BYakov/Rx-Tx_module/PCB/таблица.docx

Название | значение | ссылка | Цена за шт | доставка
С1 | 0.56 пФ
С2 | 330 пФ | https://procontact74.ru/01-elektronnyie-komponentyi-/41-kondensatory/416-smd/330-pf-41628 | 0.90р (от 1 шт)
С3 | 330 пФ | https://procontact74.ru/01-elektronnyie-komponentyi-/41-kondensatory/416-smd/330-pf-41628 | 0.90р (от 1 шт)
С4 | 47 нФ | https://procontact74.ru/01-elektronnyie-komponentyi-/41-kondensatory/chip-1206/chip-1206-----47-nf-50v | 0.90р (от 1 шт)
С5 | 47 нФ | https://procontact74.ru/01-elektronnyie-komponentyi-/41-kondensatory/chip-1206/chip-1206-----47-nf-50v | 0.90р (от 1 шт)
С6 | 47 нФ | https://procontact74.ru/01-elektronnyie-komponentyi-/41-kondensatory/chip-1206/chip-1206-----47-nf-50v | 0.90р (от 1 шт)
С7 | 330 пФ | https://procontact74.ru/01-elektronnyie-komponentyi-/41-kondensatory/416-smd/330-pf-41628 | 0.90р (от 1 шт)
С8 | 4.7n | https://procontact74.ru/01-elektronnyie-komponentyi-/41-kondensatory/416-smd/47-nf-41637 | 0.90р (от 1 шт)
C9 | 57n
C10 | 1u | https://procontact74.ru/01-elektronnyie-komponentyi-/41-kondensatory/416-smd/1-uf-41649 | 2.55 (от 1шт)
C11 | 2.2u
C12 | 0.1u | https://procontact74.ru/01-elektronnyie-komponentyi-/41-kondensatory/chip-1206/100-nf-1206-41658 | 2.55 (от 1шт)
C13 | 0.1u | https://procontact74.ru/01-elektronnyie-komponentyi-/41-kondensatory/chip-1206/100-nf-1206-41658 | 2.55 (от 1шт)
C14 | 0.01u | https://procontact74.ru/01-elektronnyie-komponentyi-/41-kondensatory/chip-1206/10-nf-1206-41657 | 1.7р (от 1шт)
C15 | 0.01u | https://procontact74.ru/01-elektronnyie-komponentyi-/41-kondensatory/chip-1206/10-nf-1206-41657 | 1.7р (от 1шт)
C16 | 0.01u | https://procontact74.ru/01-elektronnyie-komponentyi-/41-kondensatory/chip-1206/10-nf-1206-41657 | 1.7р (от 1шт)
C17 | 0.01u | https://procontact74.ru/01-elektronnyie-komponentyi-/41-kondensatory/chip-1206/10-nf-1206-41657 | 1.7р (от 1шт)
C18 | 1u | https://procontact74.ru/01-elektronnyie-komponentyi-/41-kondensatory/416-smd/1-uf-41649 | 2.55 (от 1шт)
C19 | 1u | https://procontact74.ru/01-elektronnyie-komponentyi-/41-kondensatory/416-smd/1-uf-41649 | 2.55 (от 1шт)
C20 | 0.01u | https://procontact74.ru/01-elektronnyie-komponentyi-/41-kondensatory/chip-1206/10-nf-1206-41657 | 1.7р (от 1шт)
C21 | 100p | https://procontact74.ru/01-elektronnyie-komponentyi-/41-kondensatory/416-smd/100-pf-41622 | 1.7р (от 1шт)
C22 | 100p | https://procontact74.ru/01-elektronnyie-komponentyi-/41-kondensatory/416-smd/100-pf-41622 | 1.7р (от 1шт)
C23 | 100p | https://procontact74.ru/01-elektronnyie-komponentyi-/41-kondensatory/416-smd/100-pf-41622 | 1.7р (от 1шт)
C24 | 100p | https://procontact74.ru/01-elektronnyie-komponentyi-/41-kondensatory/416-smd/100-pf-41622 | 1.7р (от 1шт)
C25 | 0.1u | https://procontact74.ru/01-elektronnyie-komponentyi-/41-kondensatory/chip-1206/100-nf-1206-41658 | 2.55 (от 1шт)
C26 | 100p | https://procontact74.ru/01-elektronnyie-komponentyi-/41-kondensatory/416-smd/100-pf-41622 | 1.7р (от 1шт)
C27 | 0.1u | https://procontact74.ru/01-elektronnyie-komponentyi-/41-kondensatory/chip-1206/100-nf-1206-41658 | 2.55 (от 1шт)
C28 | 100p | https://procontact74.ru/01-elektronnyie-komponentyi-/41-kondensatory/416-smd/100-pf-41622 | 1.7р (от 1шт)
C29 | 100p | https://procontact74.ru/01-elektronnyie-komponentyi-/41-kondensatory/416-smd/100-pf-41622 | 1.7р (от 1шт)
R1 | 680 | https://procontact74.ru/01-elektronnyie-komponentyi-/40-rezistory/chip-0603/chip-0603-----680-om-0603-rezistor | 0.45p (от 1шт)
R2 | 4.7K | https://procontact74.ru/01-elektronnyie-komponentyi-/40-rezistory/407-chip-0805/47-kom-40746 | 0.85р (от 1шт)
R3 | 180 | https://procontact74.ru/01-elektronnyie-komponentyi-/40-rezistory/chip-0603/160-om-0603-rezistor | 0.45p (от 1шт)
R4 | 10 | https://procontact74.ru/01-elektronnyie-komponentyi-/40-rezistory/chip-0603/10-om-0603-rezistor | 0.45p (от 1шт)
R5 | 97.6
R6 | 15 | https://procontact74.ru/01-elektronnyie-komponentyi-/40-rezistory/chip-0603/chip-0603------15-om-0603-rezistor | 0.45p (от 1шт)
R7 | 51.1
R8 | 50
R9
