BYakov/Rx-Tx_module/Доки/Belkin.pdf

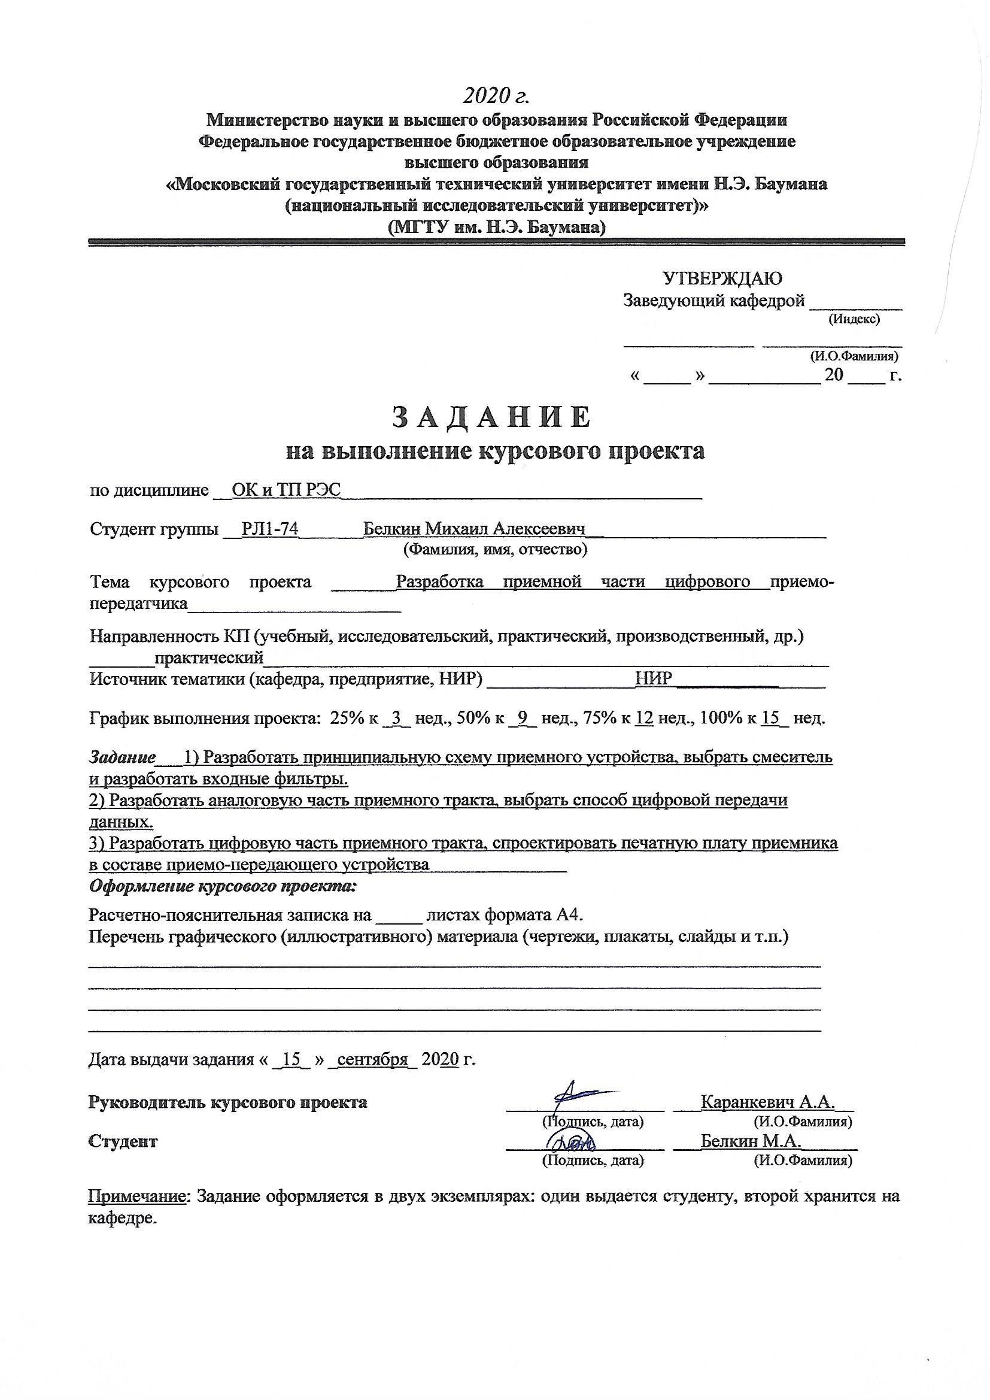
[picture p12: page 1]
