BYakov/Rx-Tx_module/Доки/Bonnet.pdf

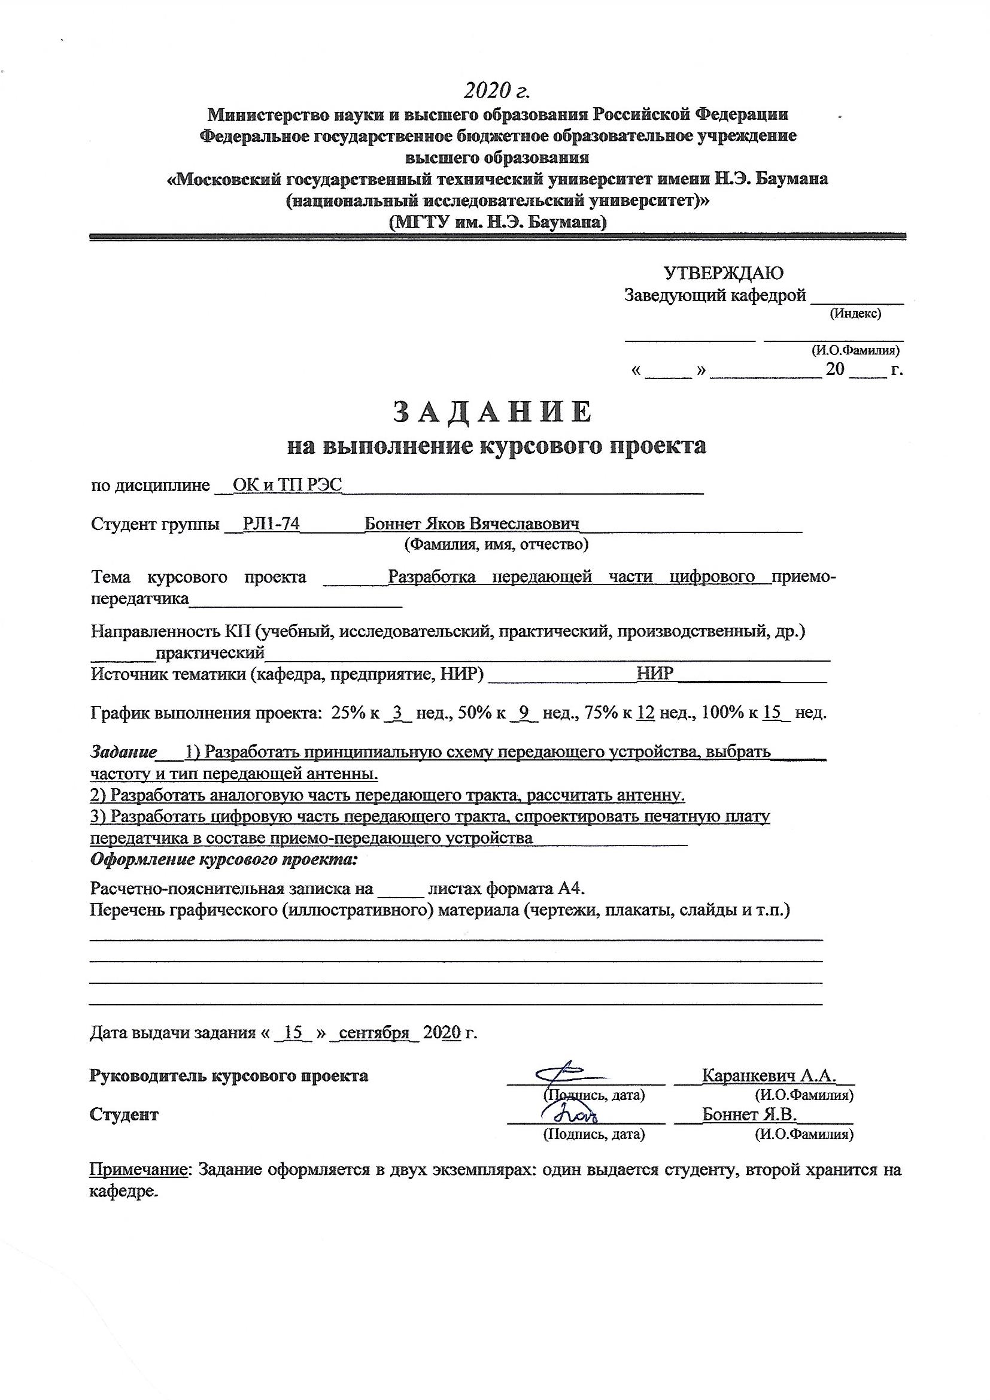
[picture p13: page 1]
