BYakov/Rx-Tx_module/PCB/BGU.bmp

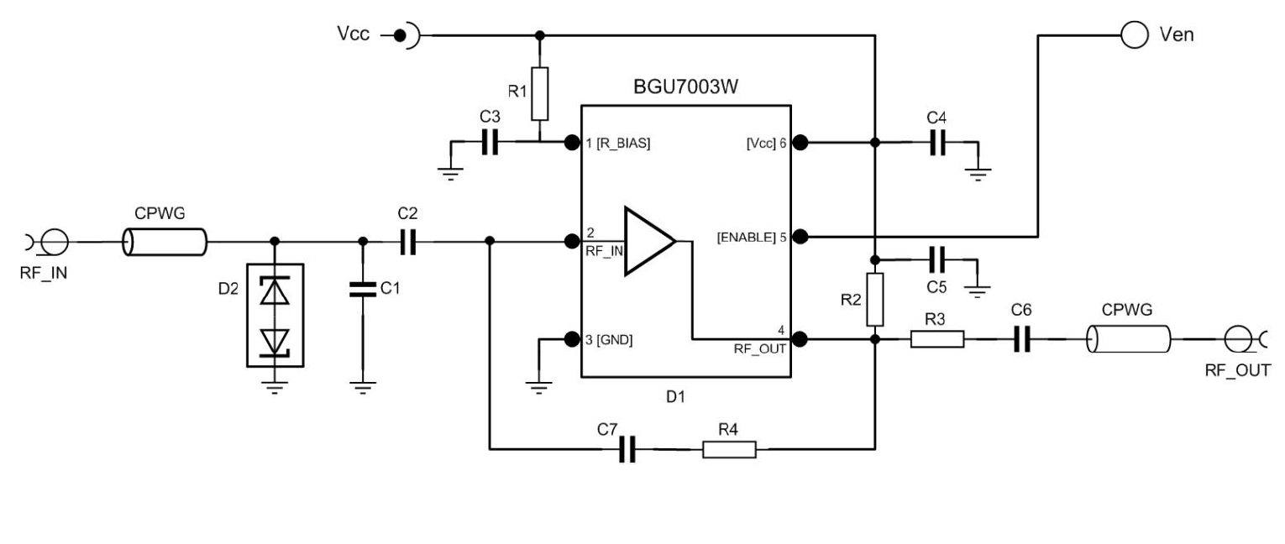
PCB/BGU.bmp
