BYakov/Rx-Tx_module/PCB/moustache-monocle-hairstyle.jpg

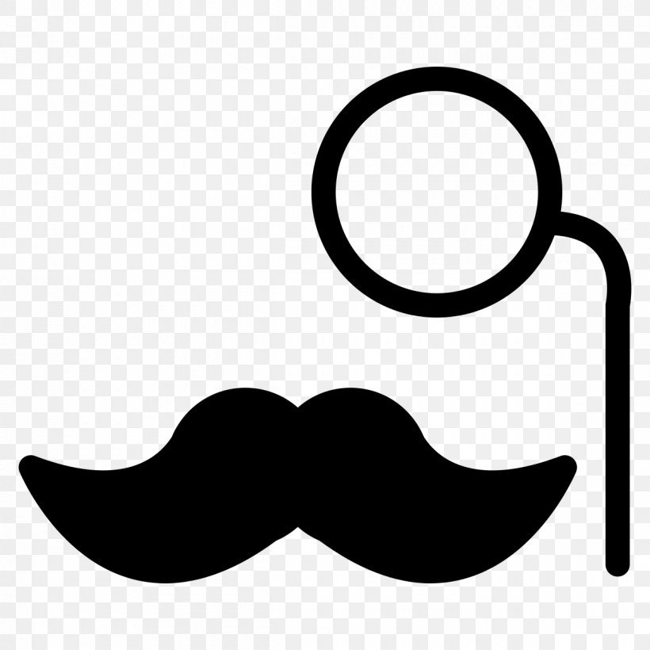
PCB/moustache-monocle-hairstyle.jpg
