BYakov/Rx-Tx_module/PCB/Screenshot_1.png

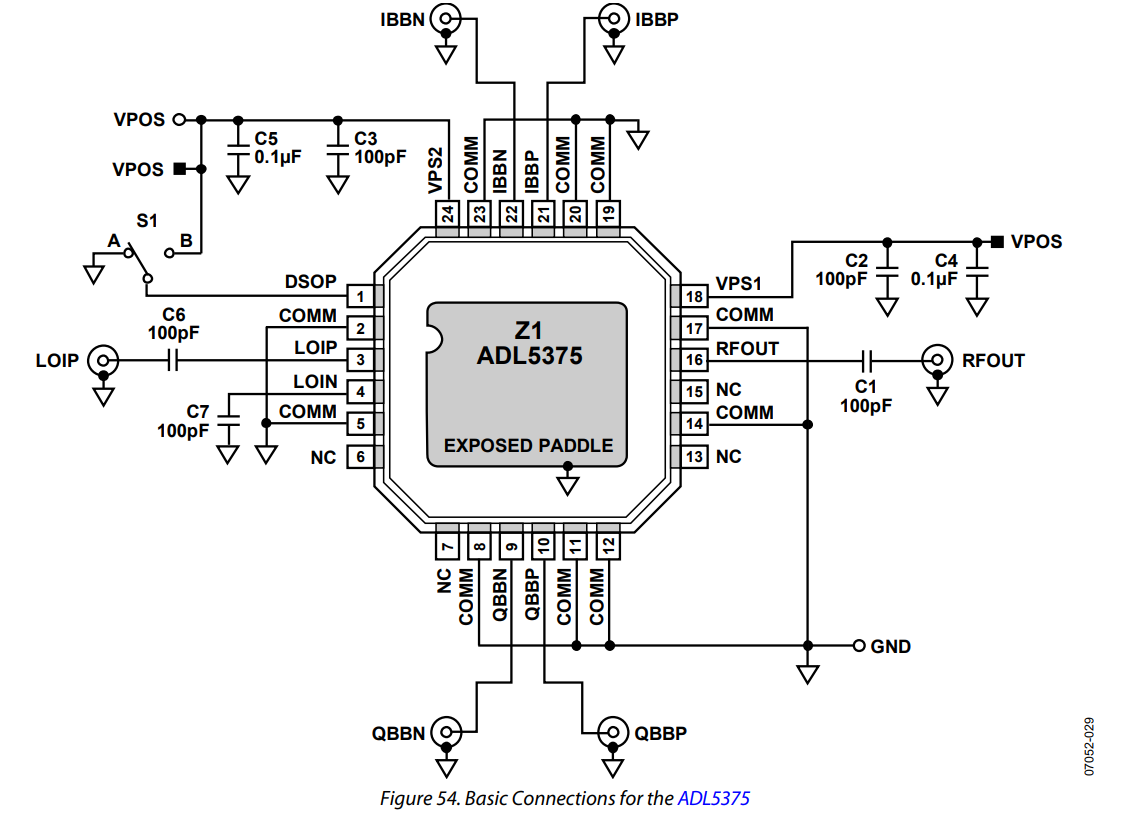
PCB/Screenshot_1.png
