BYakov/Rx-Tx_module/PCB/Screenshot_2.png

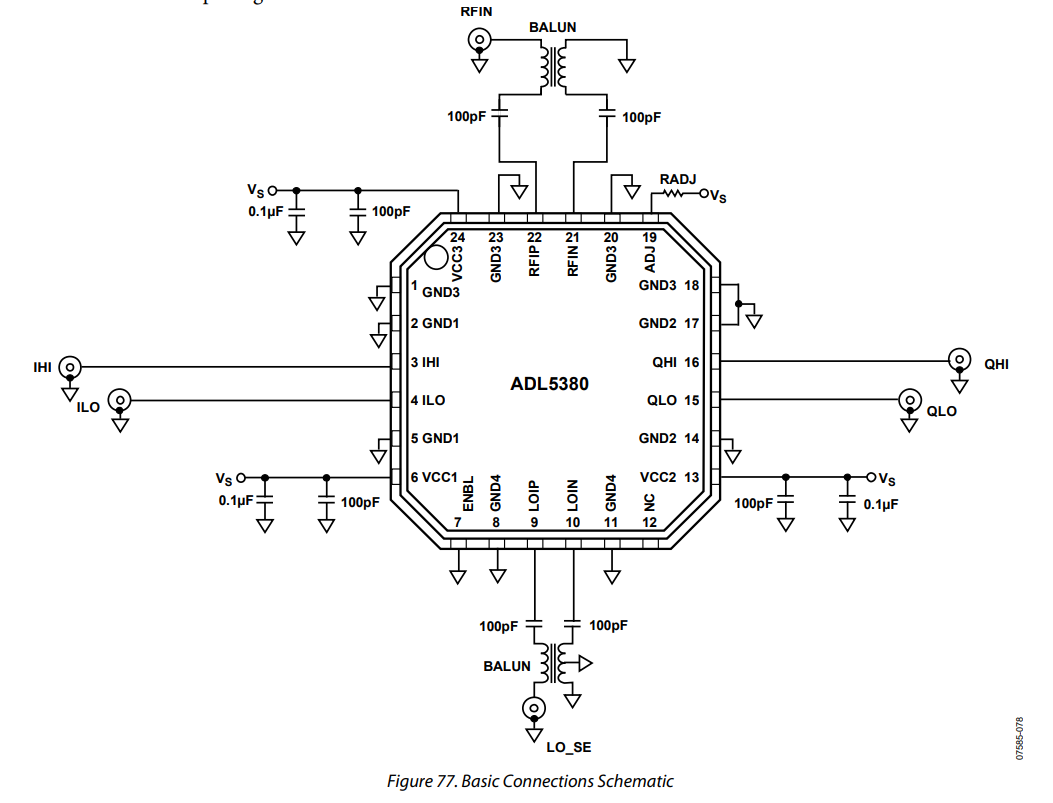
PCB/Screenshot_2.png
