BYakov/Rx-Tx_module/PCB/Screenshot_3.png

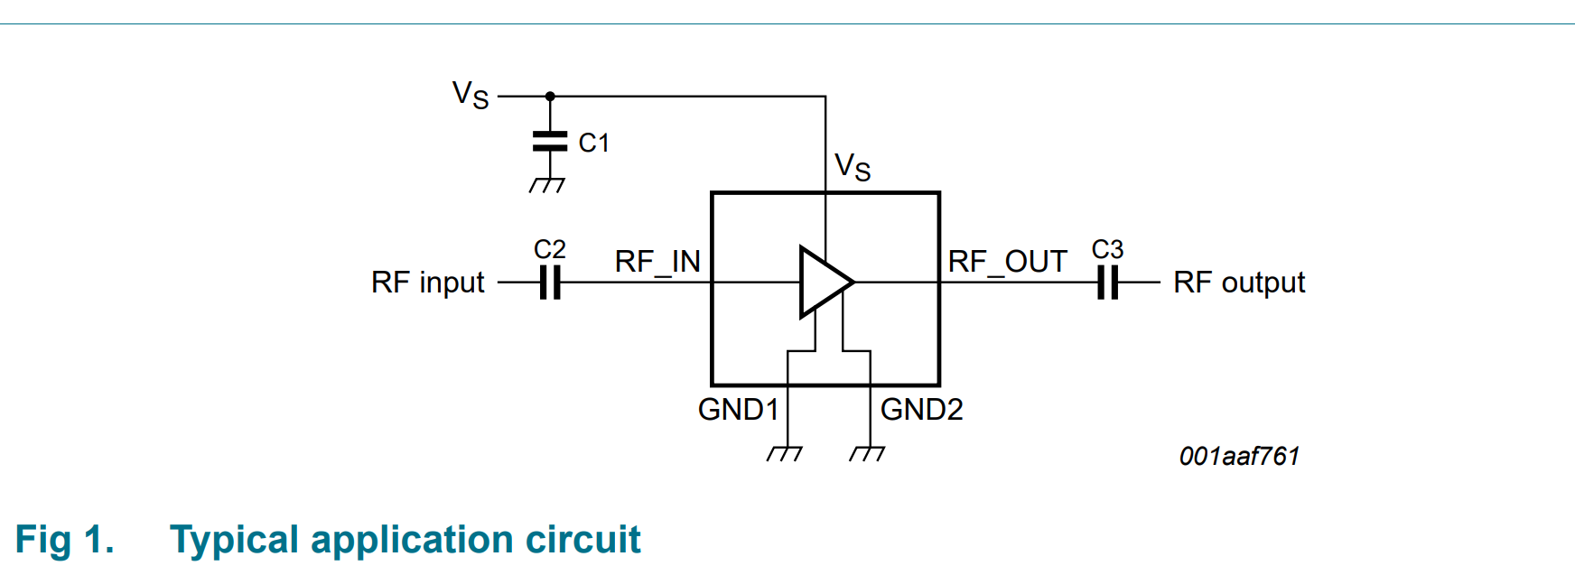
PCB/Screenshot_3.png
