BYakov/Rx-Tx_module/PCB/Screenshot_5.png

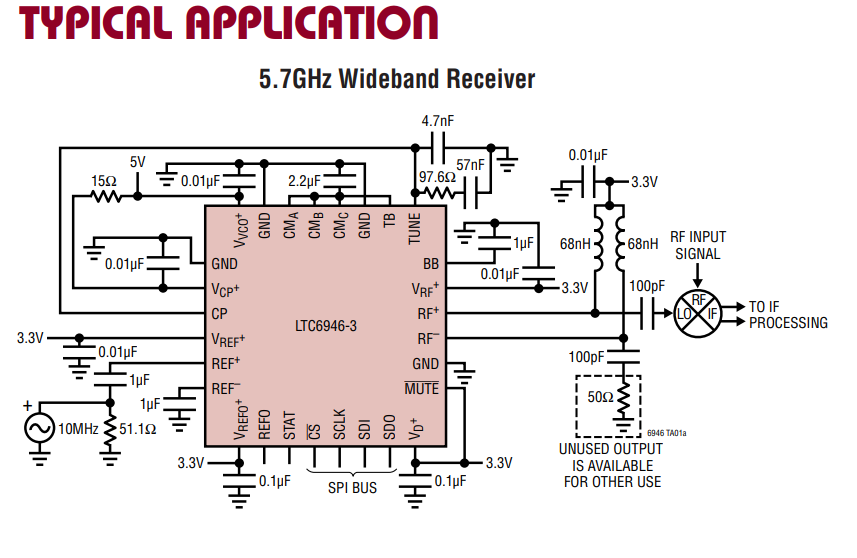
PCB/Screenshot_5.png
