BYakov/Rx-Tx_module/PCB/shark.png

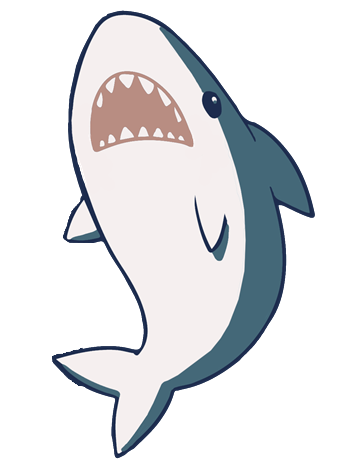
PCB/shark.png
