BYakov/Rx-Tx_module/PCB/номиналы для BGU.png

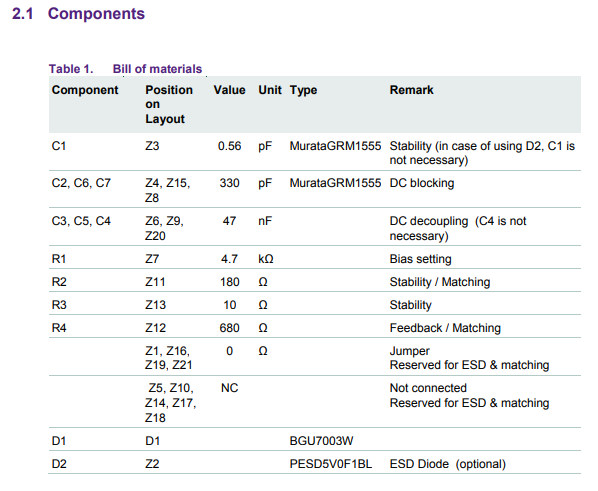
PCB/номиналы для BGU.png
