BYakov/Rx-Tx_module/Аналоговая часть/Разбор/20201021_194957.jpg

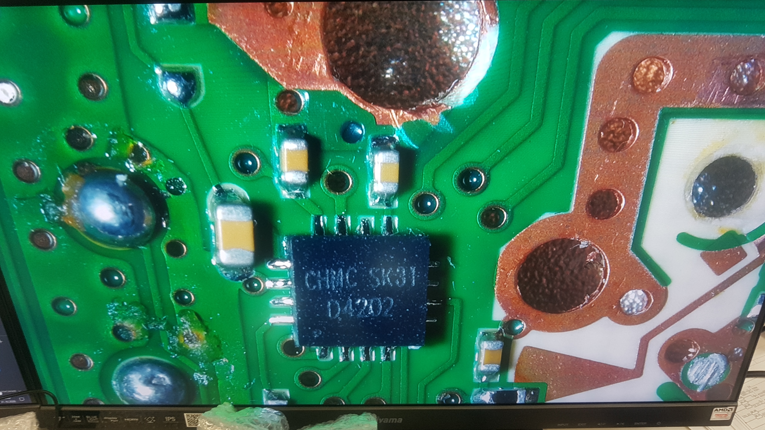
Аналоговая часть/Разбор/20201021_194957.jpg
