BYakov/Rx-Tx_module/Аналоговая часть/Разбор/20201021_195349.jpg

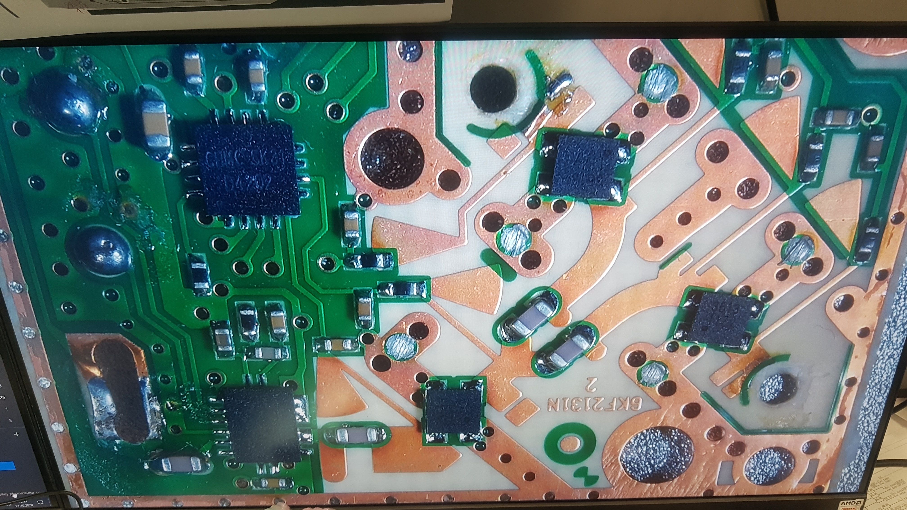
Аналоговая часть/Разбор/20201021_195349.jpg
