BYakov/Rx-Tx_module/Отчет Боннет/Групповая задержка.png

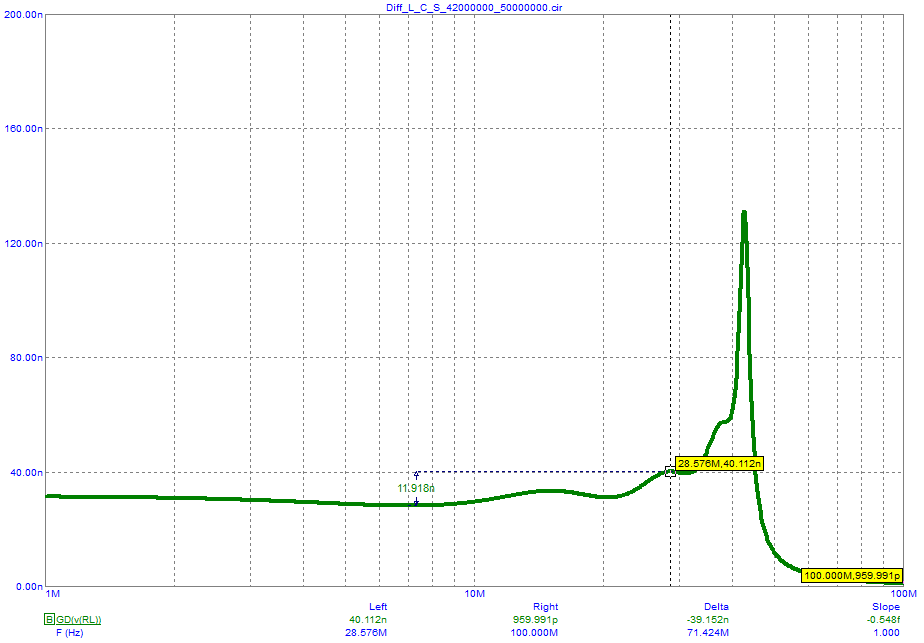
Отчет Боннет/Групповая задержка.png
