BYakov/Rx-Tx_module/Отчет Боннет/Зона найквиста.png

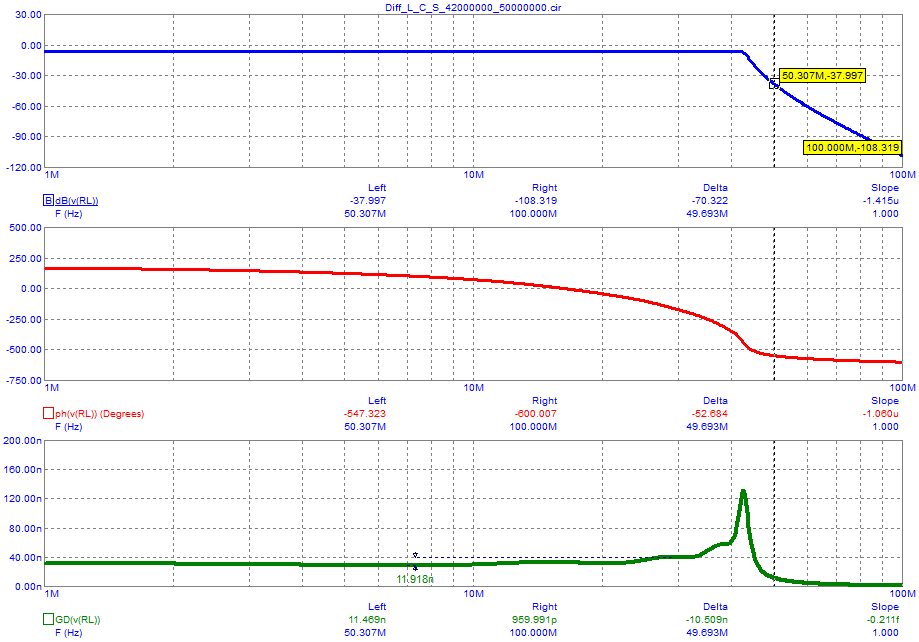
Отчет Боннет/Зона найквиста.png
