BYakov/Rx-Tx_module/Отчет Боннет/Класс печатных плат.png

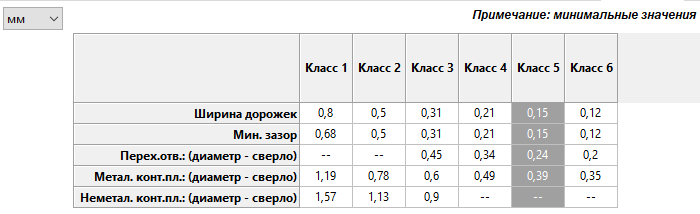
Отчет Боннет/Класс печатных плат.png
