BYakov/Rx-Tx_module/Отчет Боннет/Класс цепей.png

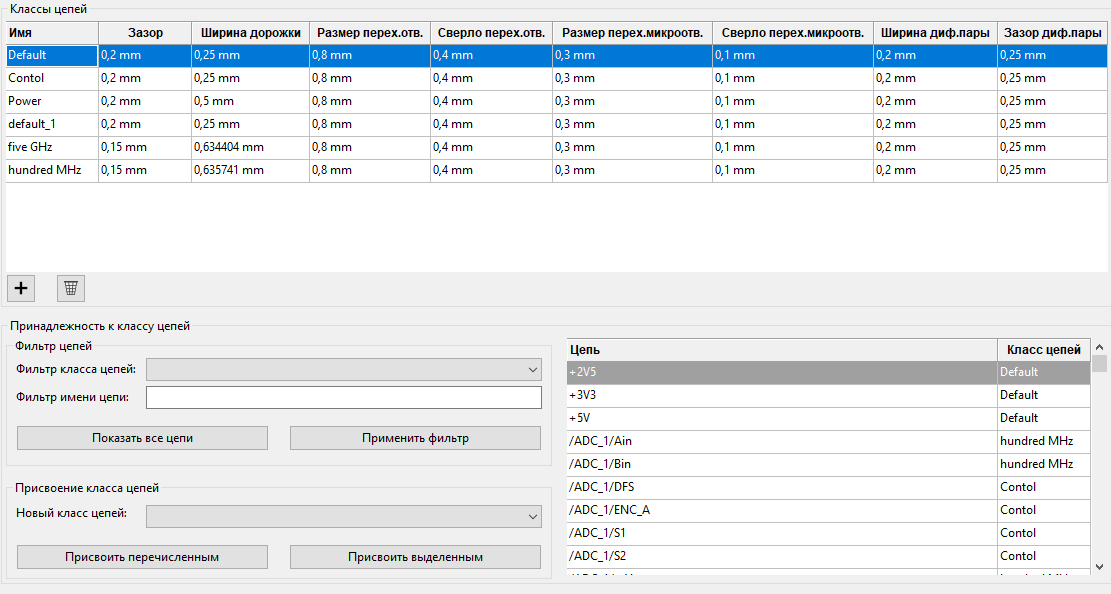
Отчет Боннет/Класс цепей.png
