BYakov/Rx-Tx_module/Отчет Боннет/МШУ усиление.PNG

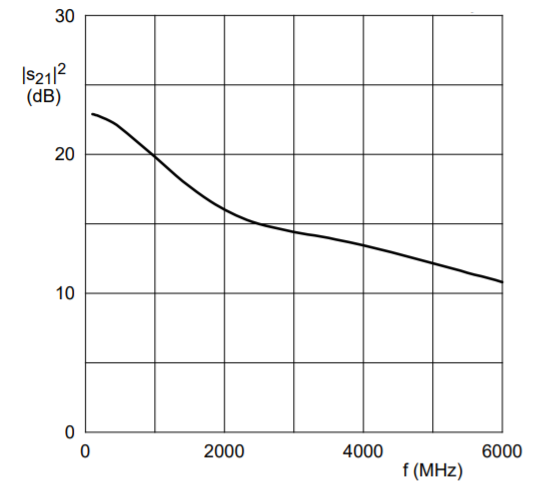
Отчет Боннет/МШУ усиление.PNG
