BYakov/Rx-Tx_module/Отчет Боннет/Не балансный.png

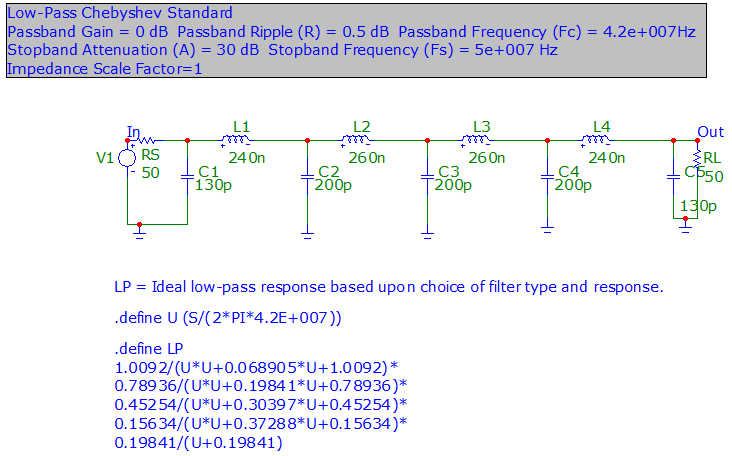
Отчет Боннет/Не балансный.png
