BYakov/Rx-Tx_module/Отчет Боннет/Обвязка АЦП.PNG

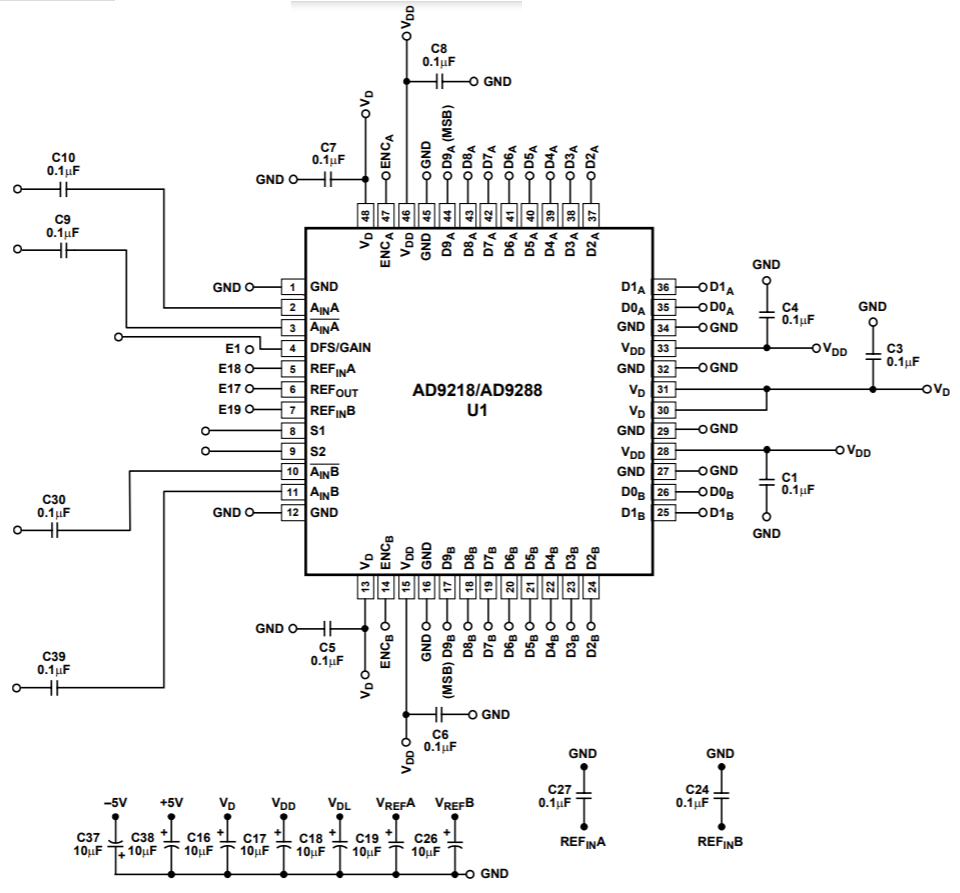
Отчет Боннет/Обвязка АЦП.PNG
