BYakov/Rx-Tx_module/Отчет Боннет/Обвязка генератора.PNG

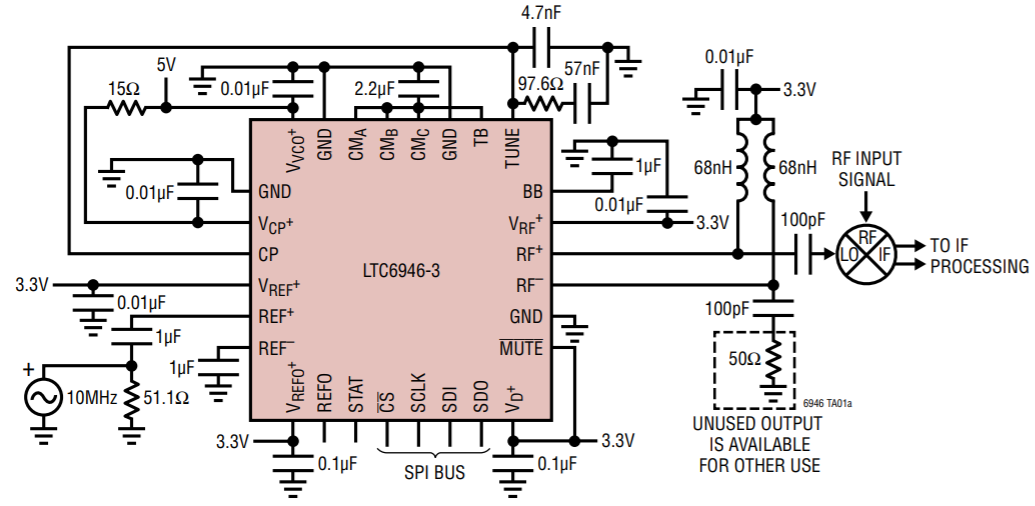
Отчет Боннет/Обвязка генератора.PNG
