BYakov/Rx-Tx_module/Отчет Боннет/Обвязка демодулятора.PNG

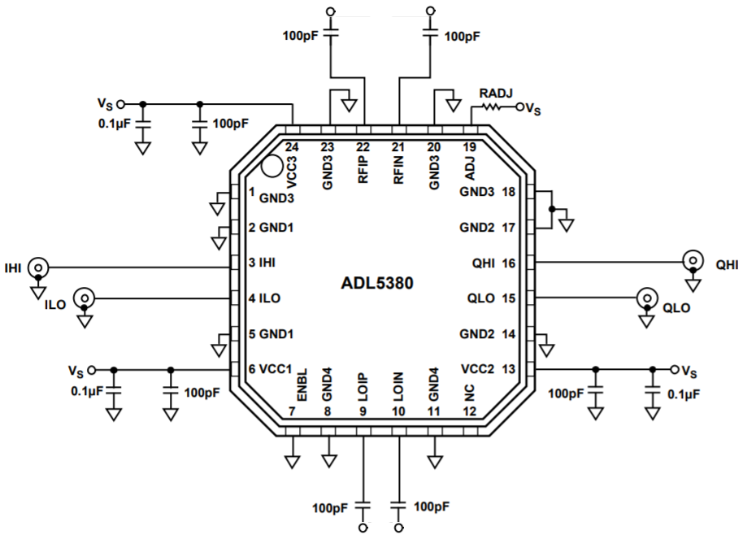
Отчет Боннет/Обвязка демодулятора.PNG
