BYakov/Rx-Tx_module/Отчет Боннет/Обвязка модулятора.PNG

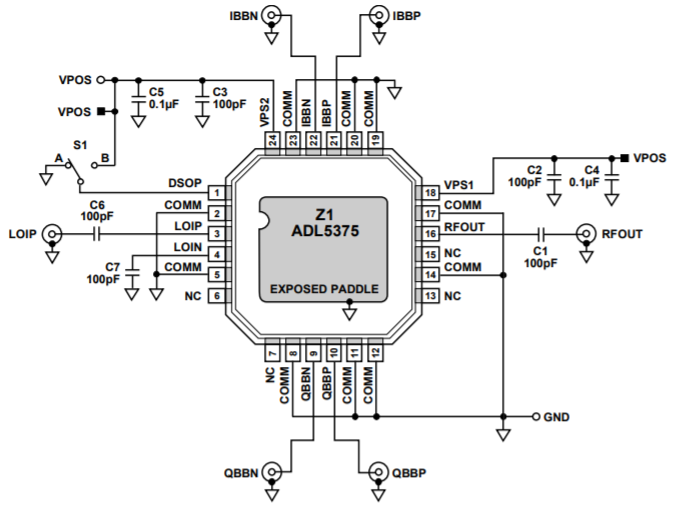
Отчет Боннет/Обвязка модулятора.PNG
