BYakov/Rx-Tx_module/Отчет Боннет/Обвязка МШУ.PNG

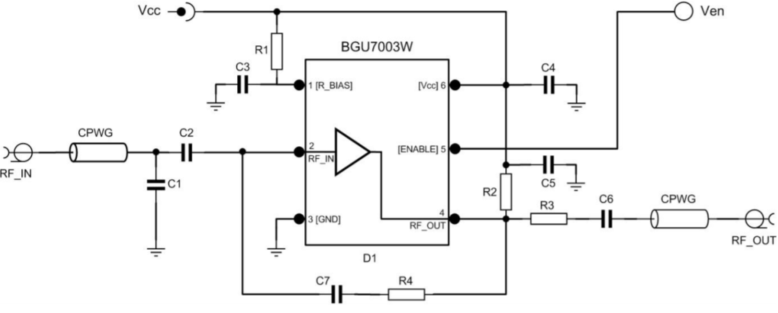
Отчет Боннет/Обвязка МШУ.PNG
