BYakov/Rx-Tx_module/Отчет Боннет/Обвязка оконечного усилителя.PNG

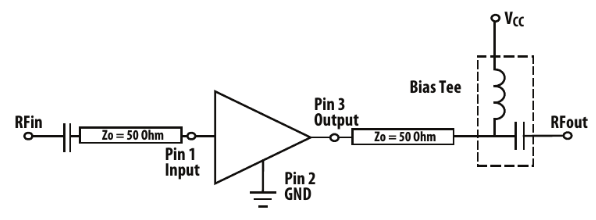
Отчет Боннет/Обвязка оконечного усилителя.PNG
