BYakov/Rx-Tx_module/Отчет Боннет/Обвязка стабилизатора.PNG

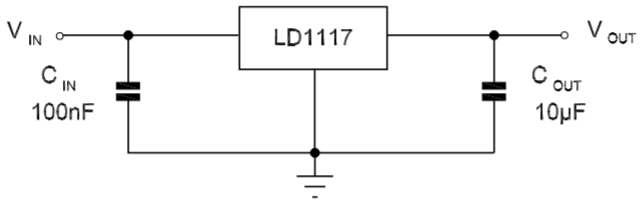
Отчет Боннет/Обвязка стабилизатора.PNG
