BYakov/Rx-Tx_module/Отчет Боннет/Обвязка УПЧ.PNG

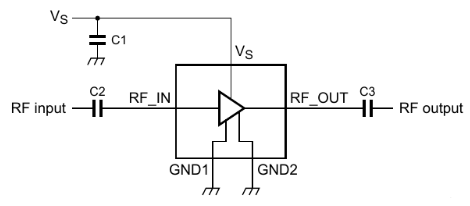
Отчет Боннет/Обвязка УПЧ.PNG
