BYakov/Rx-Tx_module/Отчет Боннет/Обвязка ЦАП.PNG

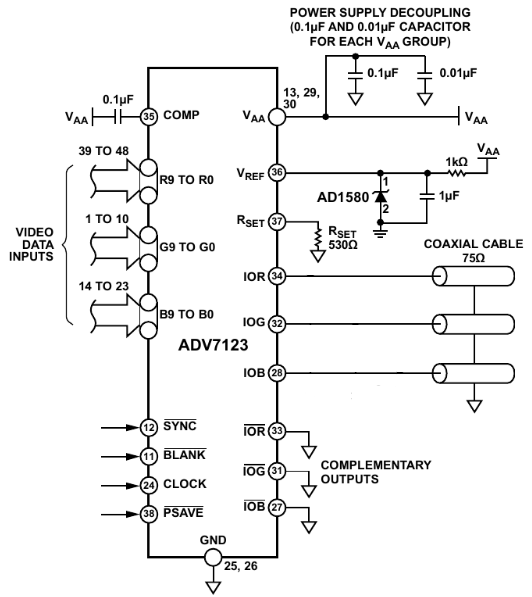
Отчет Боннет/Обвязка ЦАП.PNG
