BYakov/Rx-Tx_module/Отчет Боннет/План работ.png

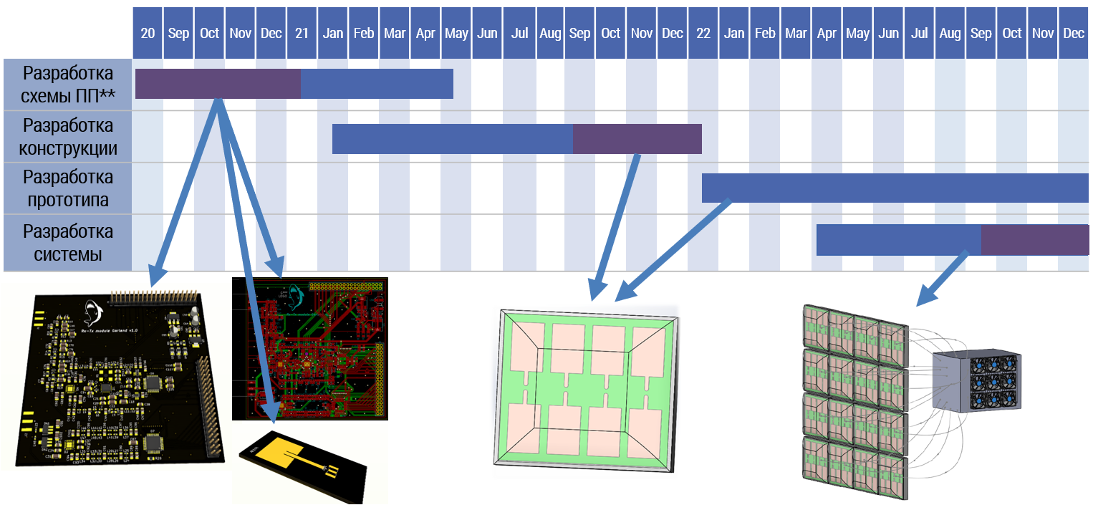
Отчет Боннет/План работ.png
