BYakov/Rx-Tx_module/Отчет Боннет/Расчет минимальной толщины дорожки.png

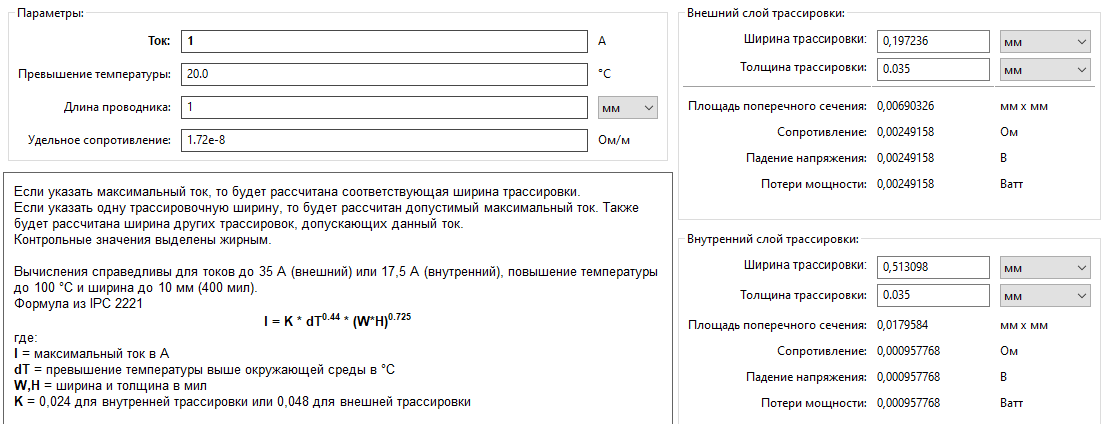
Отчет Боннет/Расчет минимальной толщины дорожки.png
