BYakov/Rx-Tx_module/Отчет Боннет/Система антеной решетки.png

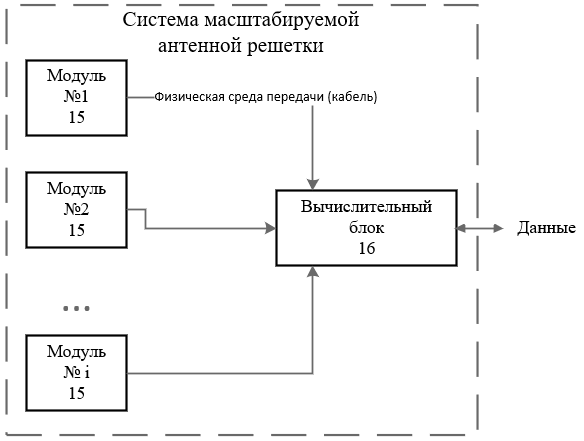
Отчет Боннет/Система антеной решетки.png
