BYakov/Rx-Tx_module/Отчет Боннет/Система питания.png

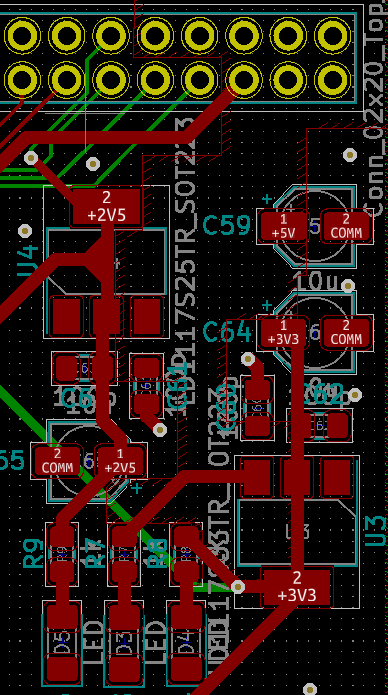
Отчет Боннет/Система питания.png
