BYakov/Rx-Tx_module/Отчет Боннет/Структурная схема.png

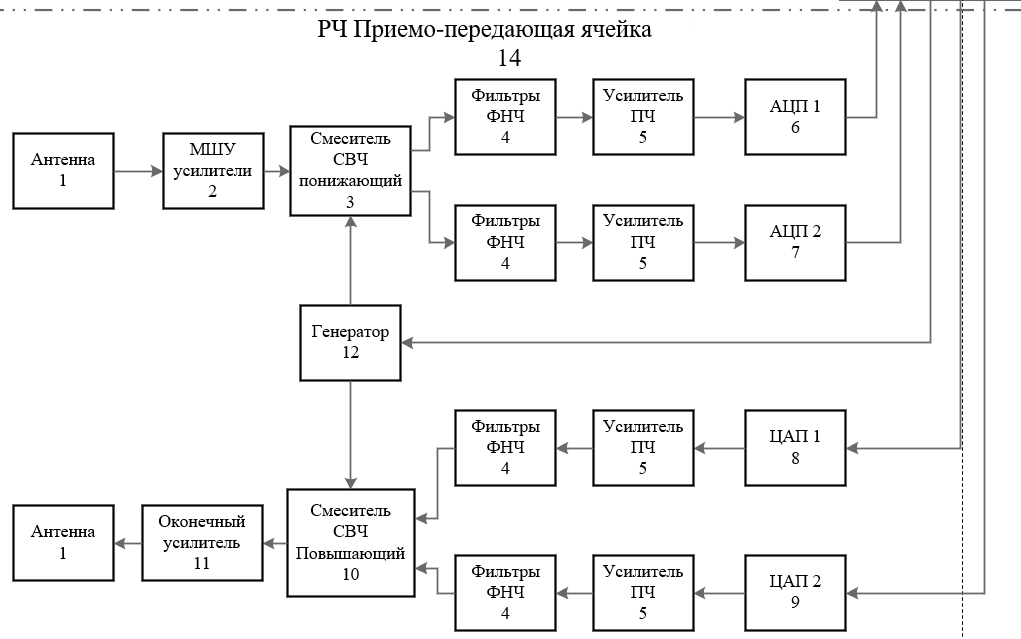
Отчет Боннет/Структурная схема.png
