BYakov/Rx-Tx_module/Отчет Боннет/Фильтр харки.png

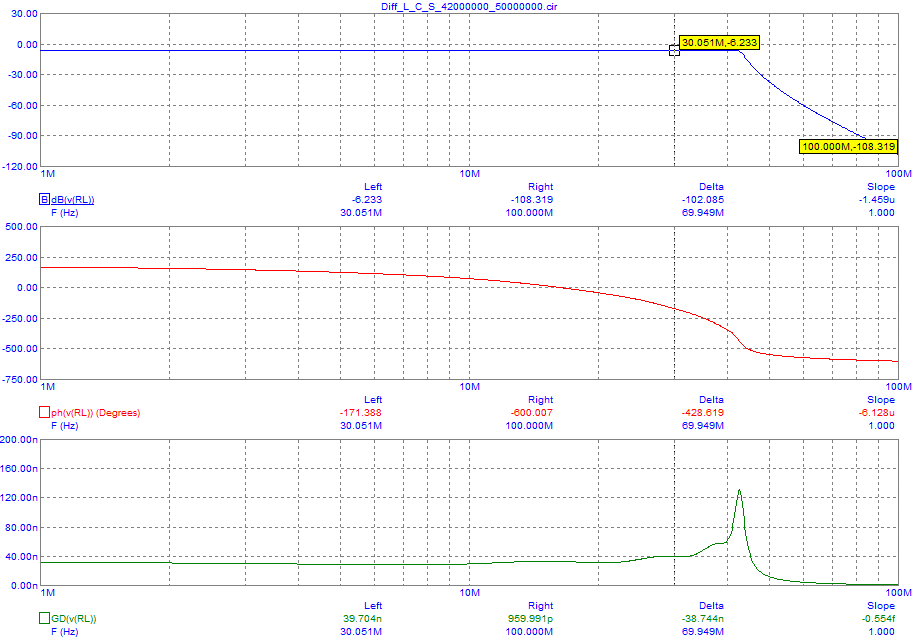
Отчет Боннет/Фильтр харки.png
