BYakov/Rx-Tx_module/Что берем 2 .xlsx

Название | Цена 1 шт. $ | шт | Итого $ | в рублях | Ссылка
Демодулятор | 6.2 | 5 | 31 |  | https://ru.mouser.com/ProductDetail/Analog-Devices/ADL5380ACPZ-R7?qs=BpaRKvA4VqHnymuMypz2jQ%3D%3D | али
малошумящий усилитель | 0.88 | 10 | 8.8 |  | https://ru.mouser.com/ProductDetail/NXP-Semiconductors/BGU7003W115 | маузер
усилитель ПЧ | 0.5 | 10 | 5 |  | https://ru.mouser.com/ProductDetail/NXP-Semiconductors/BGA2874115 | маузер
конечный усилитель |  |  | 0
Модулятор |  | 10 | 13.00 |  | https://ru.mouser.com/ProductDetail/Analog-Devices/ADL5375-05ACPZ-R7 | али
 |  |  |  |  | https://aliexpress.ru/item/32994098922.html | али
Ацп | 2.36 | 1 | 2.36 |  | https://ru.mouser.com/ProductDetail/Texas-Instruments/ADC08060CIMTX-NOPB?qs=7X5t%252BdzoRHD7S8IiCIl5tA%3D%3D | али | https://aliexpress.ru/item/4000733154847.html
Цап | 2.05 | 2 | 4.1 |  | https://ru.mouser.com/ProductDetail/Texas-Instruments/THS8136PHP?qs=h8kCHL4kpM6PGdv7%2FQwRxA%3D%3D | али | https://aliexpress.ru/item/32966115439.html
Гун с ФАПЧ | 11.58 | 1 | 11.58 |  | https://aliexpress.ru/item/4000384807655.html | али
Фильтры ПАВ
Рассыпуха (динамично)
Всего $ |  |  | 75.84
В рублях | 76.36 |  | 5791.1424
