BYakov/Rx-Tx_module/Модель/Sborka_Reshyotki/Сборка1.SLDASM

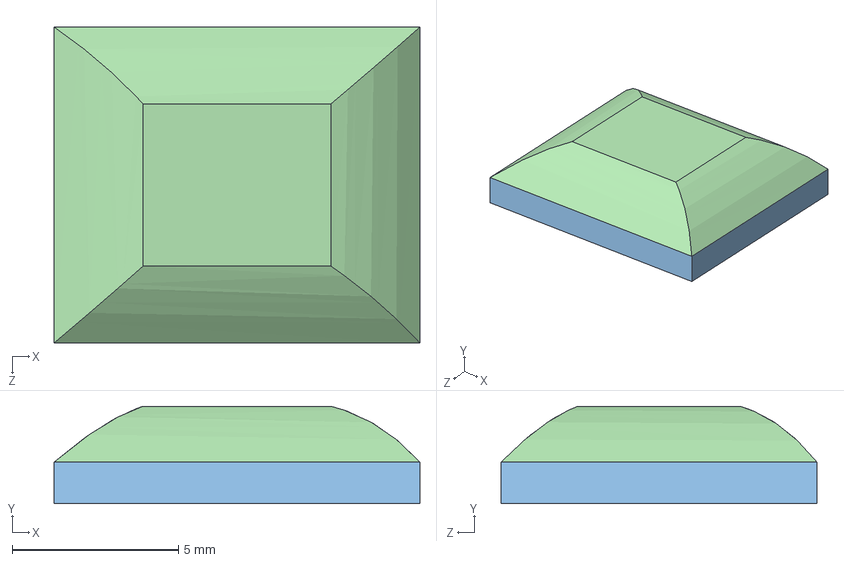
[picture p48: CAD file, 2020-12-24]
Модель/Sborka_Reshyotki/Сборка1.SLDASM
11.0 x 2.93 x 9.50 mm
Ntrcnjkbn
Антенна x 8
Корпус
Крышка
