BYakov/Rx-Tx_module/Модель/Sborka_Reshyotki/Сборка2.SLDASM

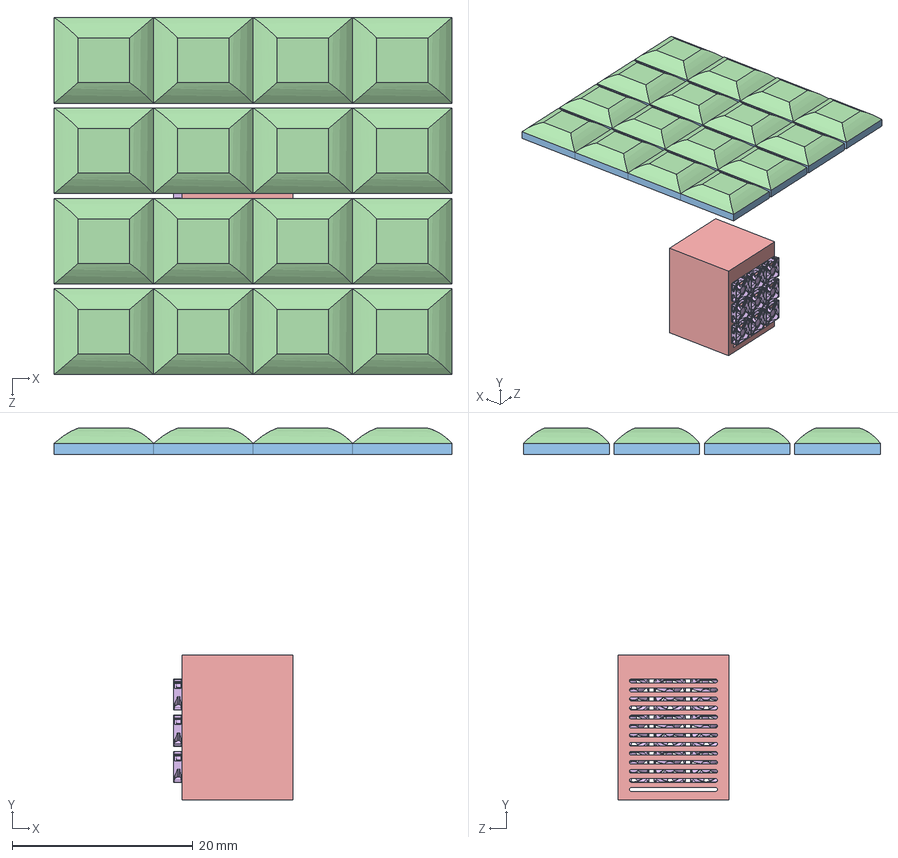
[picture p49: CAD file, 2020-12-24]
Модель/Sborka_Reshyotki/Сборка2.SLDASM
44.0 x 41.1 x 39.5 mm
Ntrcnjkbn x 16
Антенна x 128
Корпус x 16
Крышка x 16
Деталь1^Сборка2
User Library-ex-00000-002 x 9
