BYakov/Rx-Tx_module/Модель/Sborka_Reshyotki/User Library-computer g5 new.SLDPRT

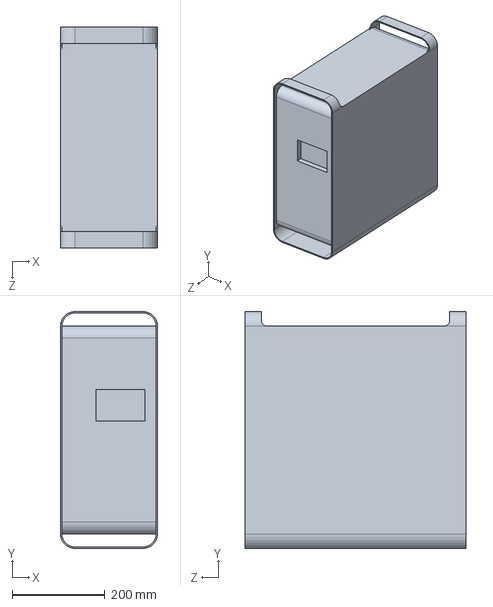
[picture p50: CAD file, 2020-12-24]
Модель/Sborka_Reshyotki/User Library-computer g5 new.SLDPRT
209.5 x 511.2 x 476.2 mm
