BYakov/Rx-Tx_module/Модель/User Library-CRM100/User Library-CRM100.sldprt

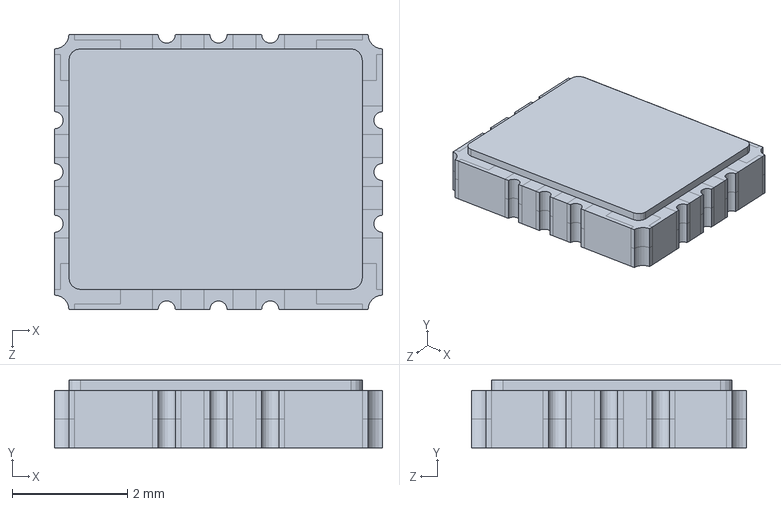
[picture p51: CAD file, 2020-12-24]
Модель/User Library-CRM100/User Library-CRM100.sldprt
5.70 x 1.18 x 4.78 mm
