BYakov/Rx-Tx_module/Модель/User Library-MCP3910 4x4 QNF/User Library-MCP3910 4x4 QNF.sldprt

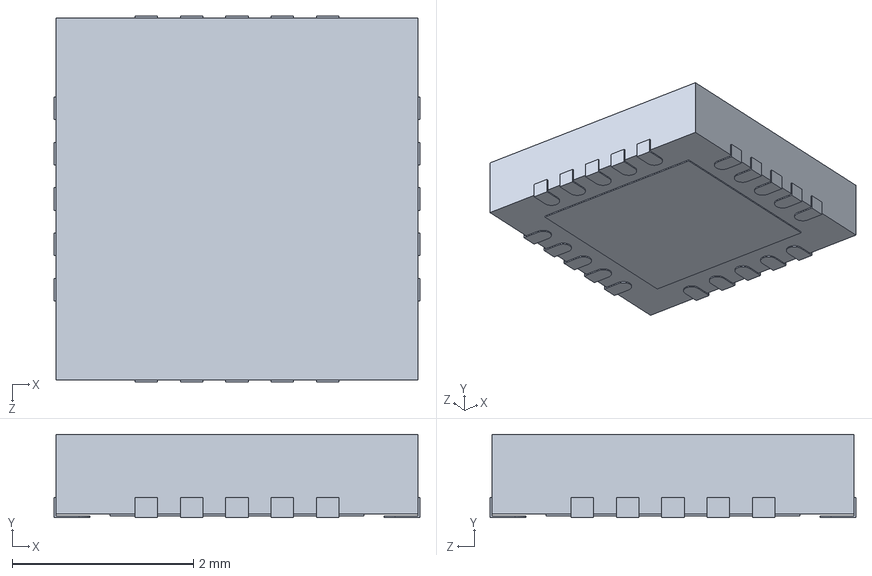
[picture p52: CAD file, 2020-12-24]
Модель/User Library-MCP3910 4x4 QNF/User Library-MCP3910 4x4 QNF.sldprt
4.04 x 0.92 x 4.04 mm
