BYakov/Rx-Tx_module/Модель/Sborka_Reshyotki/Ntrcnjkbn.SLDPRT

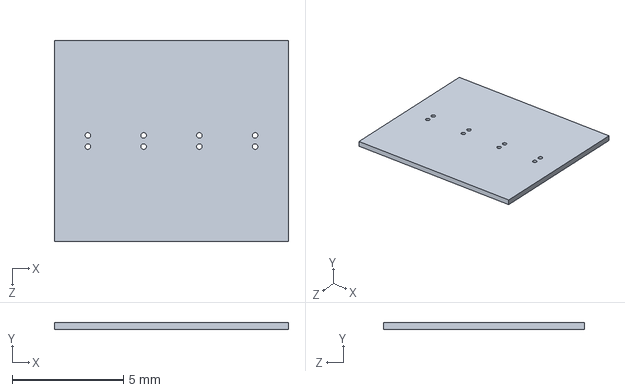
[picture p53: CAD file, 2020-12-24]
Модель/Sborka_Reshyotki/Ntrcnjkbn.SLDPRT
10.5 x 0.3 x 9.00 mm
