BYakov/Rx-Tx_module/Модель/Sborka_Reshyotki/Корпус.SLDPRT

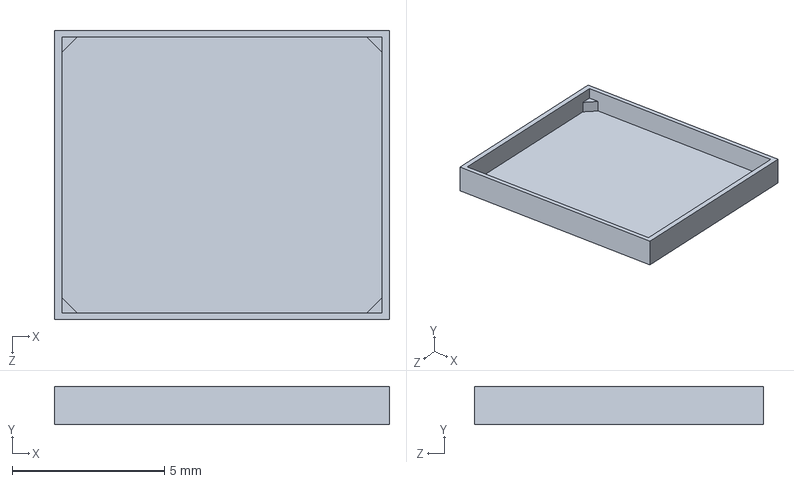
[picture p54: CAD file, 2020-12-24]
Модель/Sborka_Reshyotki/Корпус.SLDPRT
11.0 x 1.25 x 9.50 mm
