BYakov/Rx-Tx_module/Модель/Sborka_Reshyotki/Антенна.SLDPRT

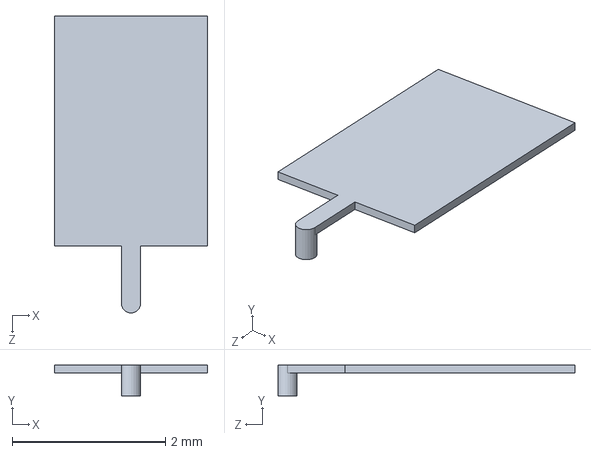
[picture p55: CAD file, 2020-12-24]
Модель/Sborka_Reshyotki/Антенна.SLDPRT
2.00 x 0.4 x 3.88 mm
