BYakov/Rx-Tx_module/Модель/Sborka_Reshyotki/User Library-ex-00000-002.sldprt

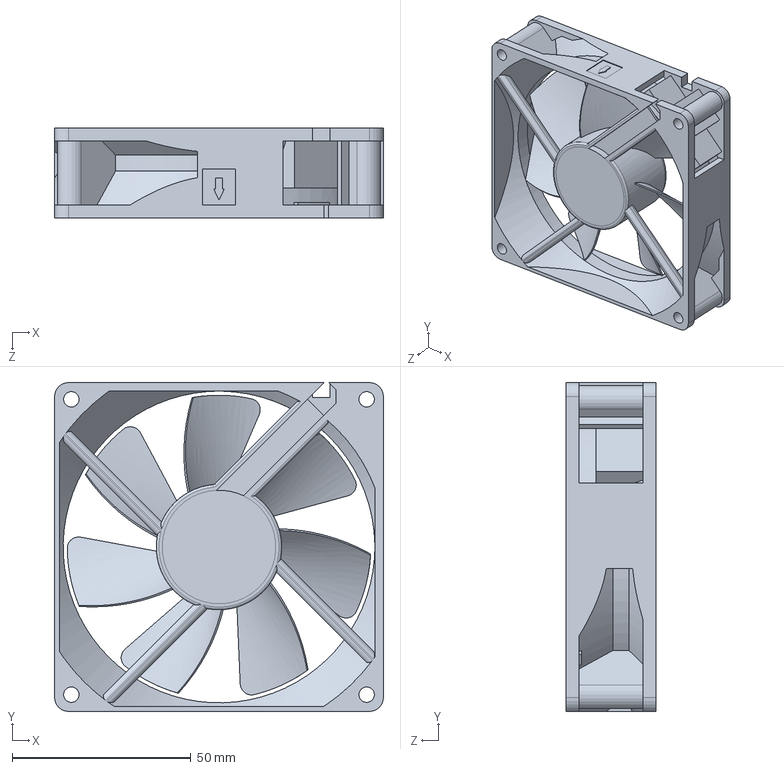
[picture p56: CAD file, 2020-12-24]
Модель/Sborka_Reshyotki/User Library-ex-00000-002.sldprt
91.9 x 91.9 x 25.1 mm
