BYakov/Rx-Tx_module/Модель/Sborka_Reshyotki/Крышка.SLDPRT

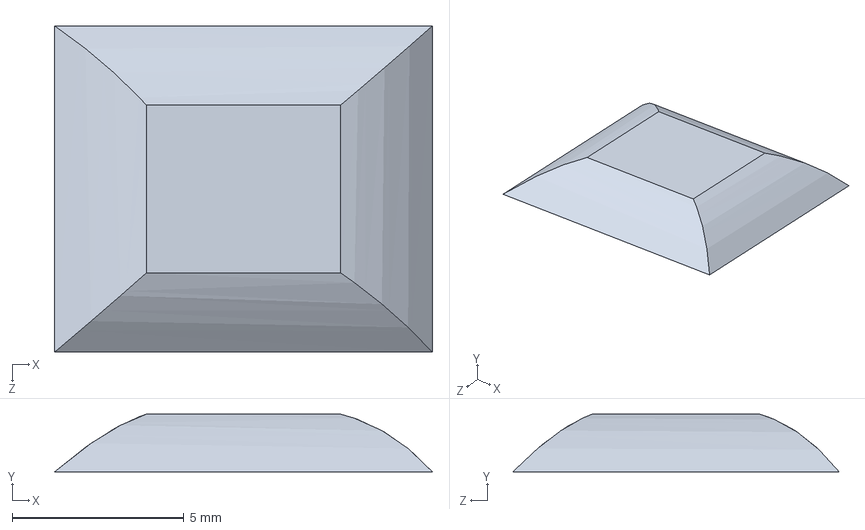
[picture p57: CAD file, 2020-12-24]
Модель/Sborka_Reshyotki/Крышка.SLDPRT
11.0 x 1.68 x 9.50 mm
