BYakov/Rx-Tx_module/PCB/SDR/Schematic_PDF/SDR-Sch_Belkin.pdf

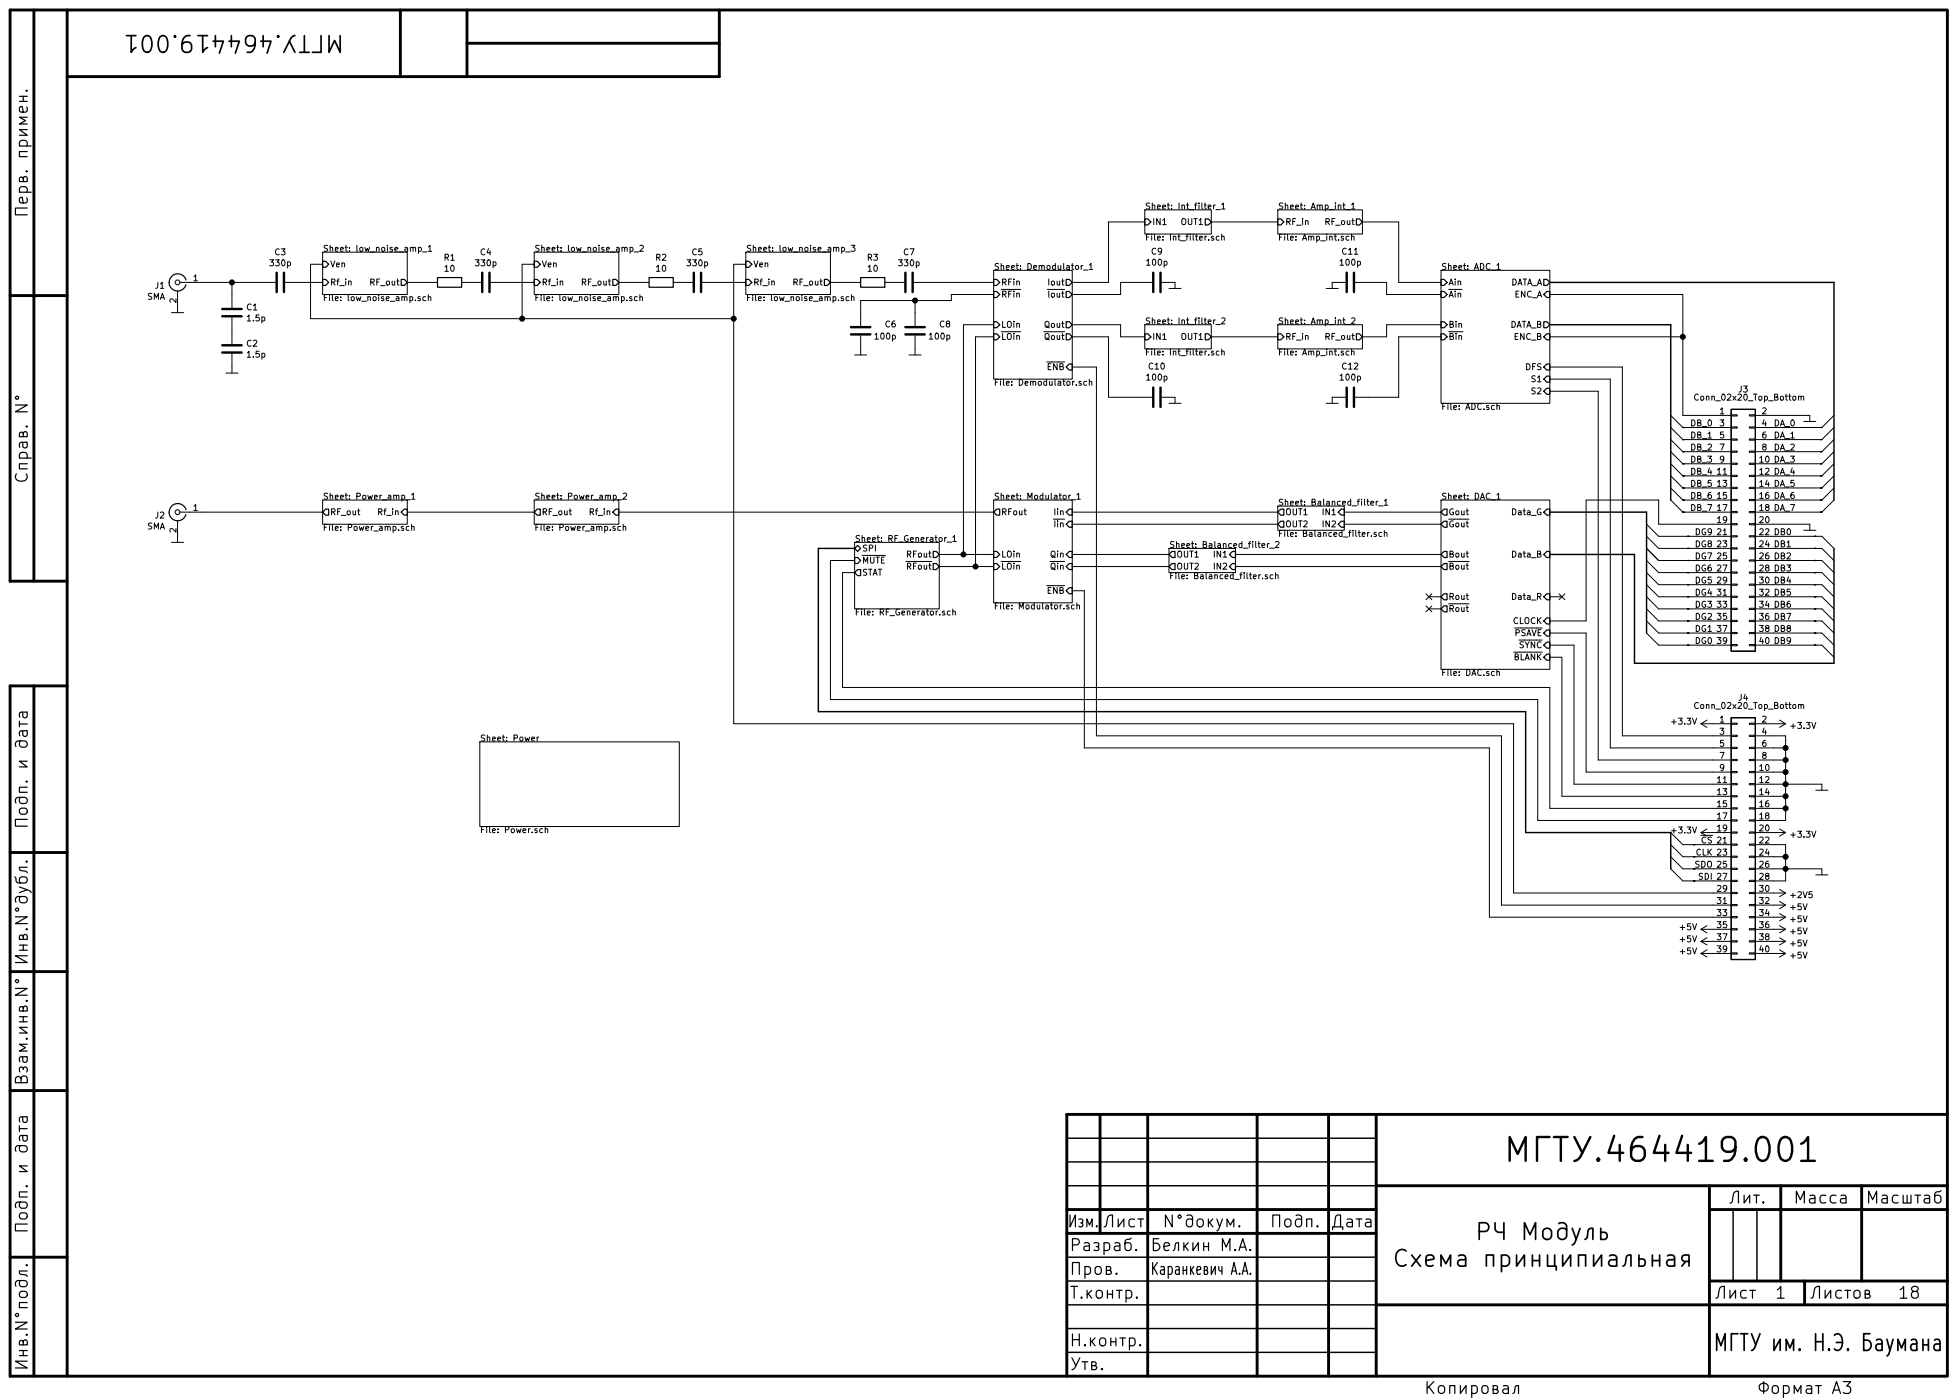
[picture p58: page 1]

S1S2 Ain Ain Bin Bin Sheet: low_noise_amp_3

BLANK Rout Gout Bout Sheet: Demodulator_1 File: Demodulator.sch
Iout Qout Qout RFin RFin

Sheet: Modulator_1 File: Modulator.sch

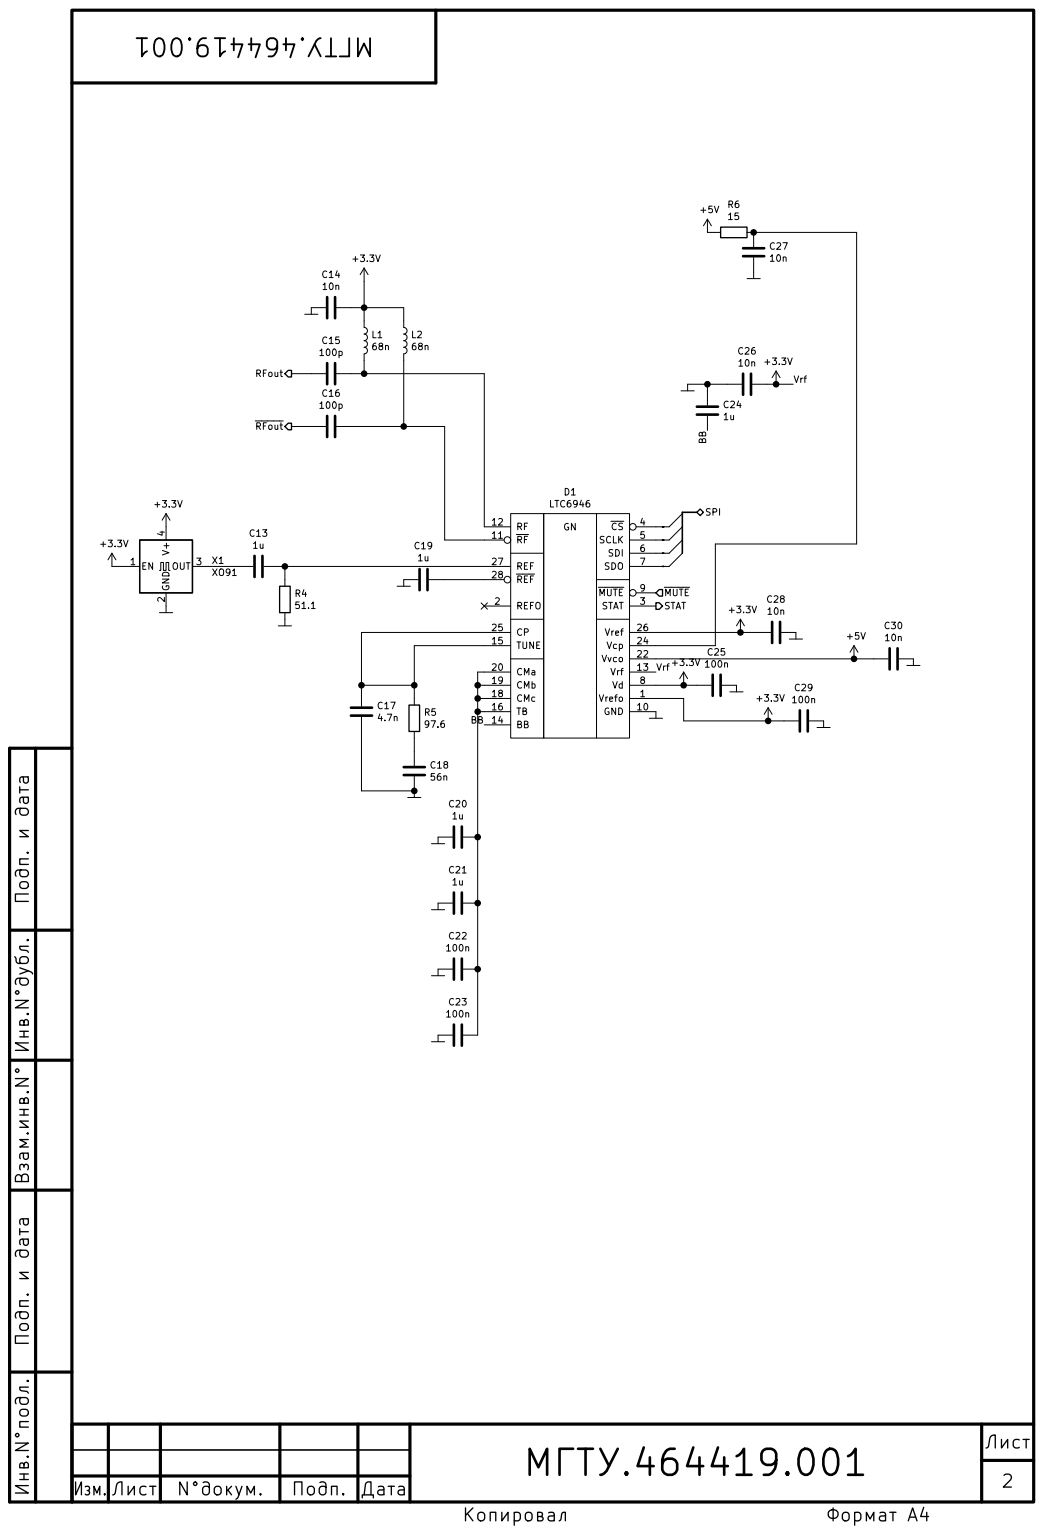
[picture p59: page 2]

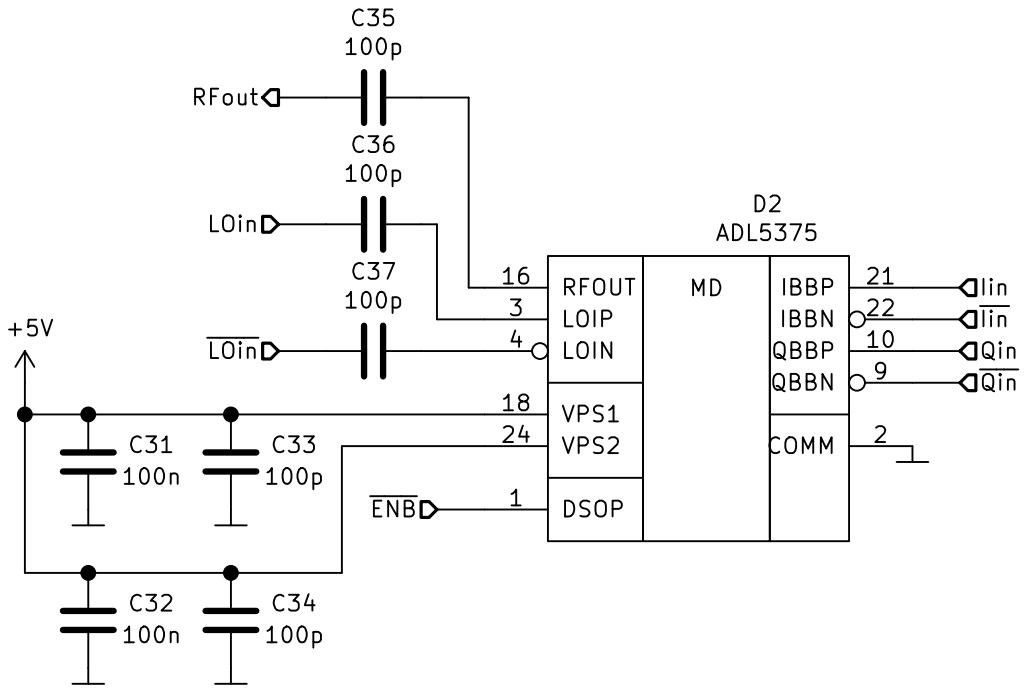
[picture p60: page 3]

IinQin Qin RFout LOin

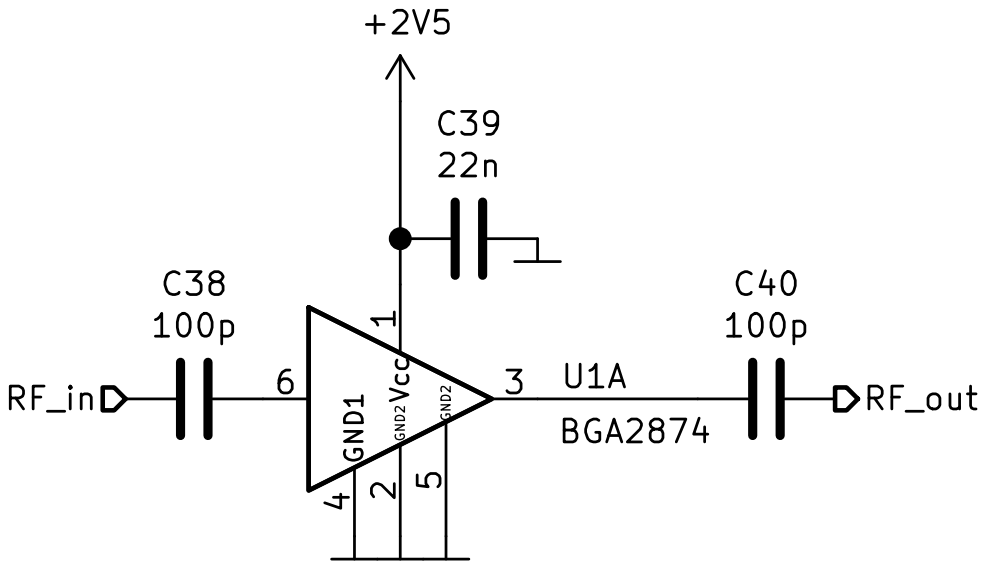
[picture p61: page 4]

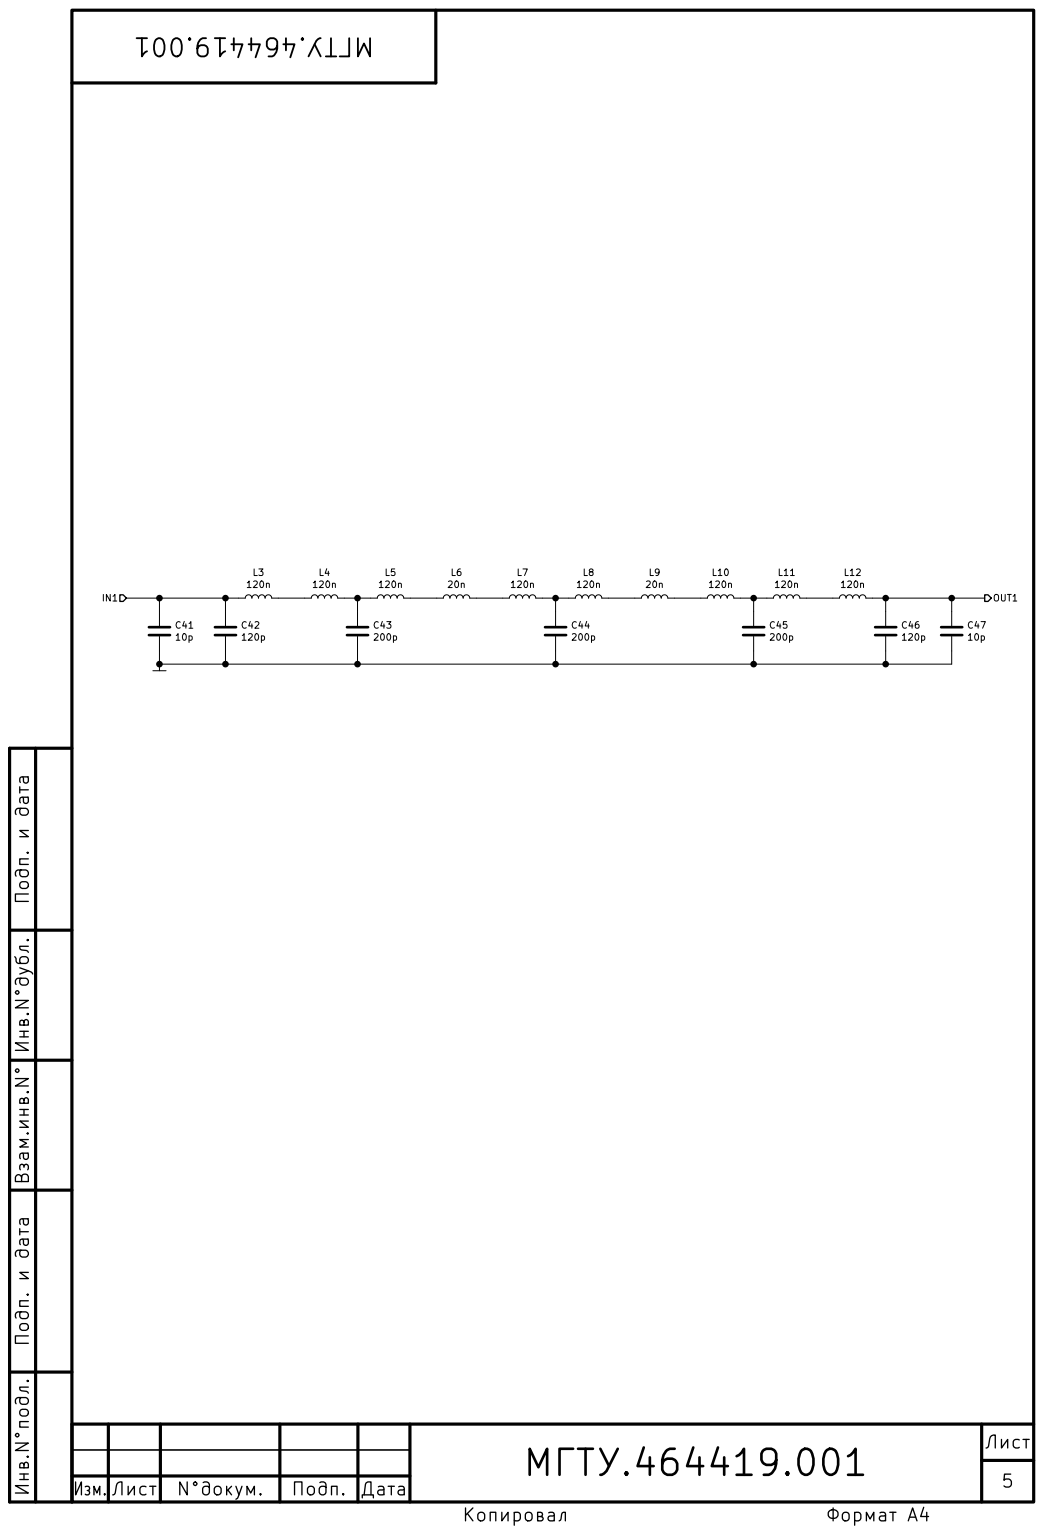
[picture p62: page 5]

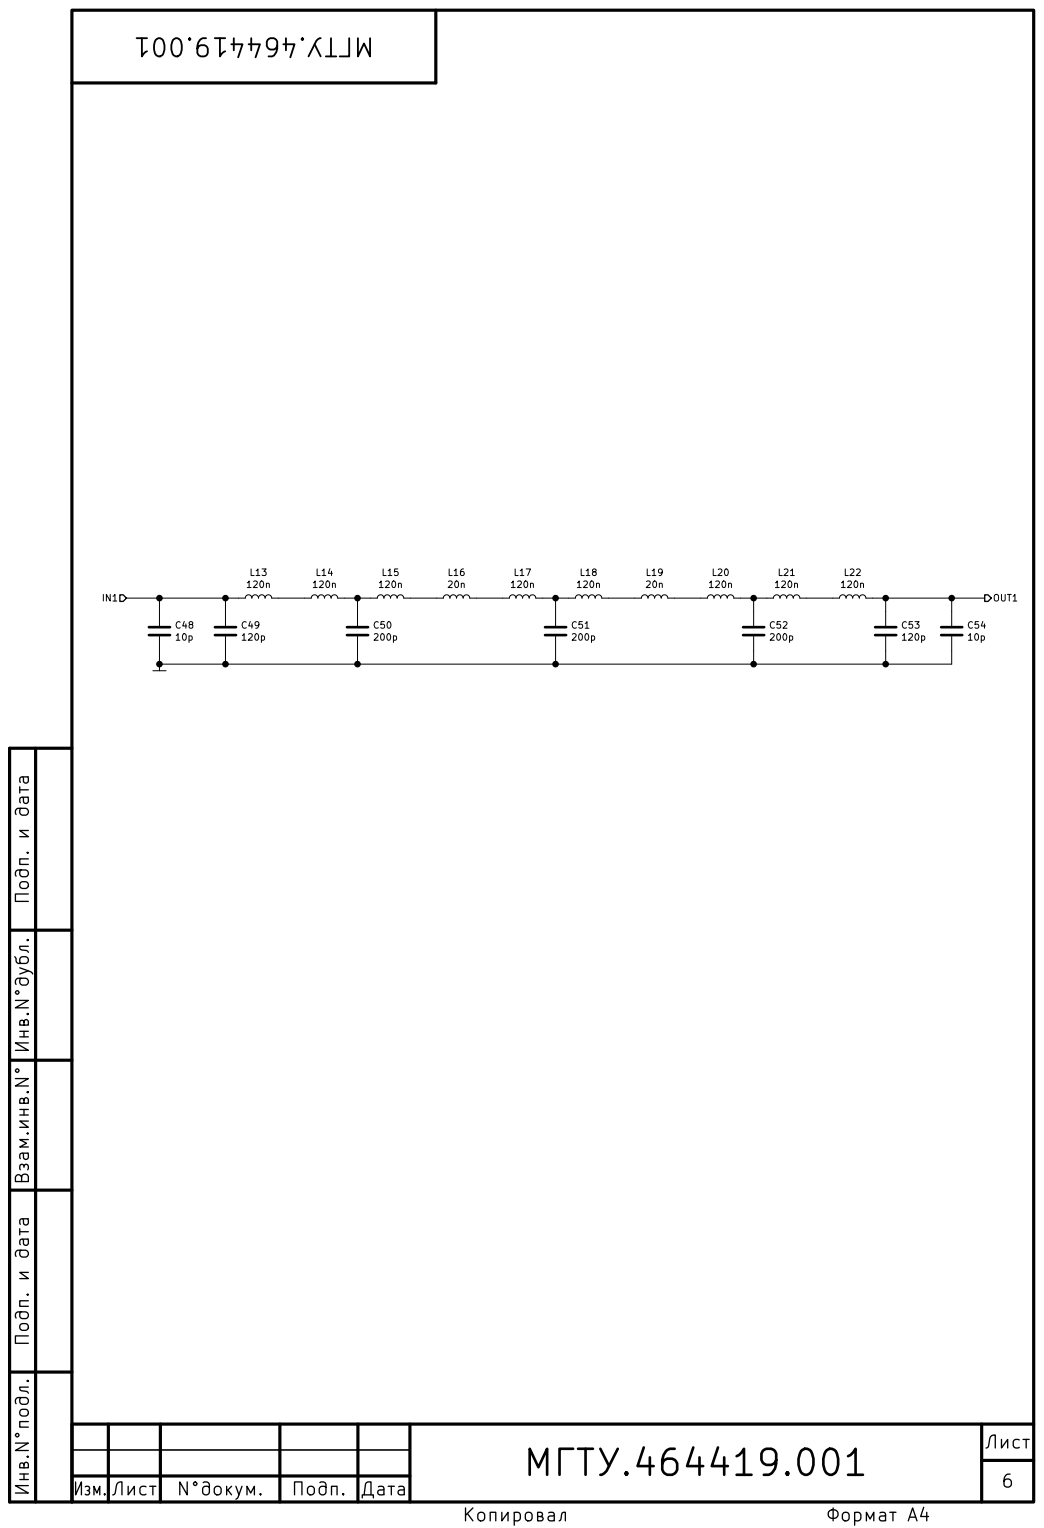
[picture p63: page 6]

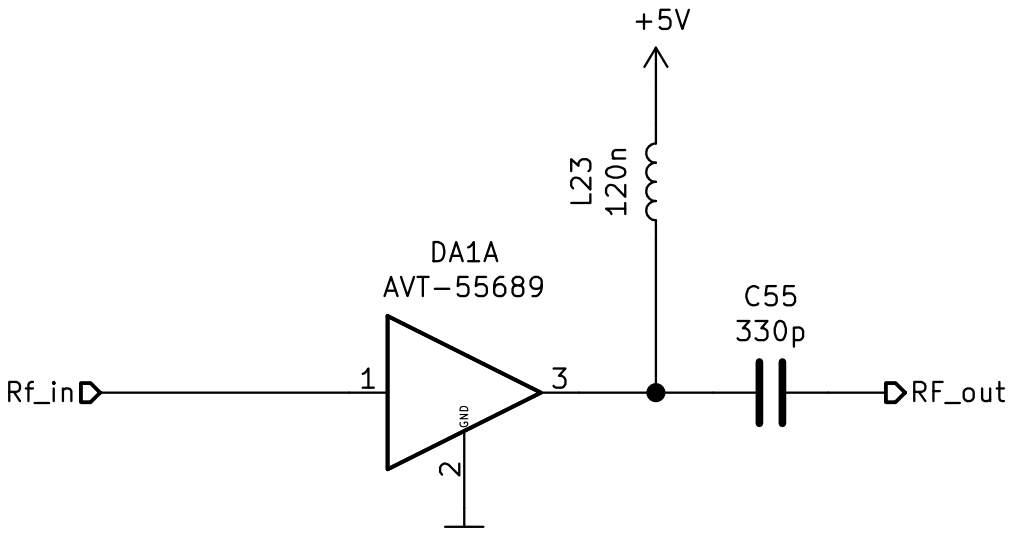
[picture p64: page 7]

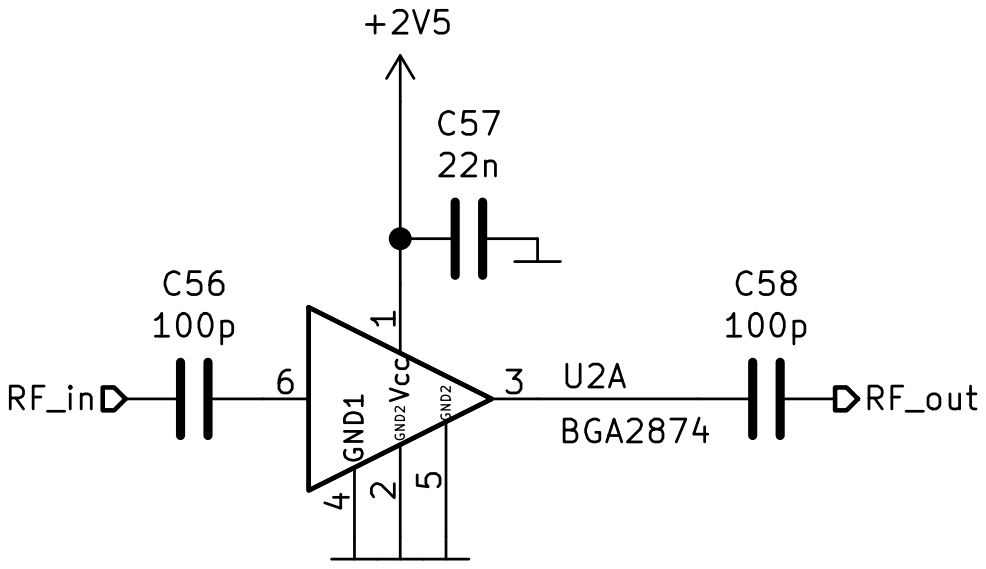
[picture p65: page 8]

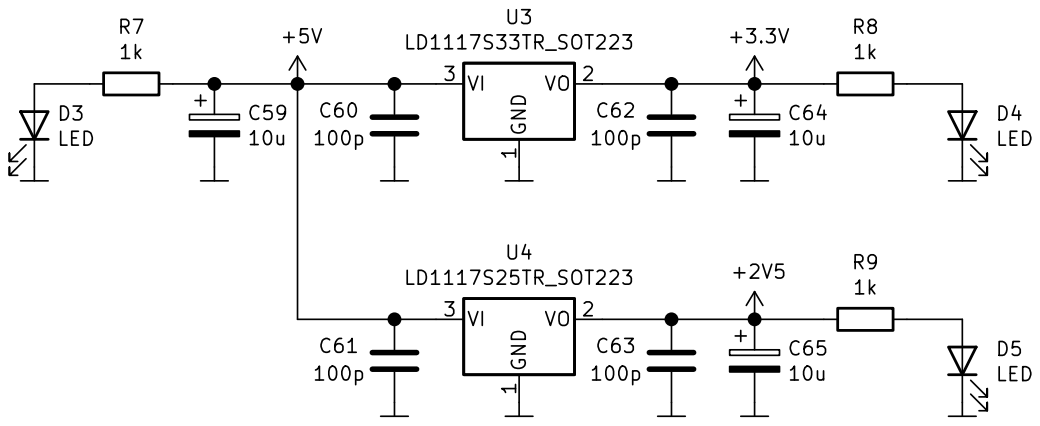
[picture p66: page 9]

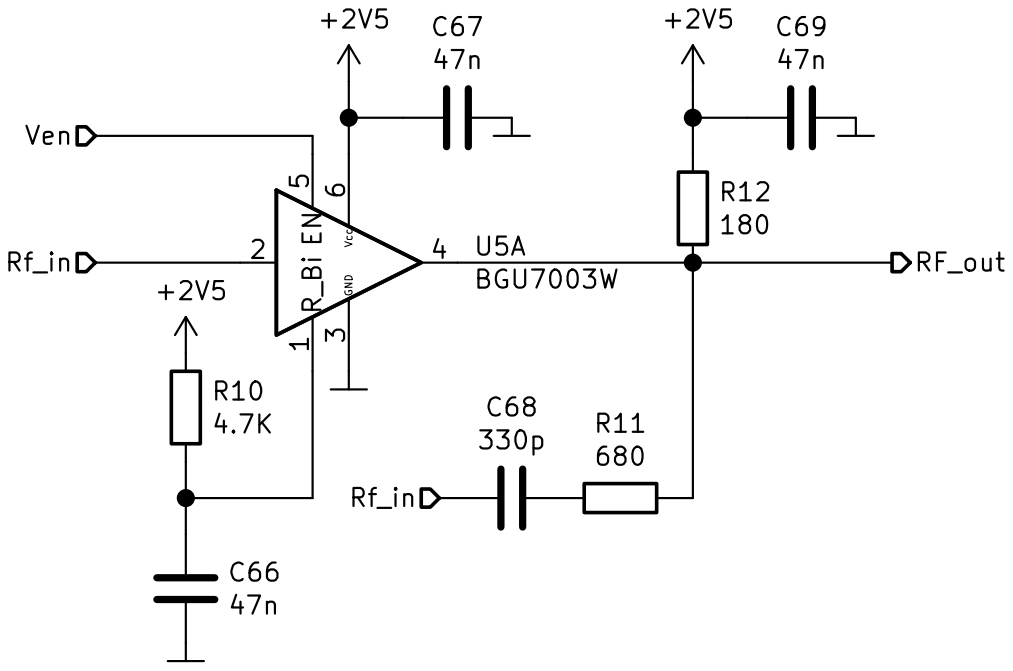
[picture p67: page 10]

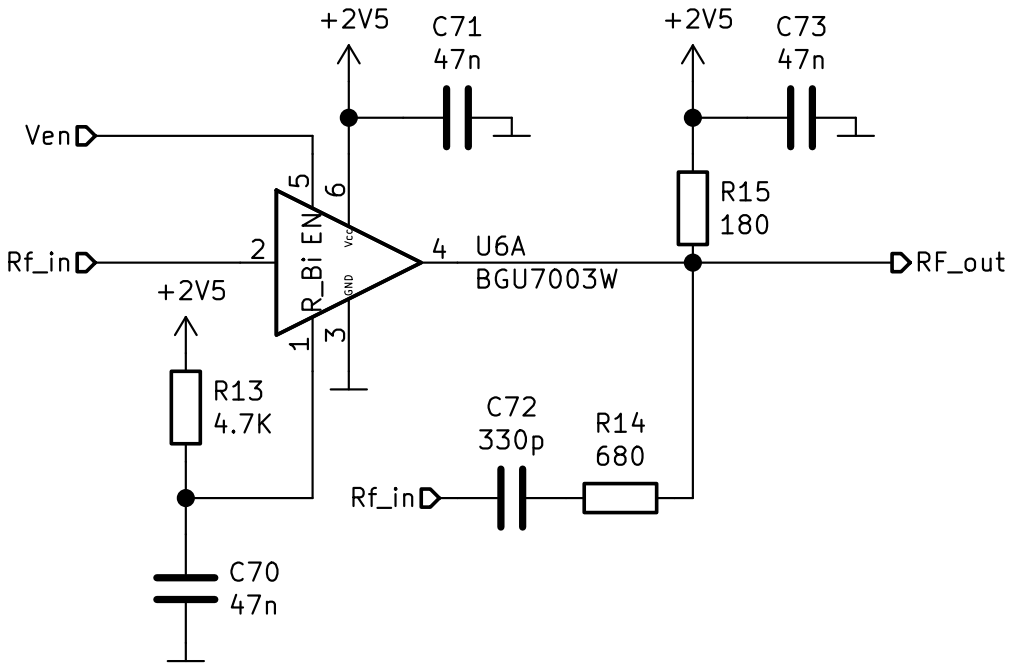
[picture p68: page 11]

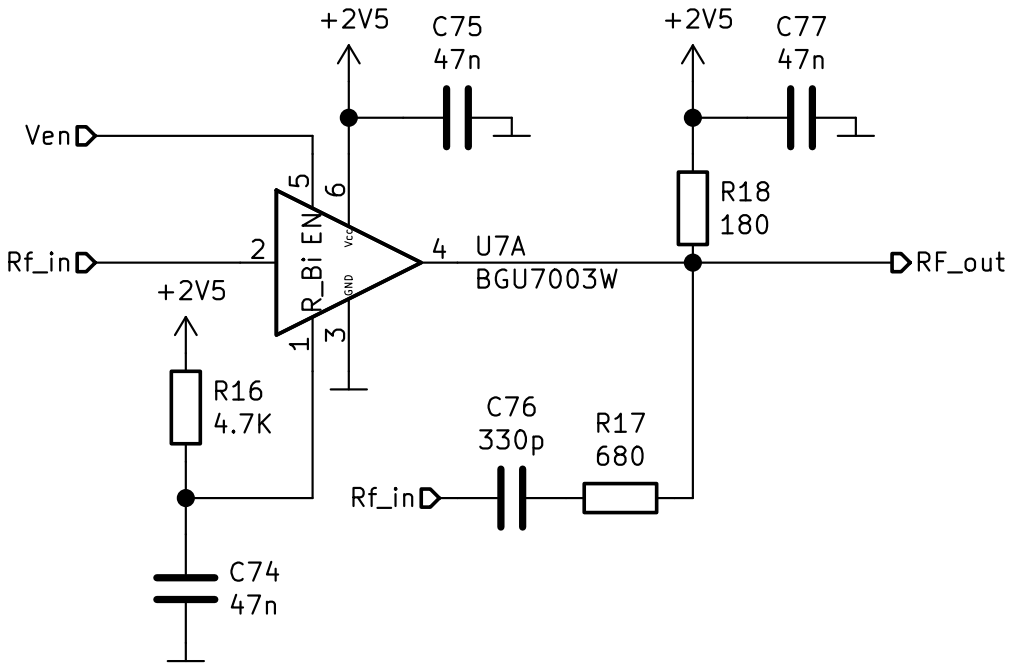
[picture p69: page 12]

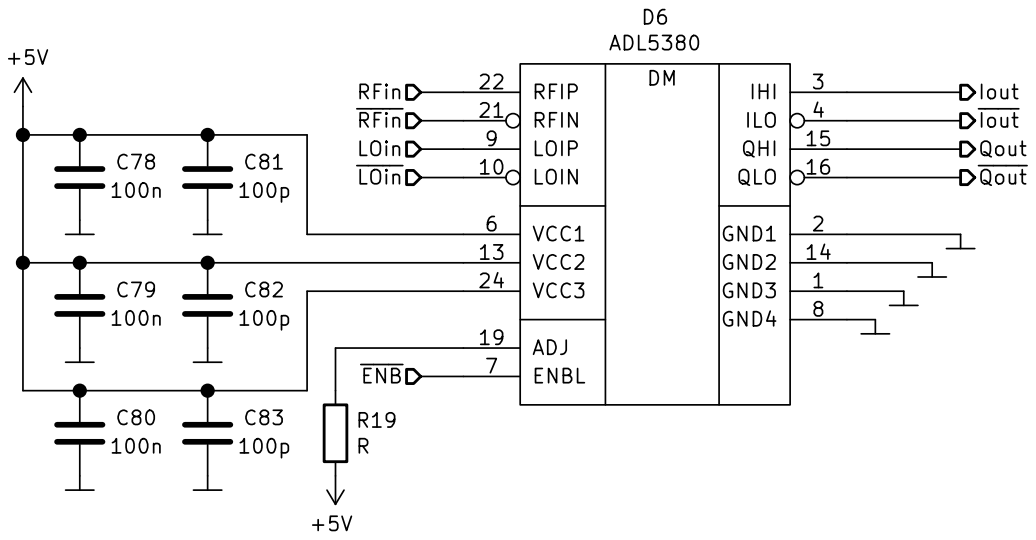
[picture p70: page 13]

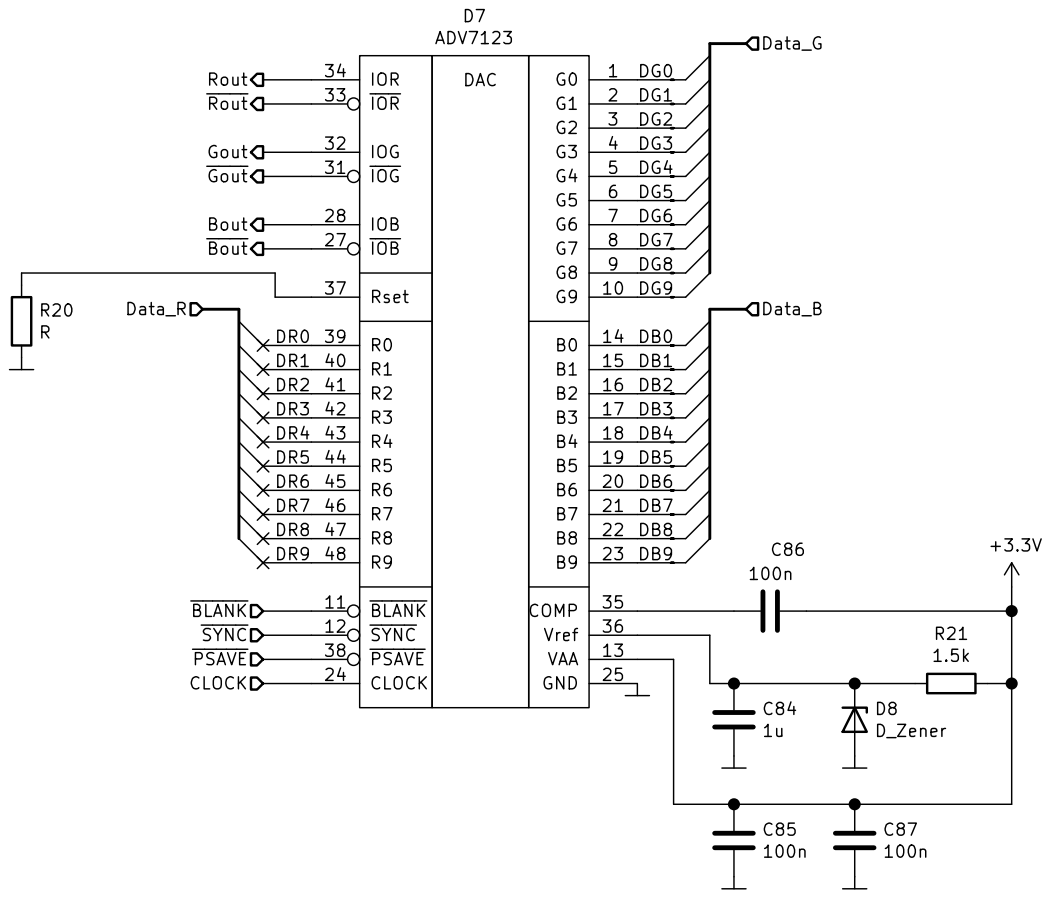
[picture p71: page 14]

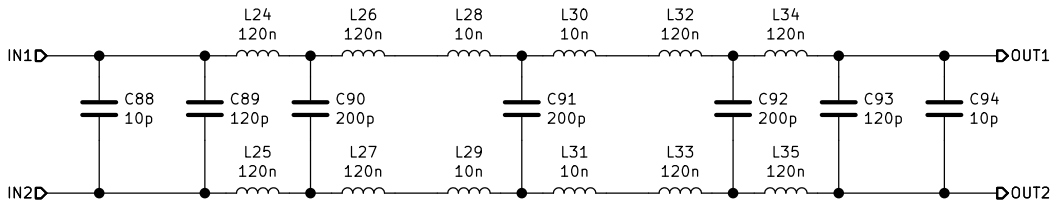
[picture p72: page 15]

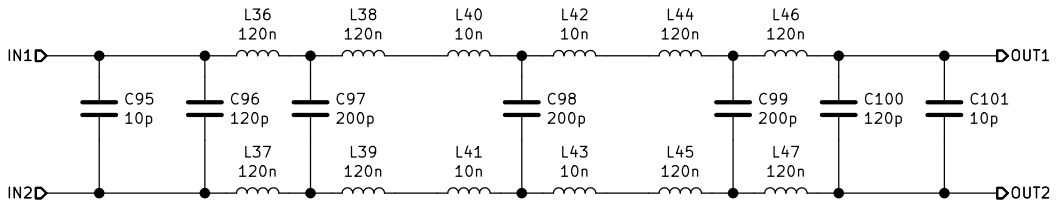
[picture p73: page 16]

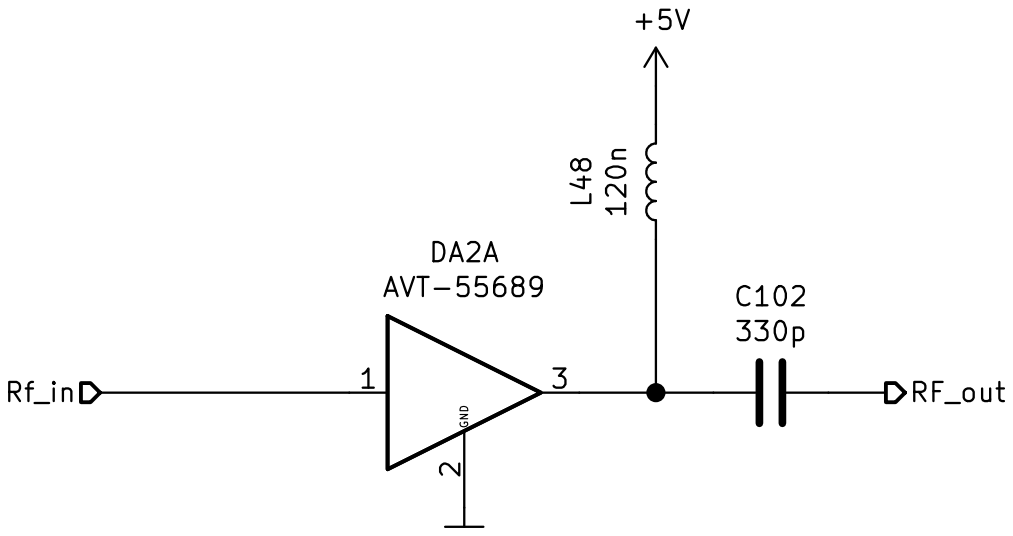
[picture p74: page 17]

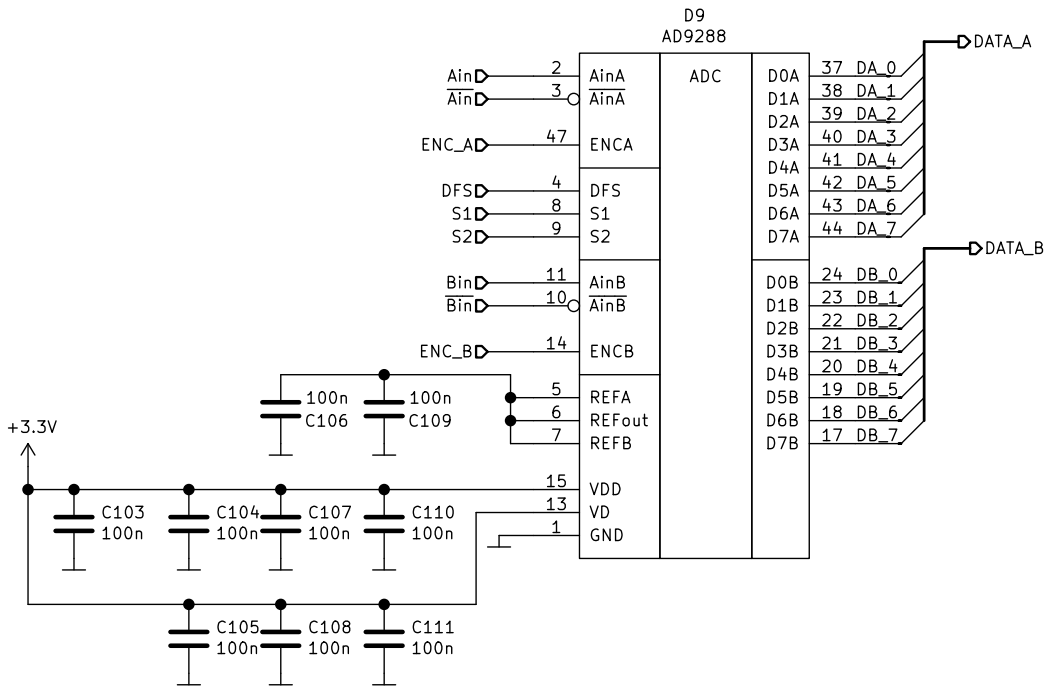
[picture p75: page 18]
