BYakov/Rx-Tx_module/Отчет Боннет/SDR-PCB.pdf

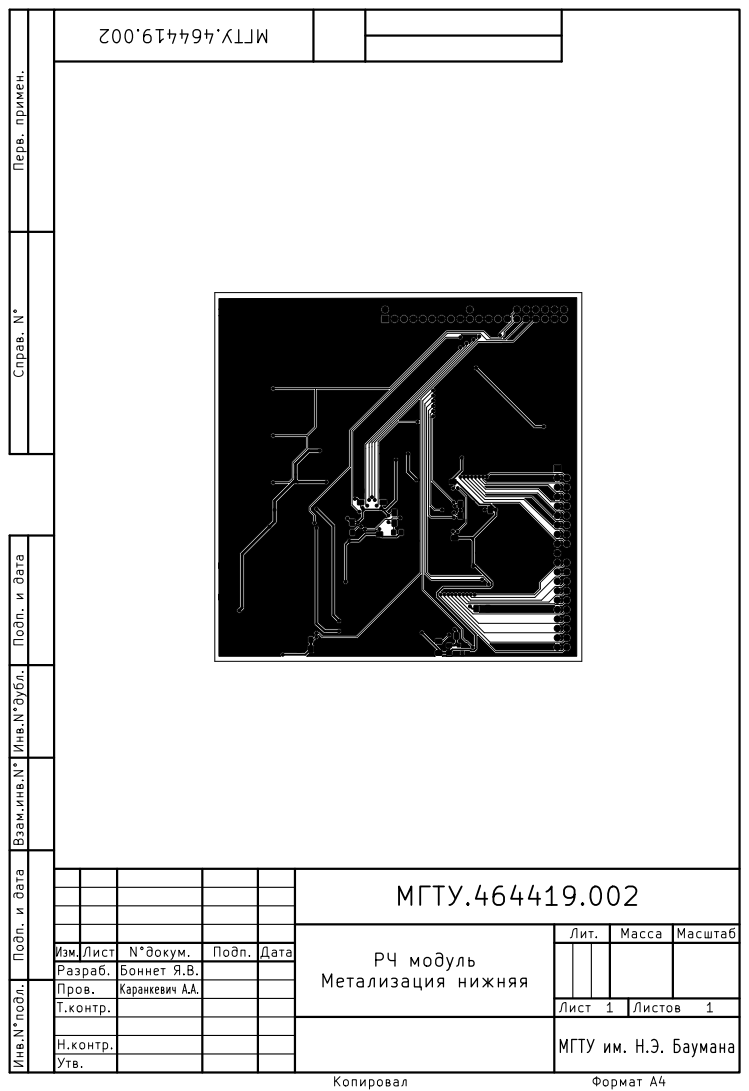
[picture p76: page 1]

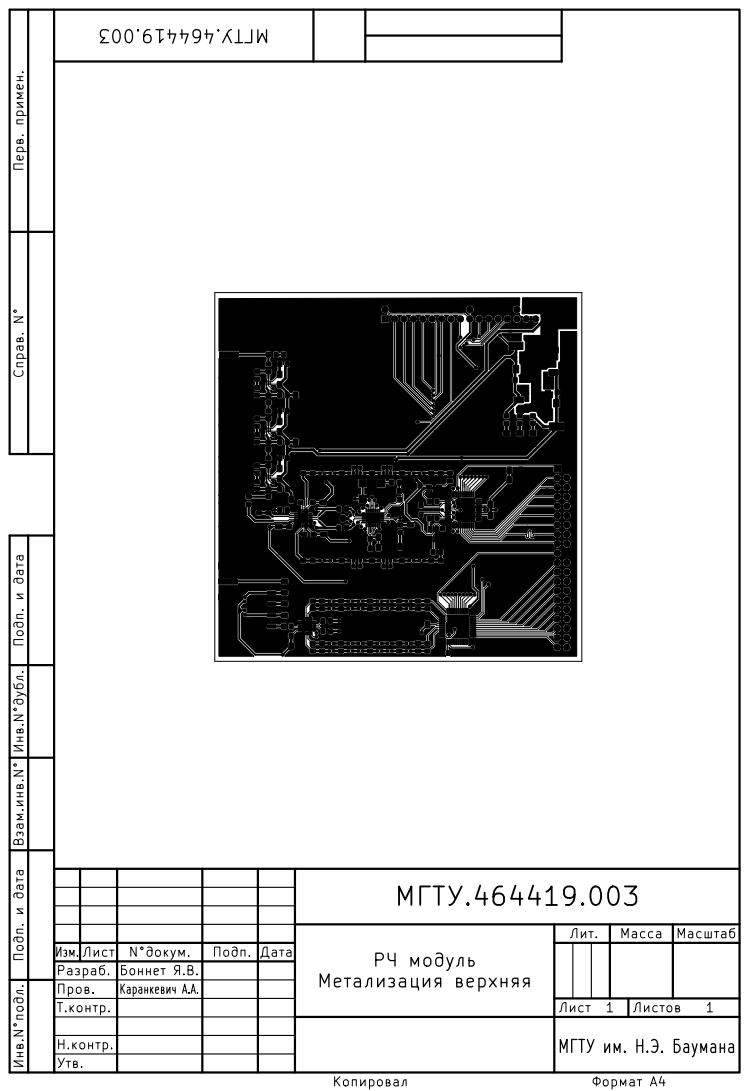
[picture p77: page 2]

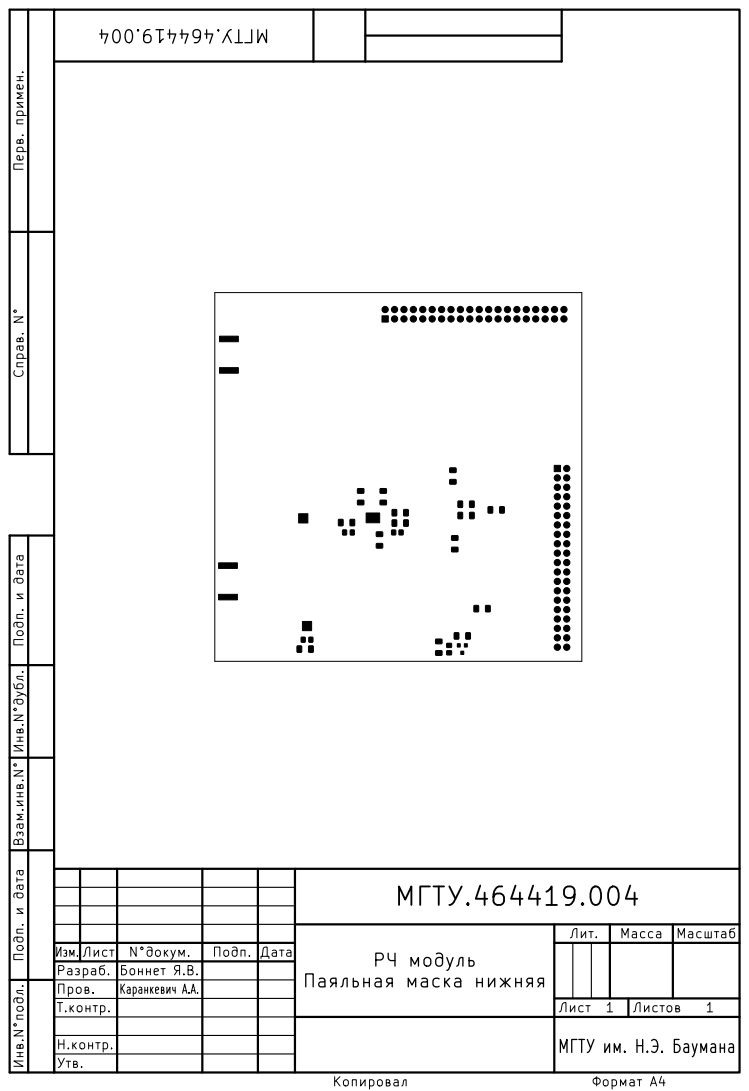
[picture p78: page 3]

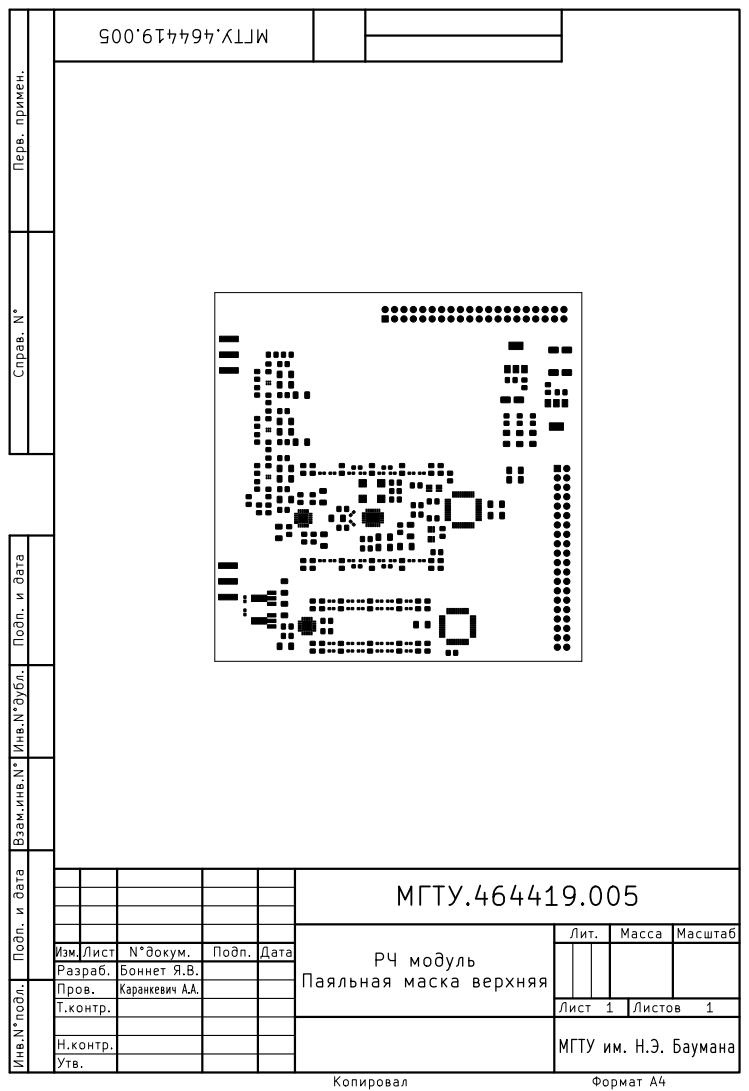
[picture p79: page 4]

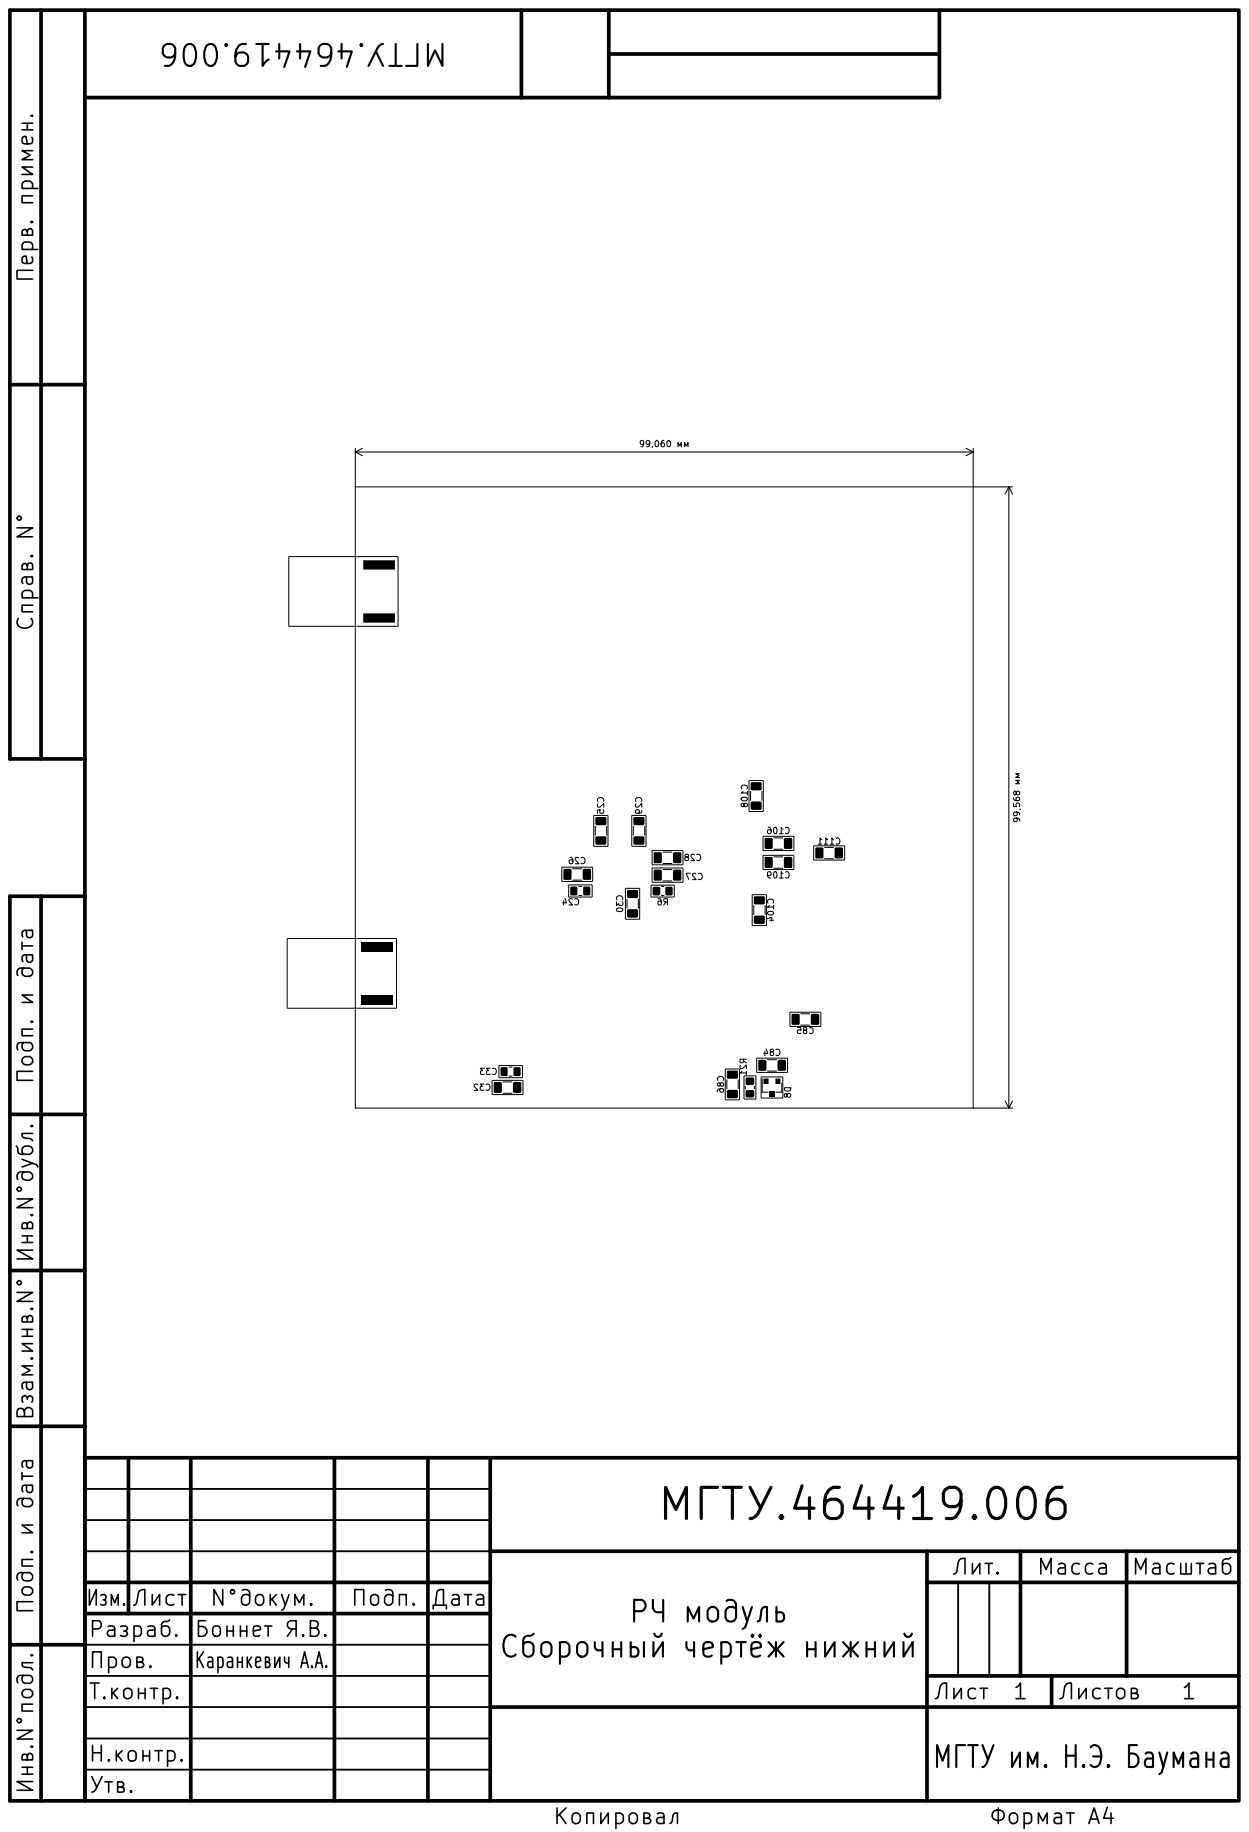
[picture p80: page 5]

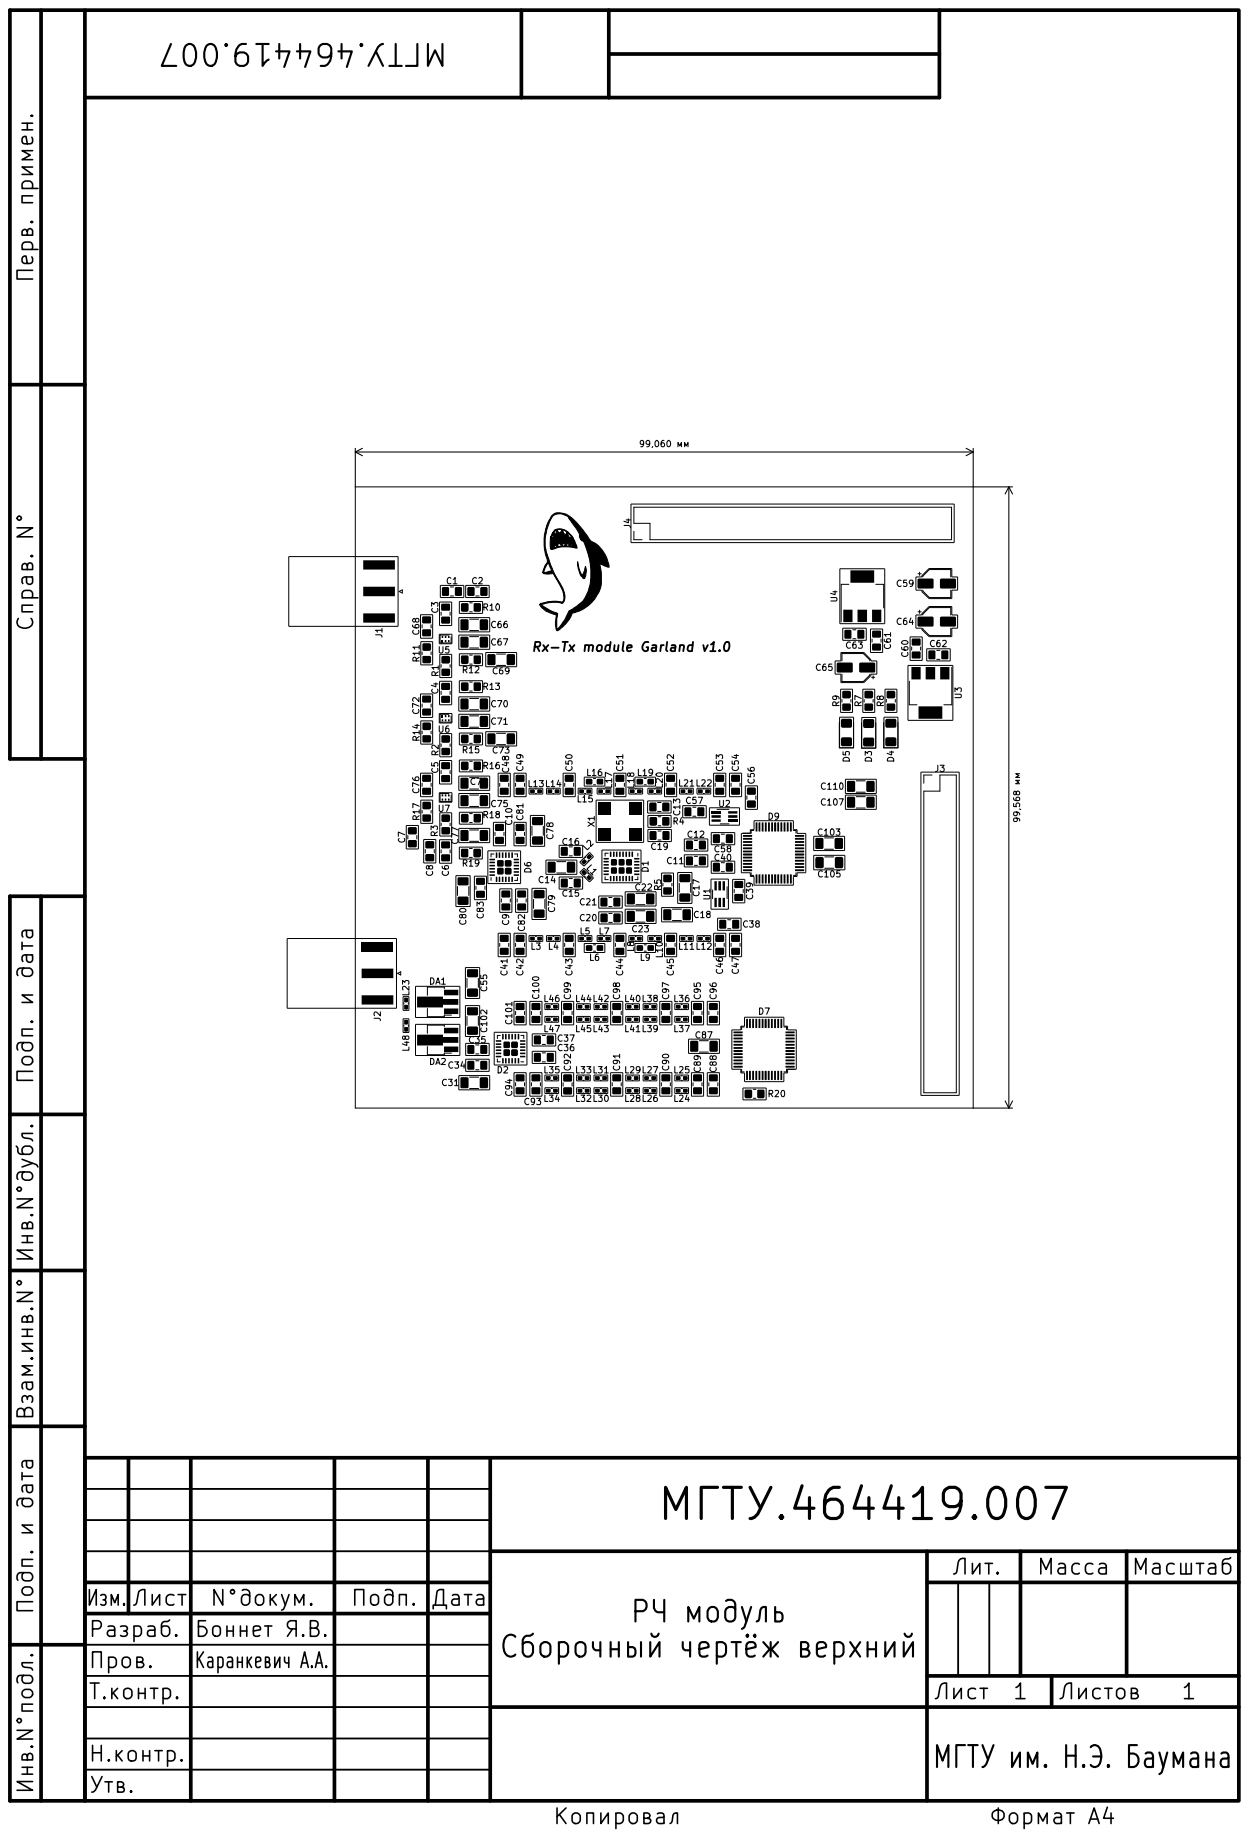
[picture p81: page 6]
