BYakov/Rx-Tx_module/Отчет Боннет/SDR-Sch-title.pdf

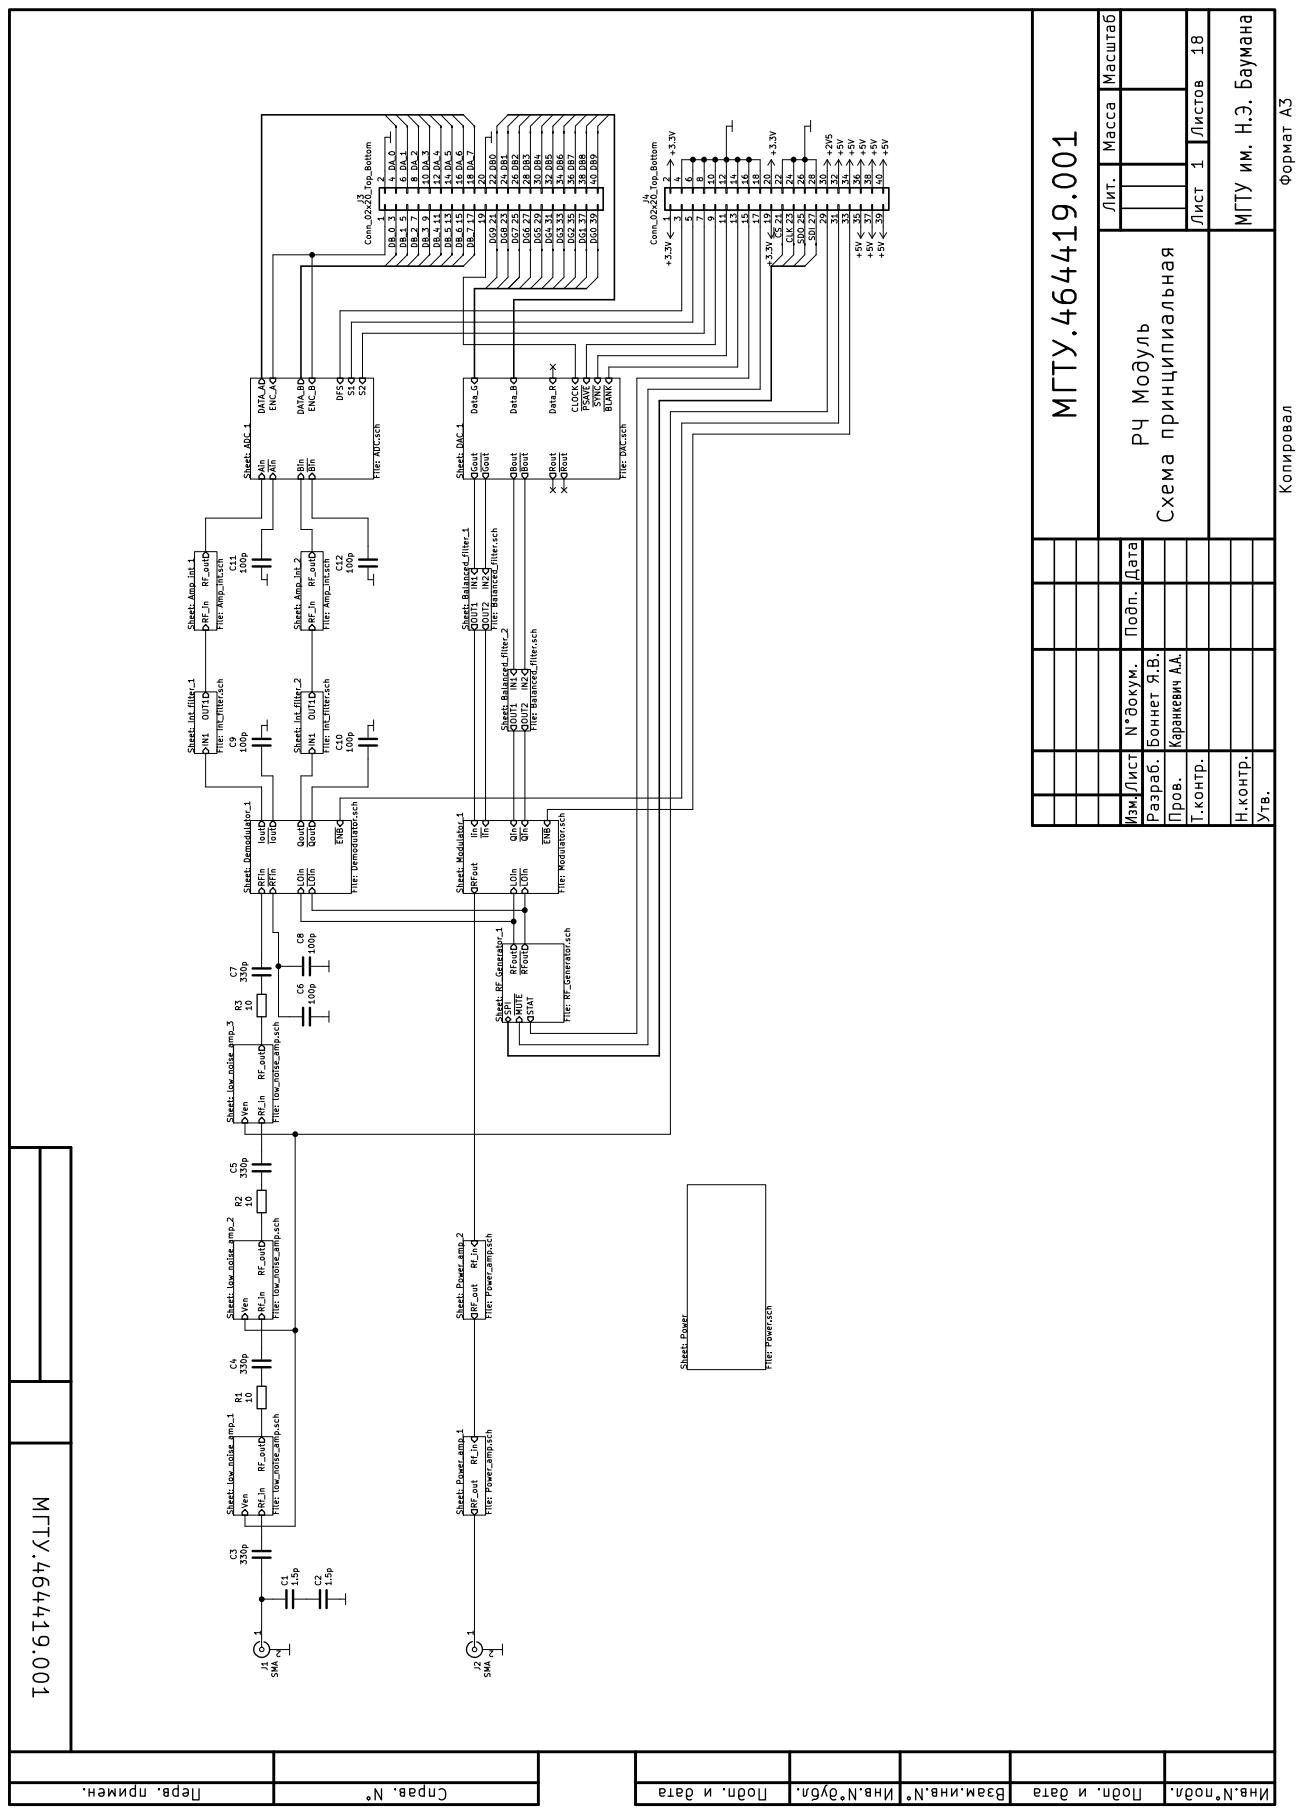
[picture p82: page 1]
