BYakov/Rx-Tx_module/Отчет Боннет/Структурная схема модуля.pdf

## РЧ Приемо-передающая ячейка № 1

14

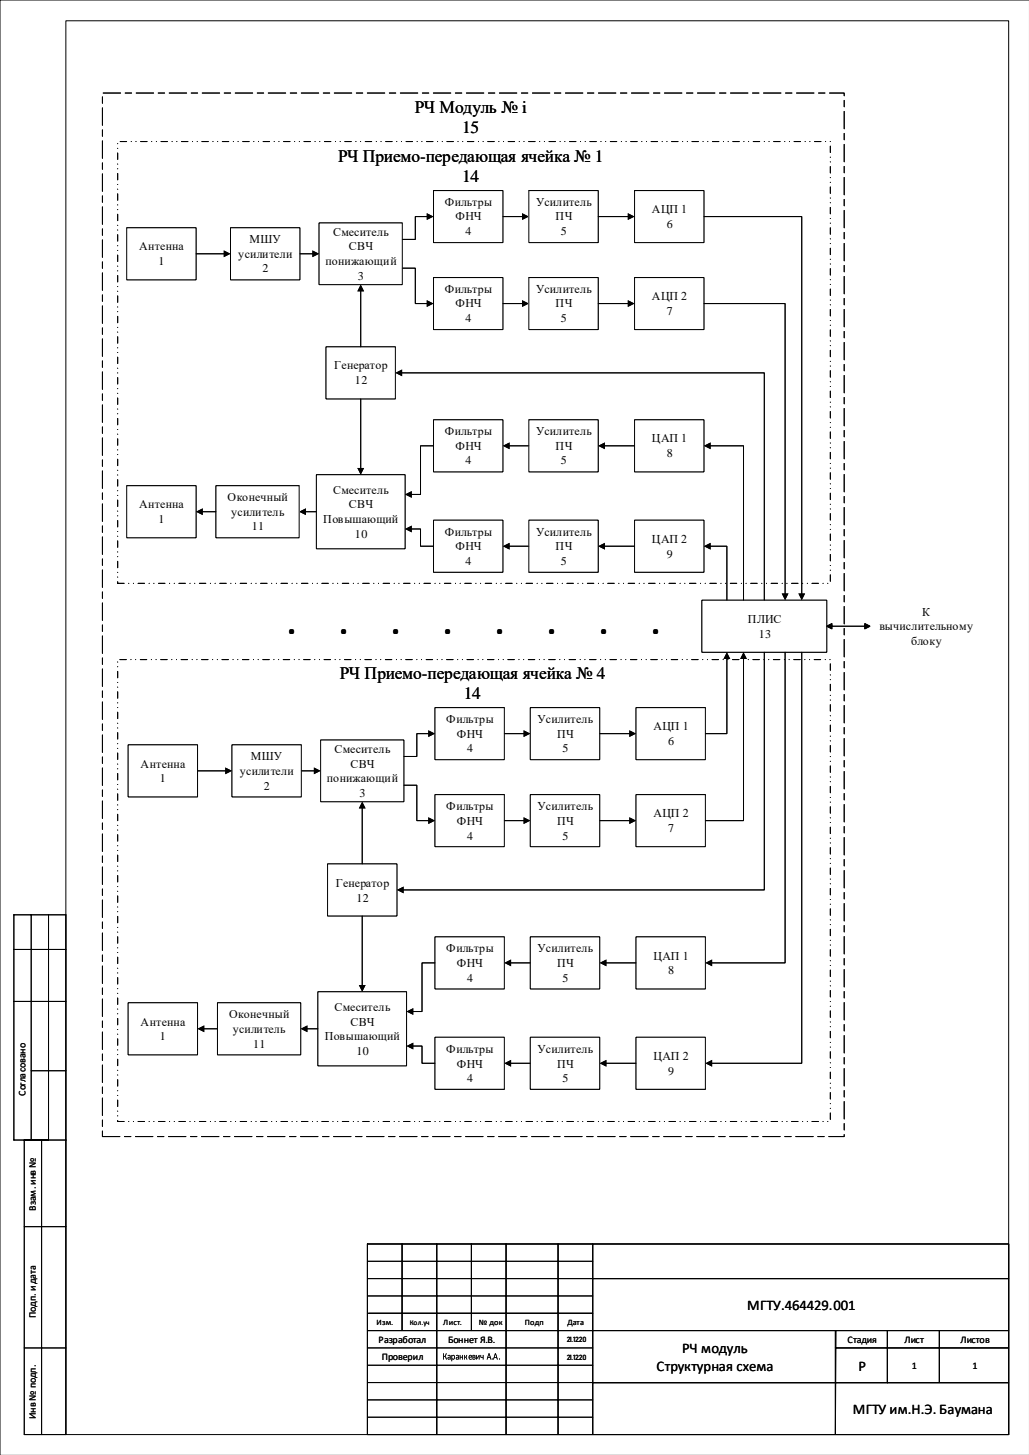
[picture p100: page 1]
Антенна 1; Смеситель СВЧ понижающий 3; Генератор 12; АЦП 1 6; АЦП 2 7; Смеситель СВЧ Повышающий 10; ЦАП 1 8; ЦАП 2 9; ПЛИС; МШУ усилители 2; Оконечный усилитель 11; Фильтры ФНЧ 4; Усилитель ПЧ 5; К вычислительному блоку; РЧ Модуль № i 15; Согласовано; Наименование листа

РЧ Приемо-передающая ячейка № 1

РЧ Приемо-передающая ячейка № 4

Инв № подп. Подп. и дата Взам. инв

Наименование документа

МГТУ.464429.001

Изм. | Кол.уч | Лист. | № док | Подп | Дата
Разработал | Боннет Я.В. | | 21.12.20 | РЧ модуль РЧ модуль Структурная схема Структурная схема | Стадия | Лист | Листов
Проверил | | | 21.12.20 | | Р Р | 1 1 | 1 1

МГТУ им.Н.Э. Баумана
