BYakov/Rx-Tx_module/Отчет Боннет/Структурная схема ПЛИС.pdf

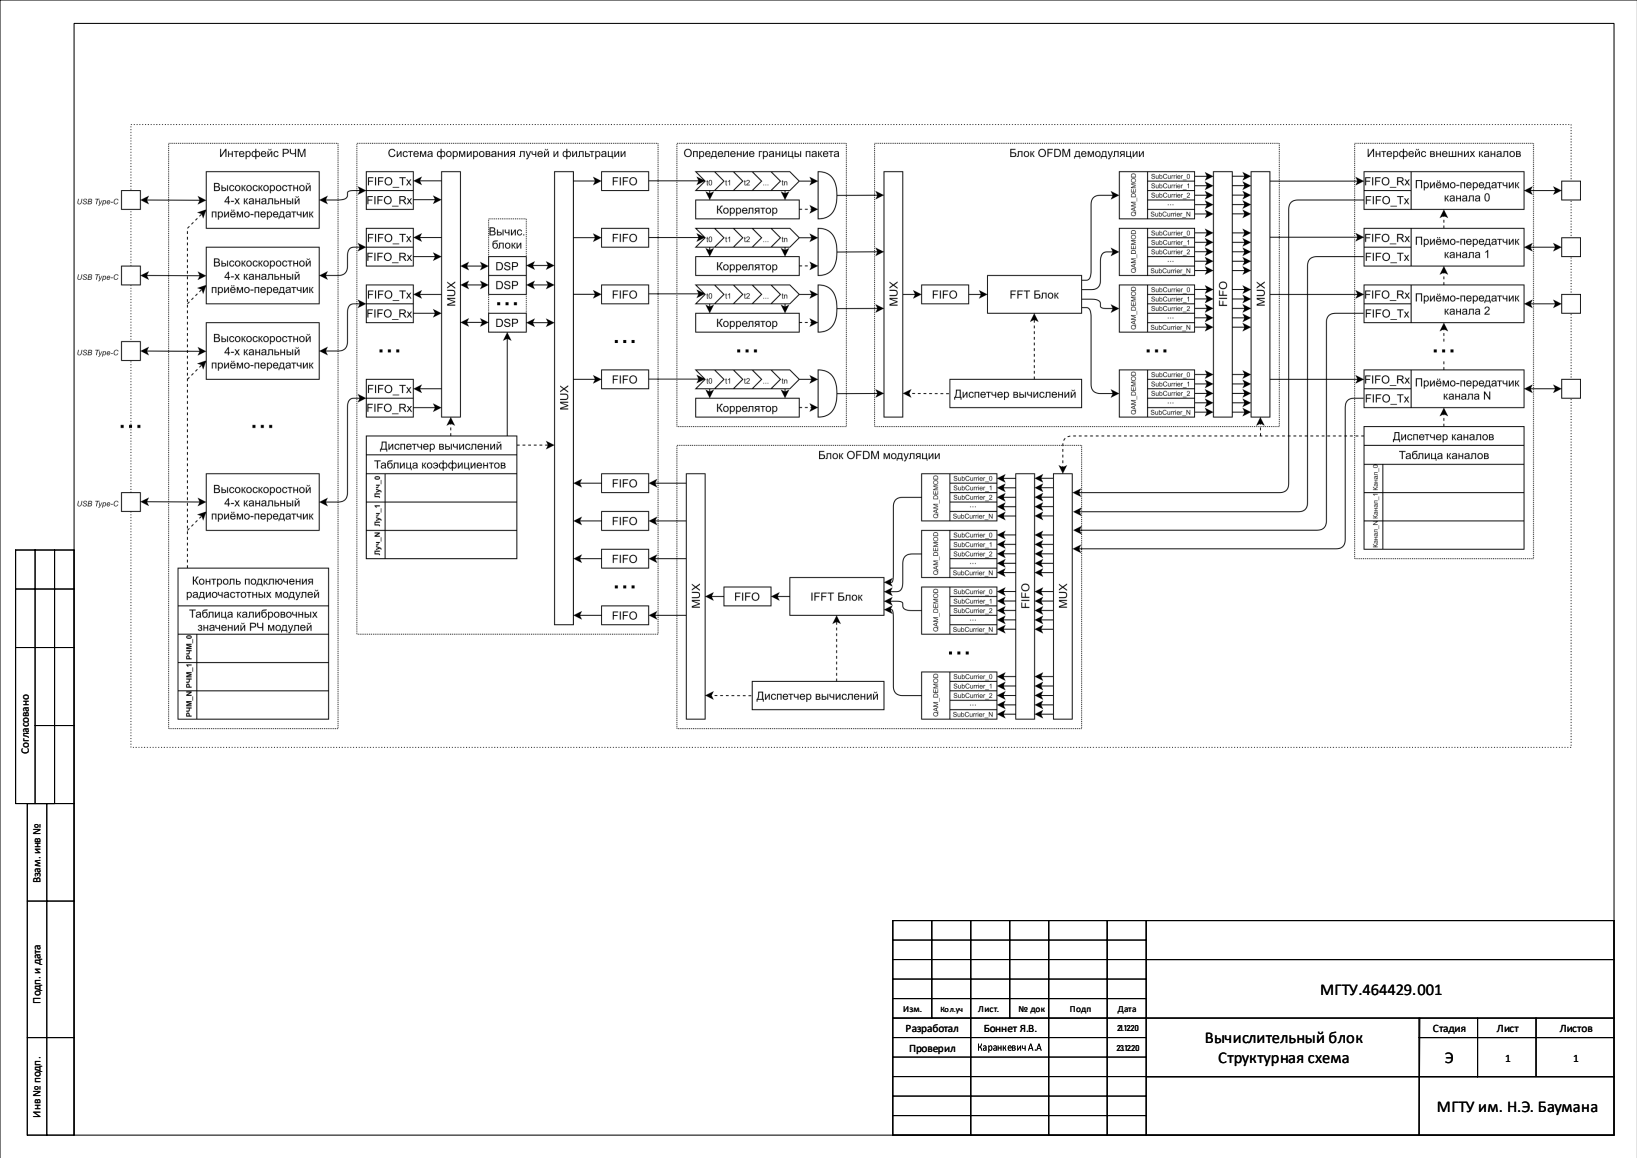
[picture p101: page 1]
Согласовано

Инв № подп. Подп. и дата Взам. инв №

МГТУ.464429.001

Изм. | Кол.уч | Лист. | № док | Подп | Дата
Разработал | Боннет Я.В. | | 21.12.20 | Вычислительный блок Вычислительный блок Структурная схема 0 Структурная схема 0 | Стадия | Лист | Листов
Проверил | | | 23.12.20 | | Э Э | 1 1 | 1 1

МГТУ им. Н.Э. Баумана
