BYakov/Rx-Tx_module/Отчет/SDR-Sch-title.pdf

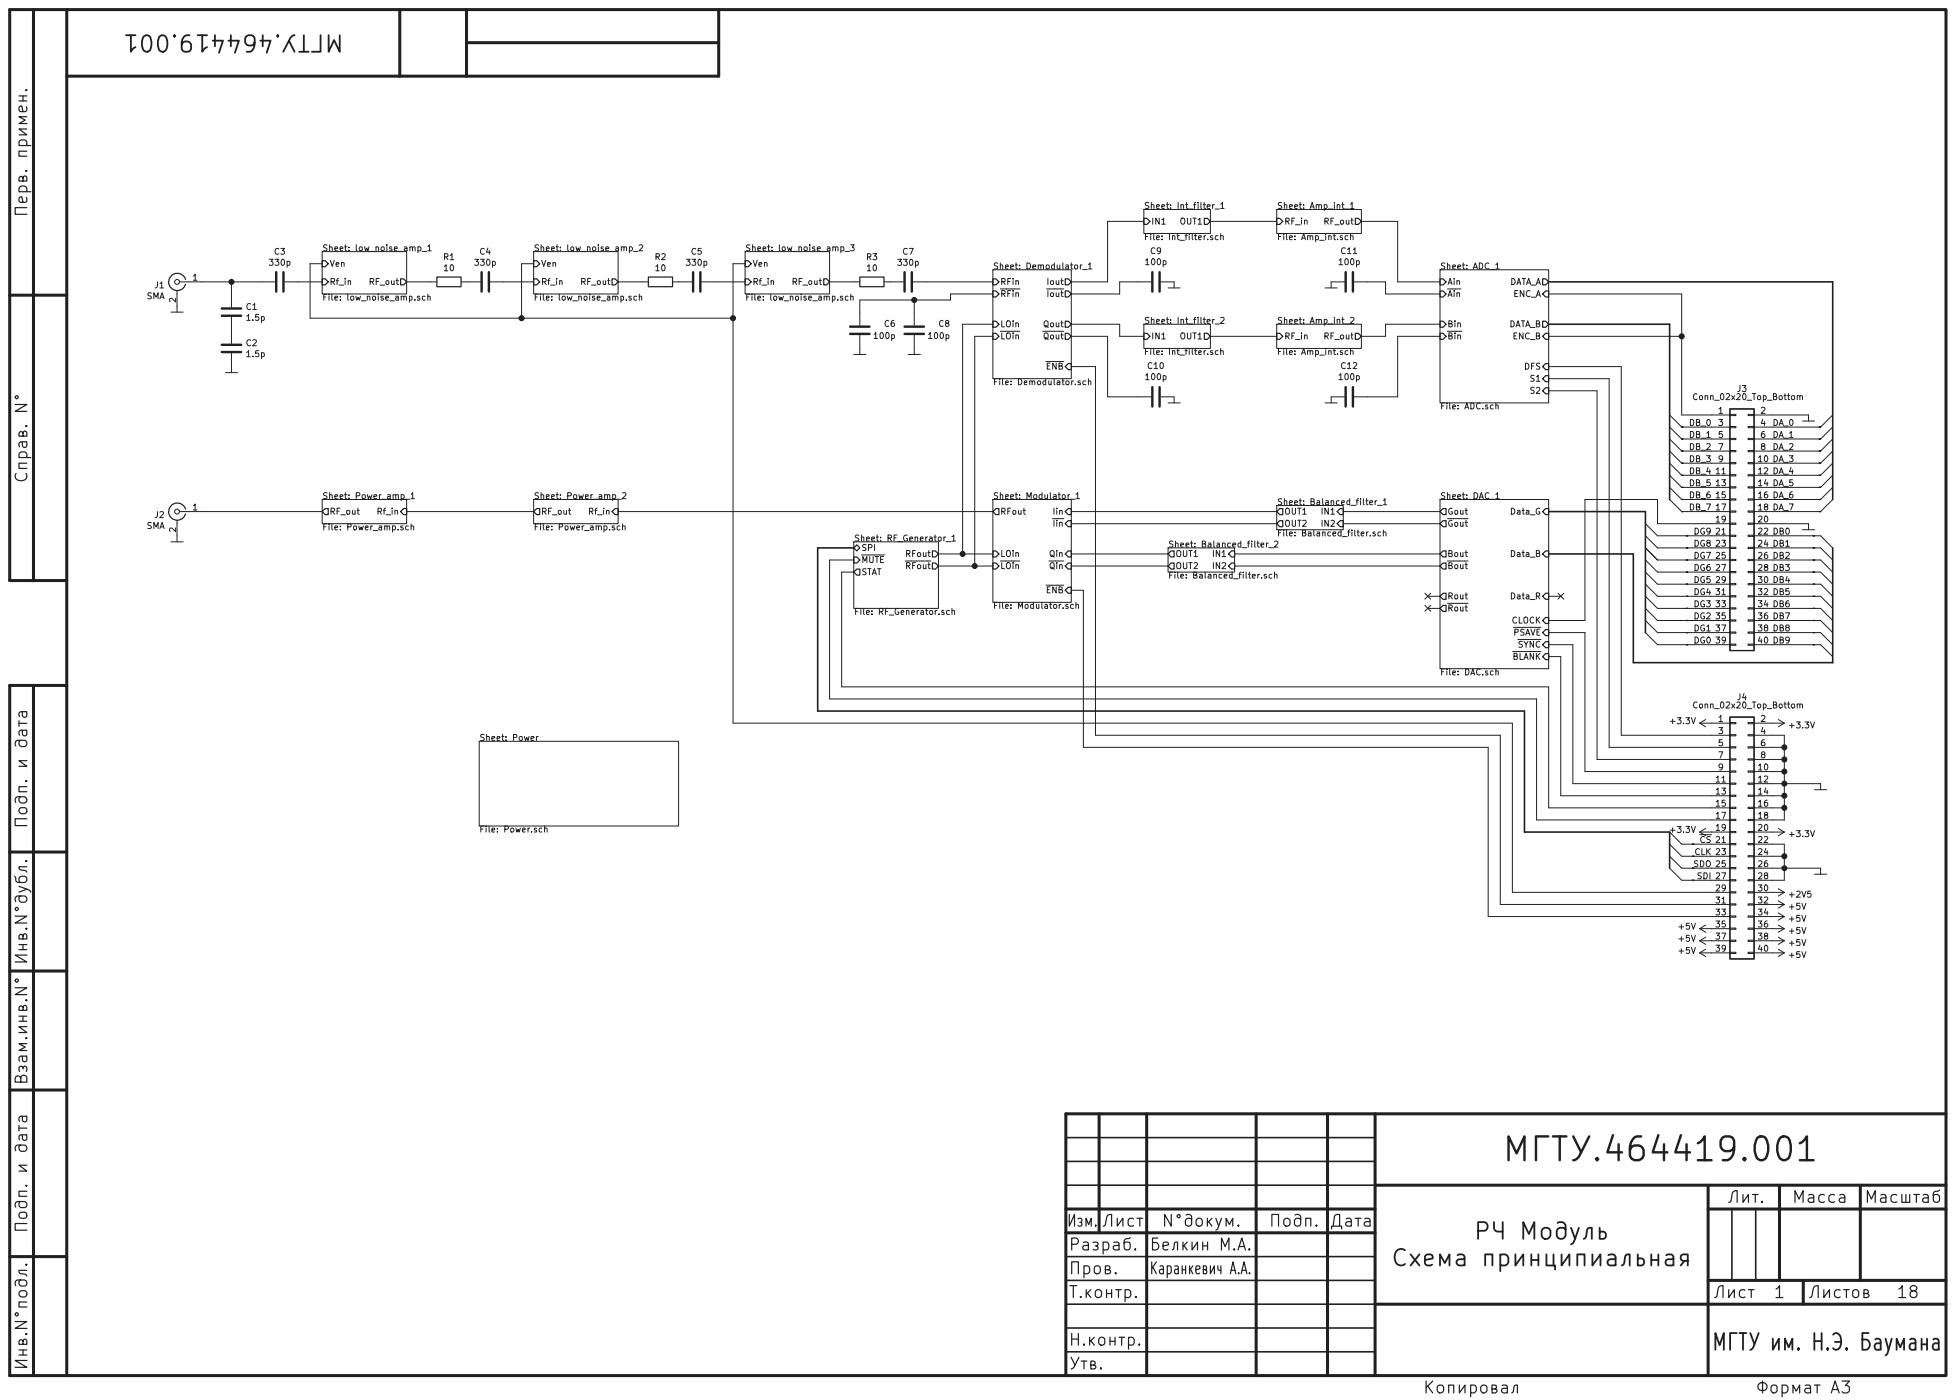
[picture p108: page 1]
