BYakov/Rx-Tx_module/Отчет/SDR-Sch.pdf

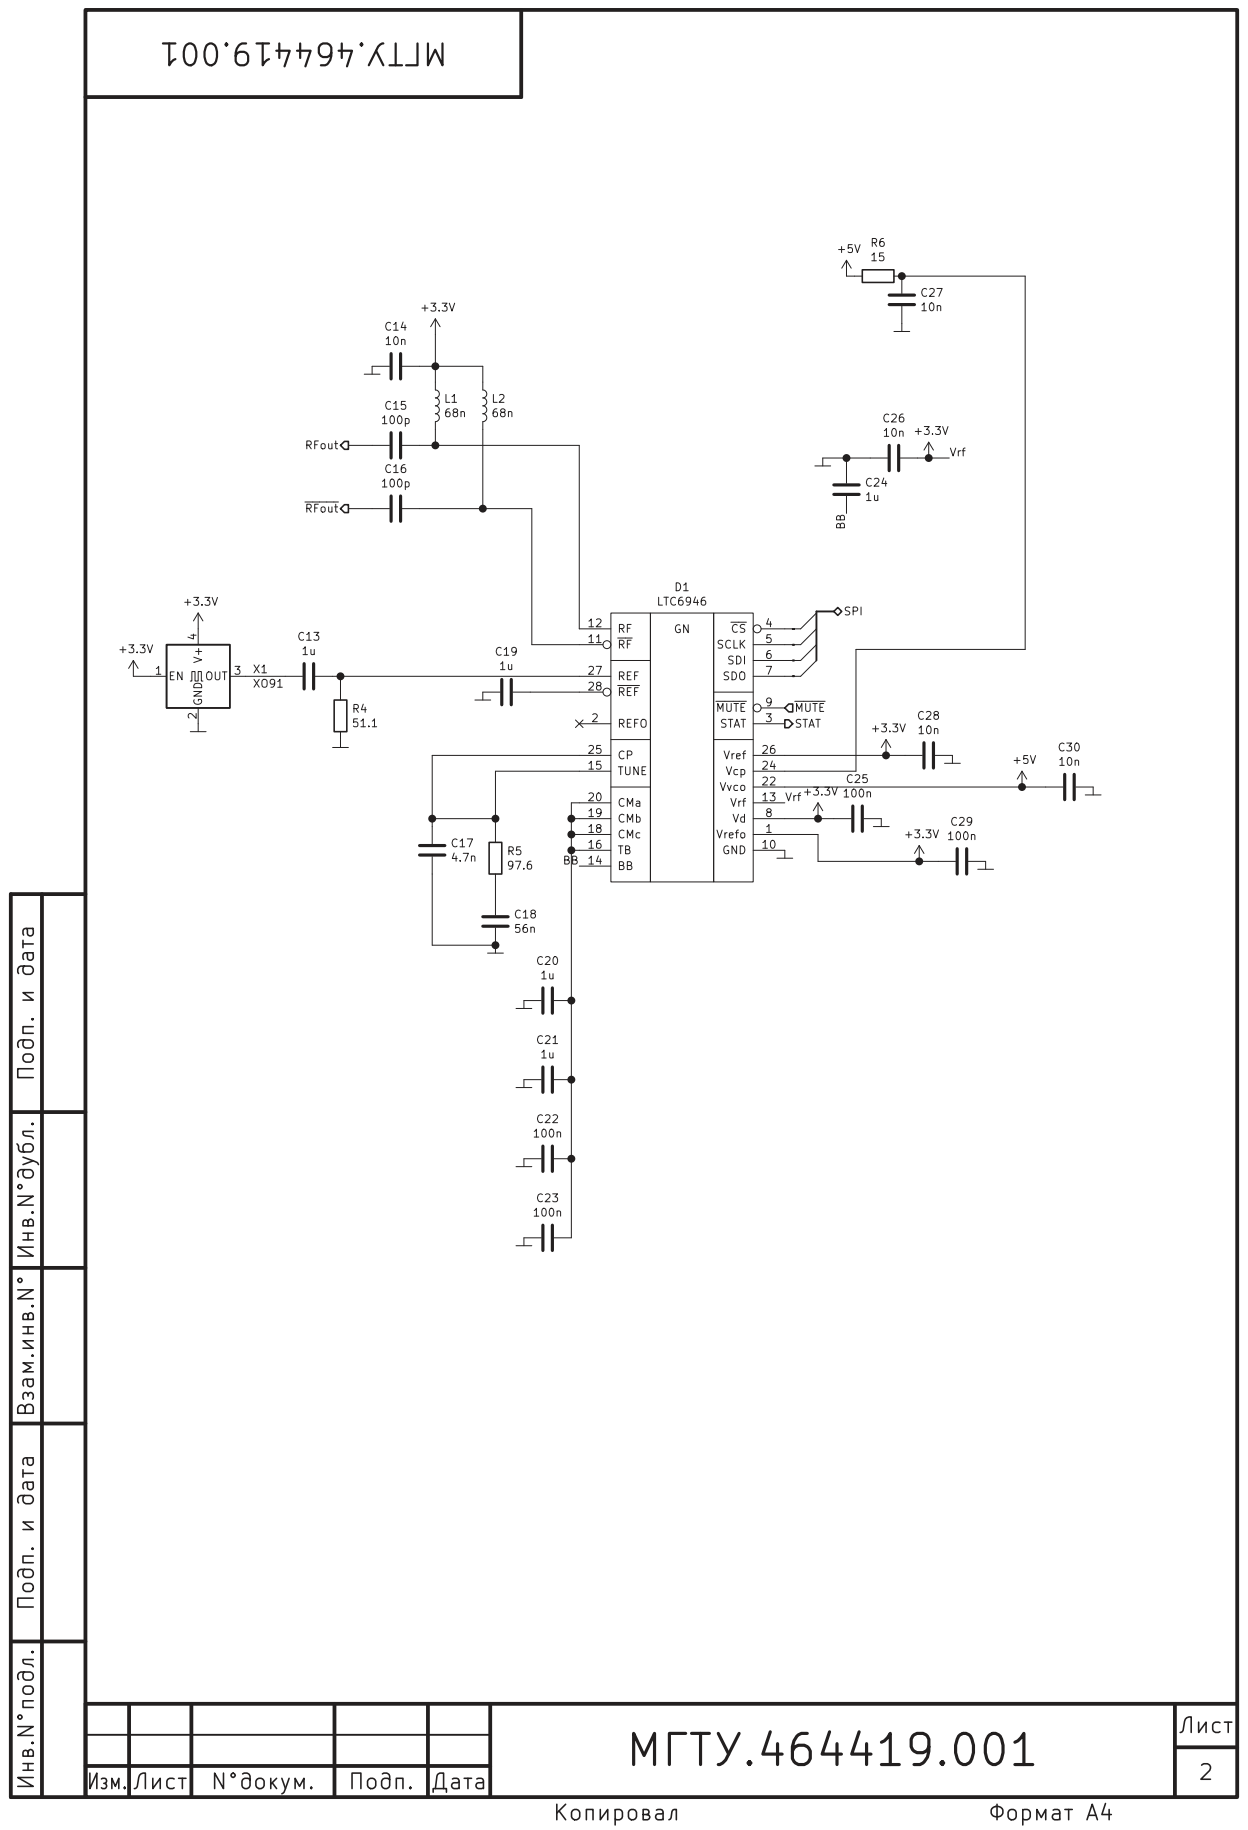
[picture p109: page 1]

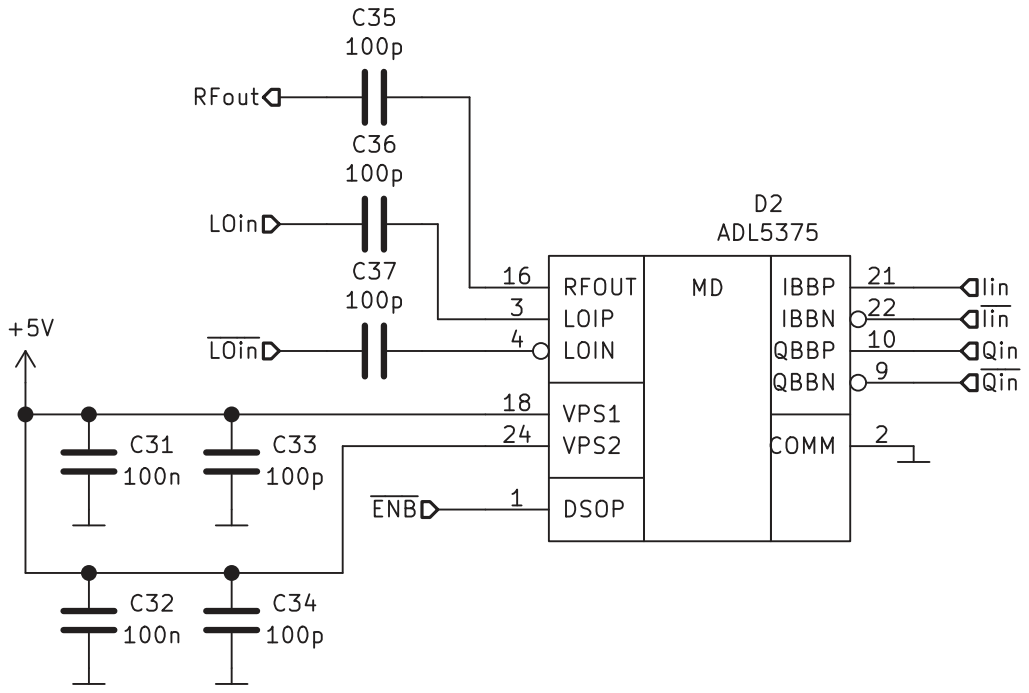
[picture p110: page 2]

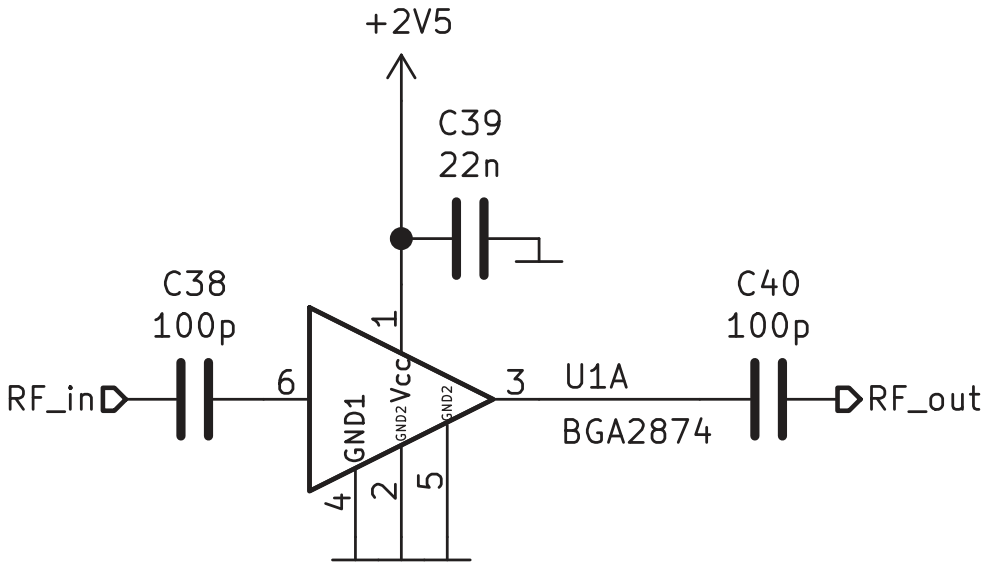
[picture p111: page 3]

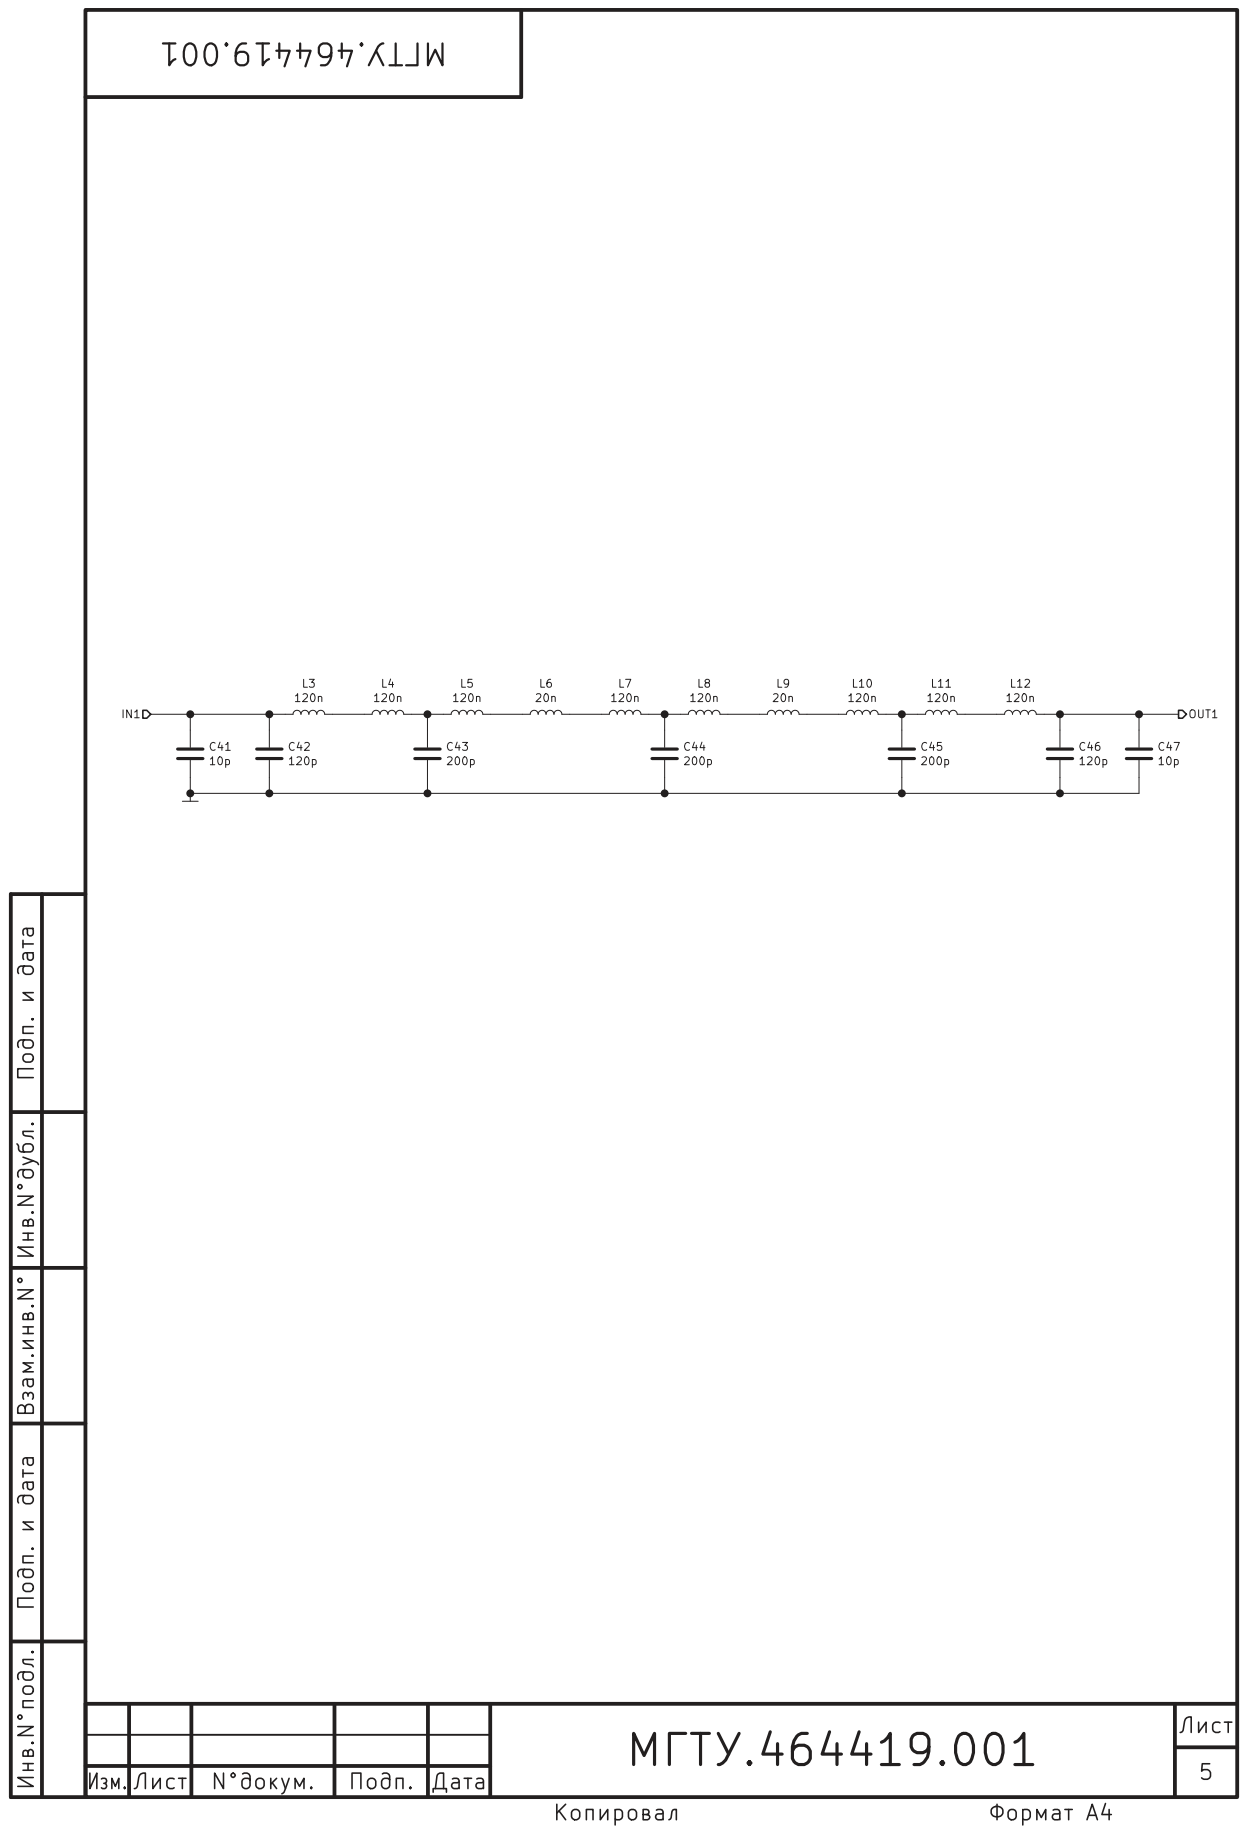
[picture p112: page 4]

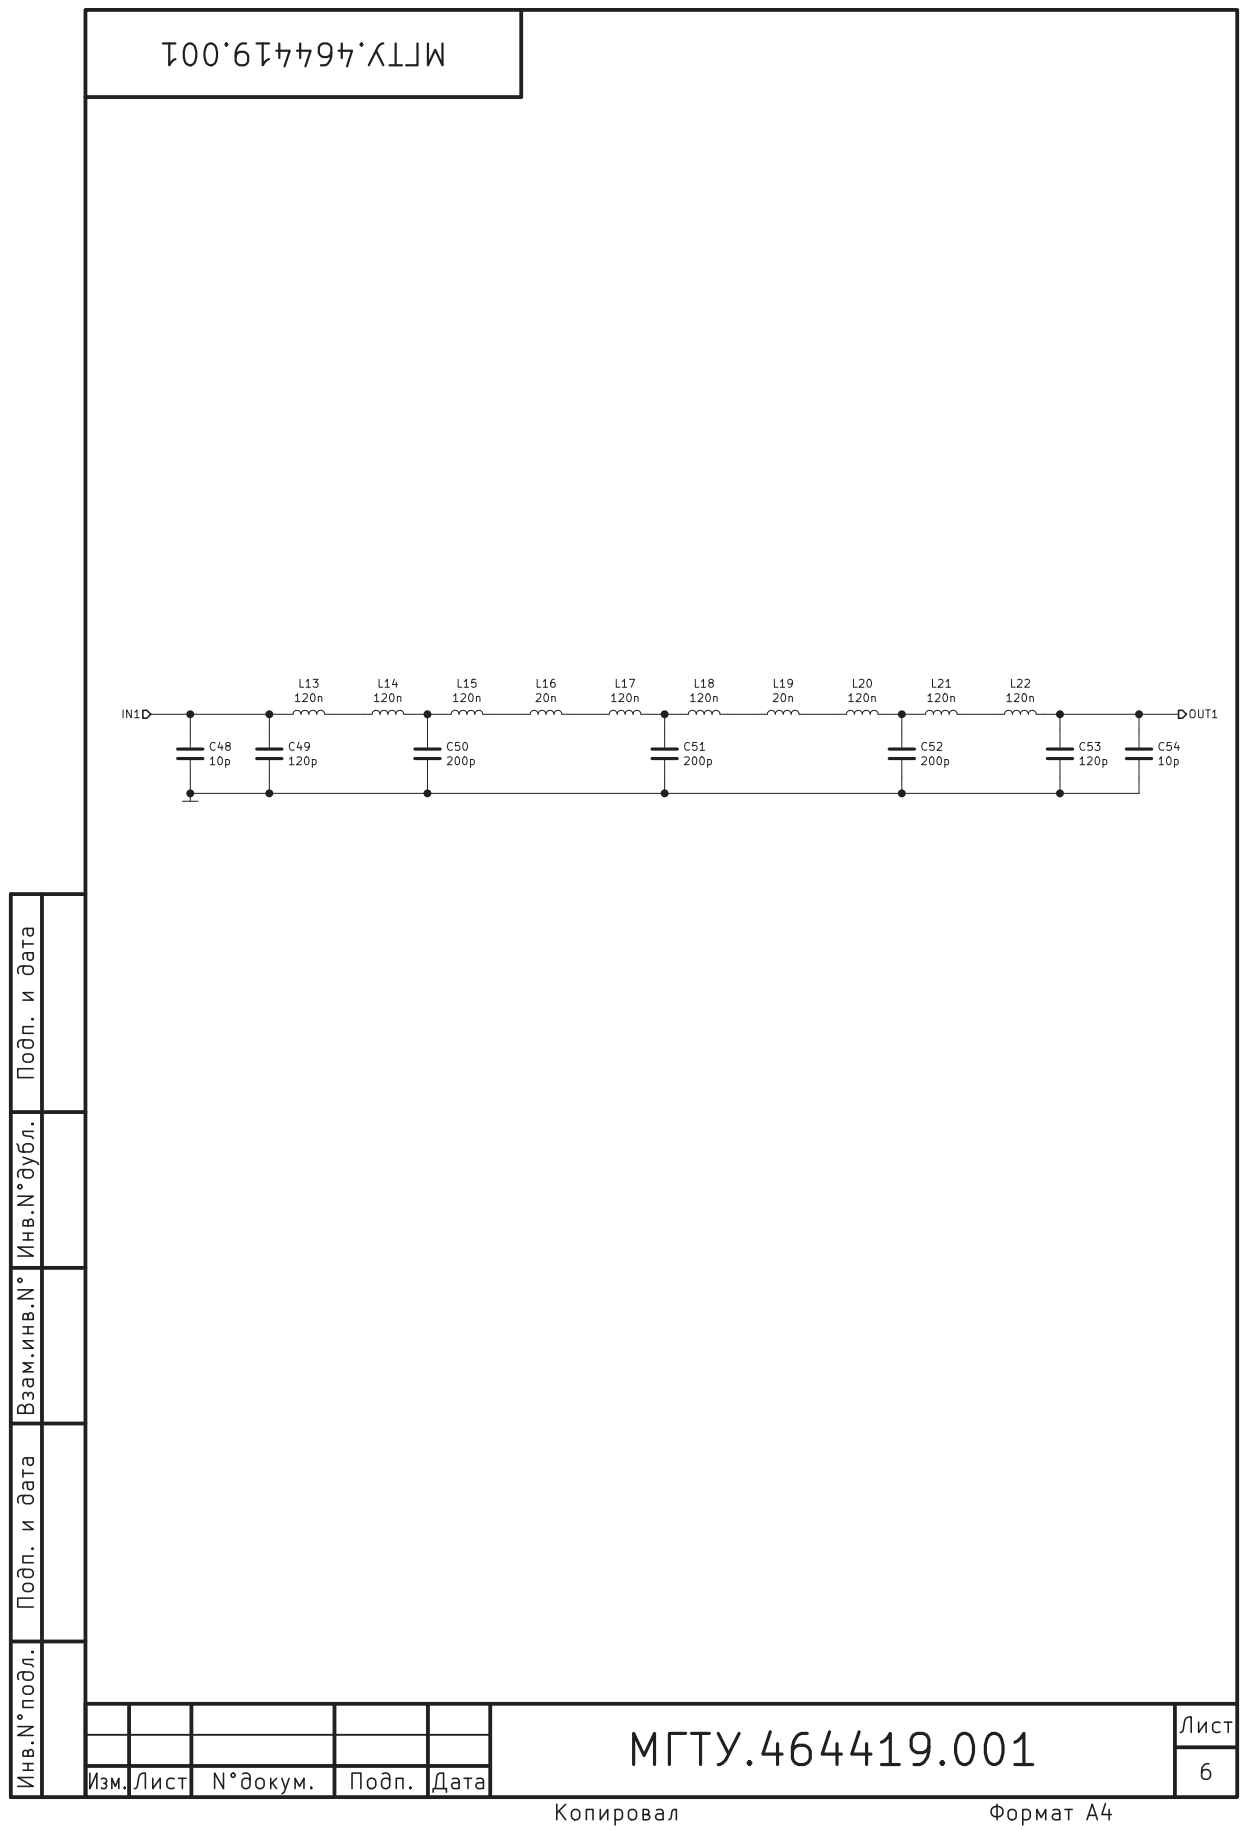
[picture p113: page 5]

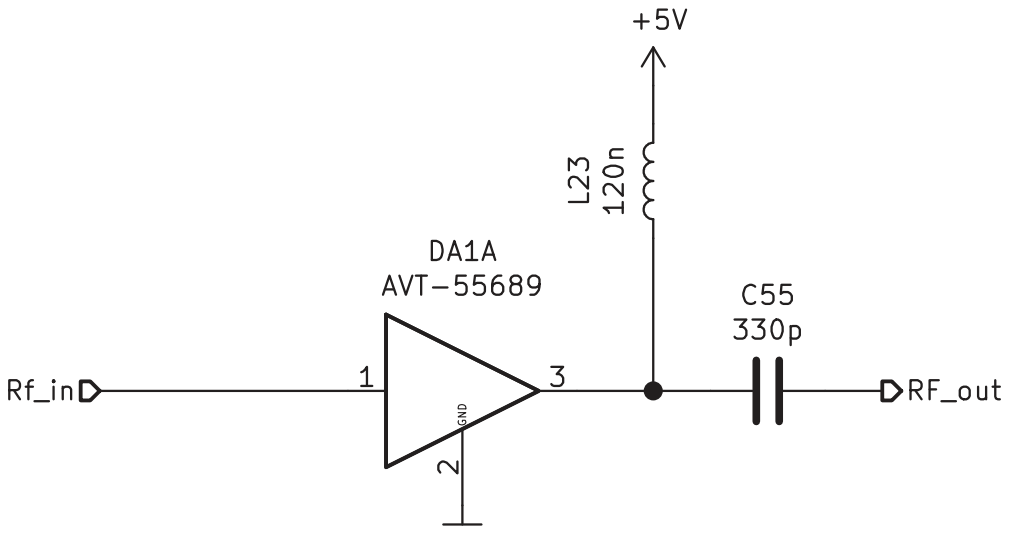
[picture p114: page 6]

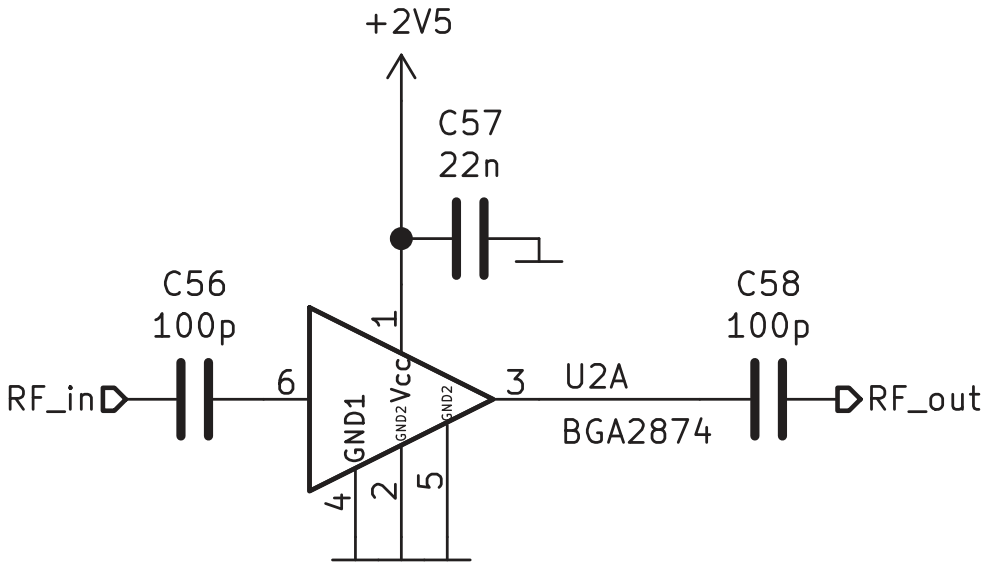
[picture p115: page 7]

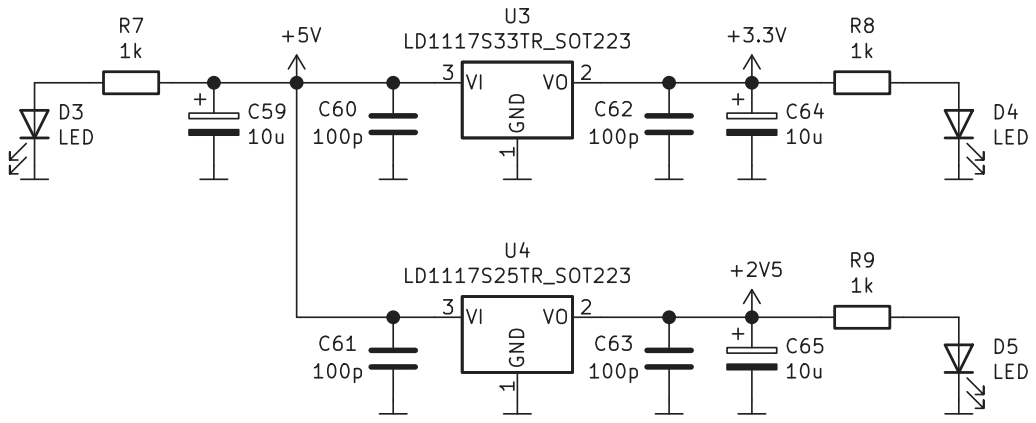
[picture p116: page 8]

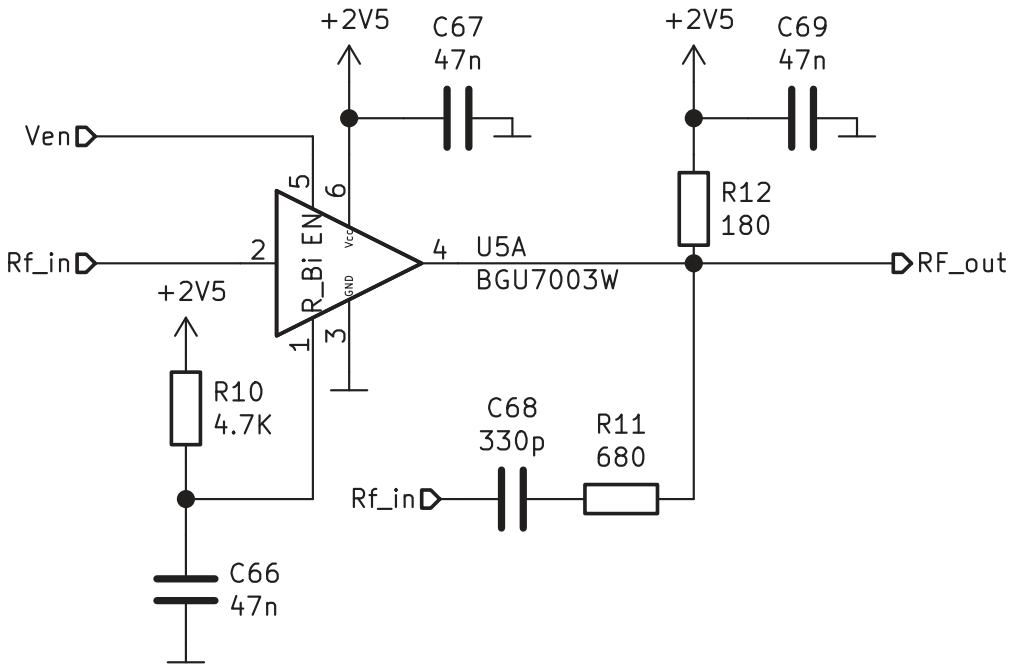
[picture p117: page 9]

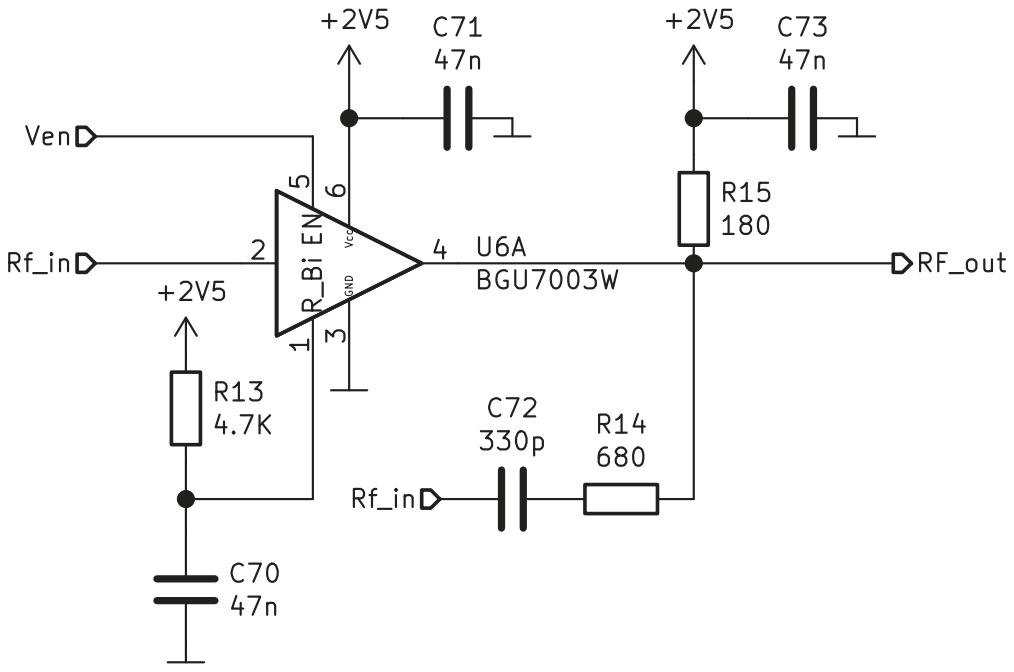
[picture p118: page 10]

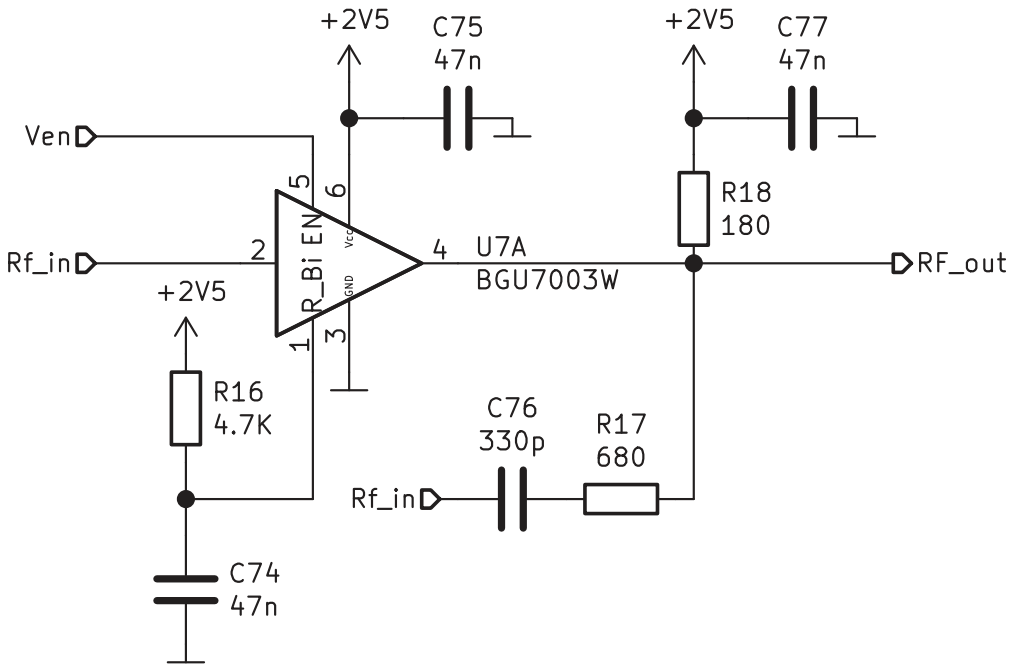
[picture p119: page 11]

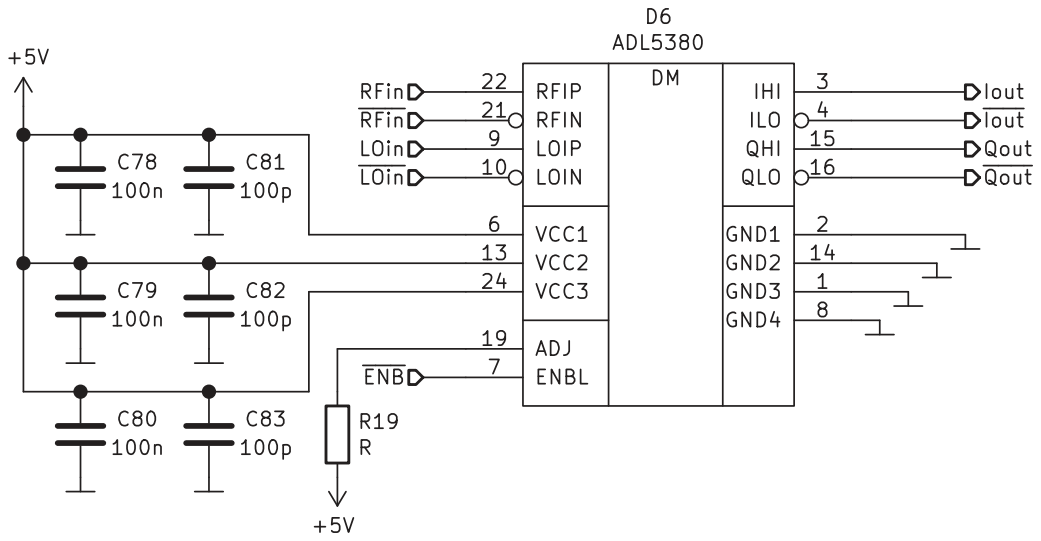
[picture p120: page 12]

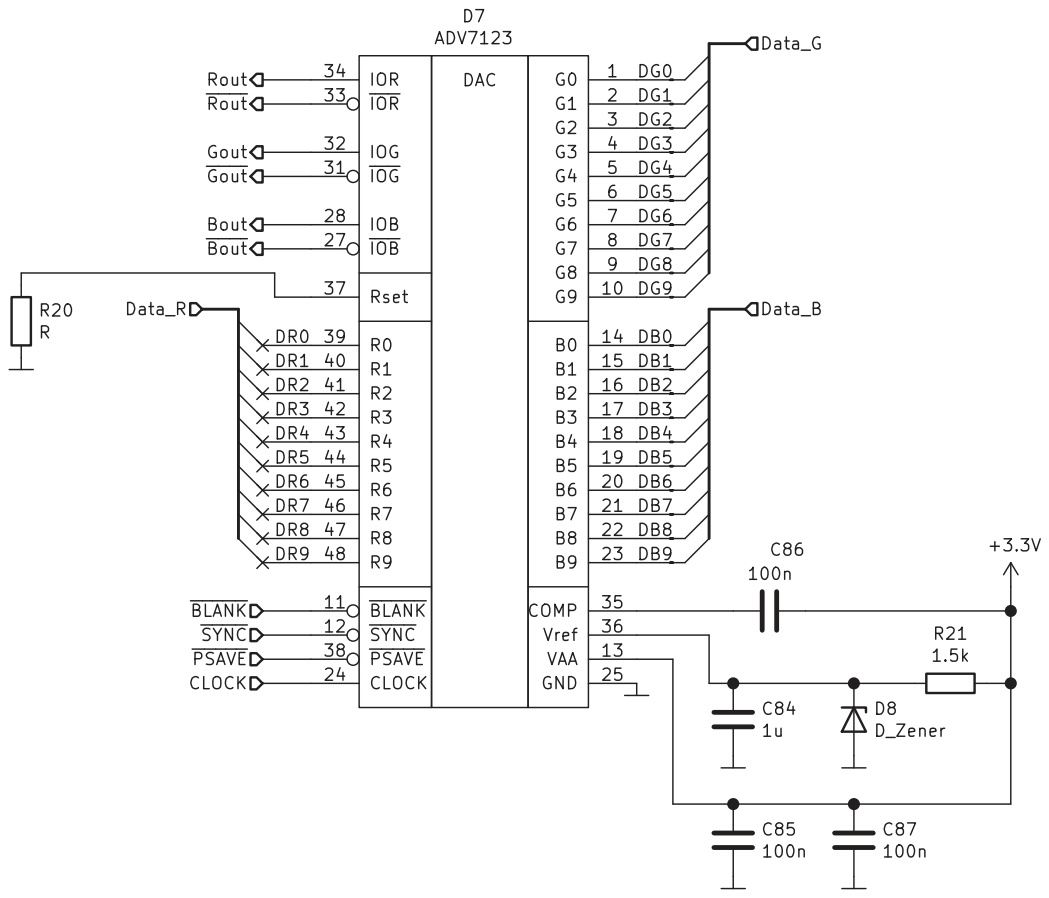
[picture p121: page 13]

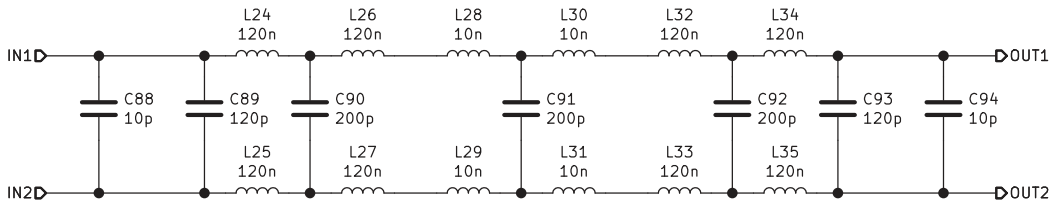
[picture p122: page 14]

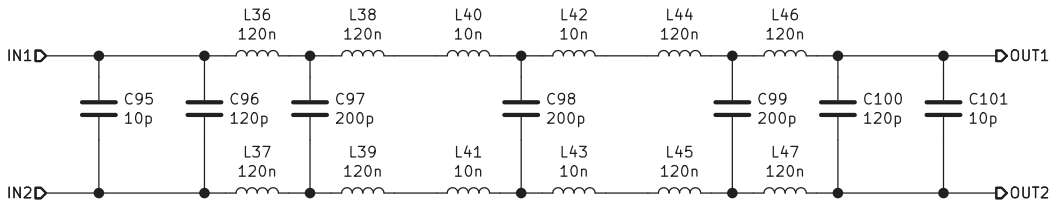
[picture p123: page 15]

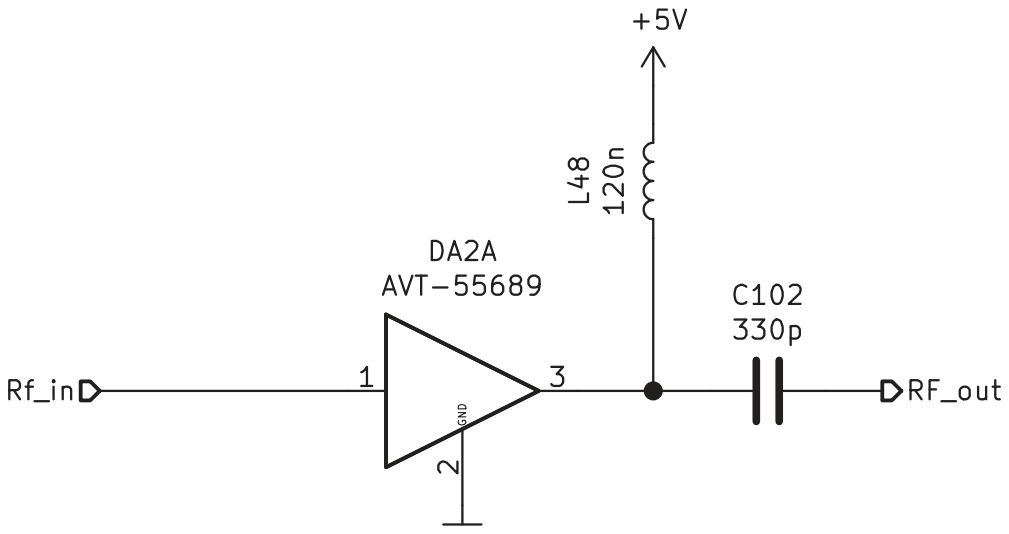
[picture p124: page 16]

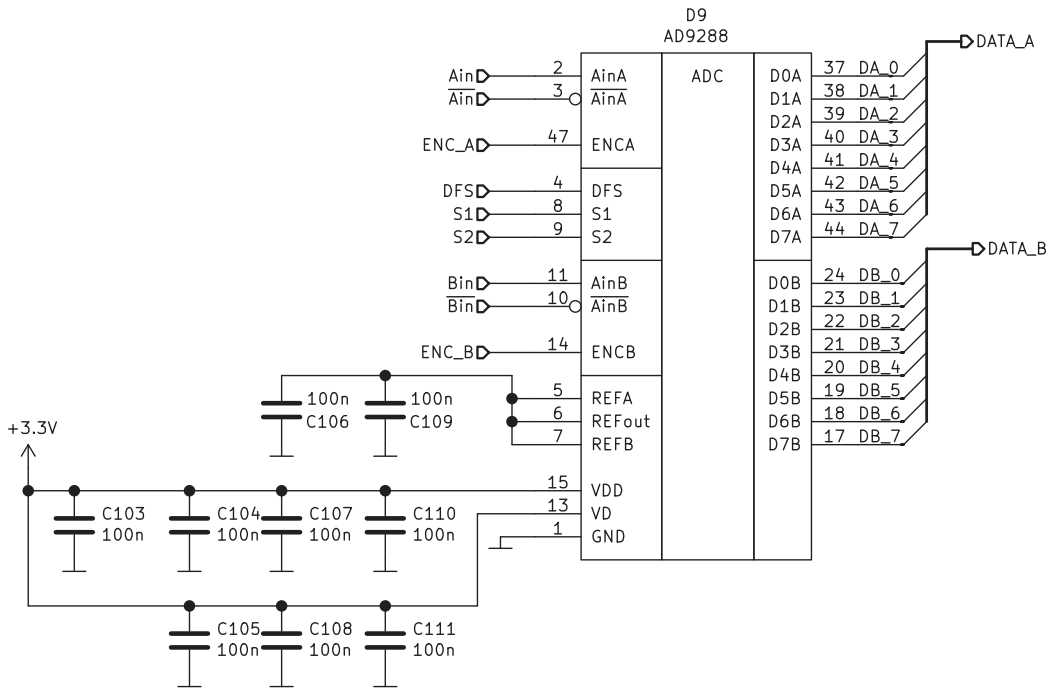
[picture p125: page 17]
