BYakov/Rx-Tx_module/PCB/SDR/SDR.pdf

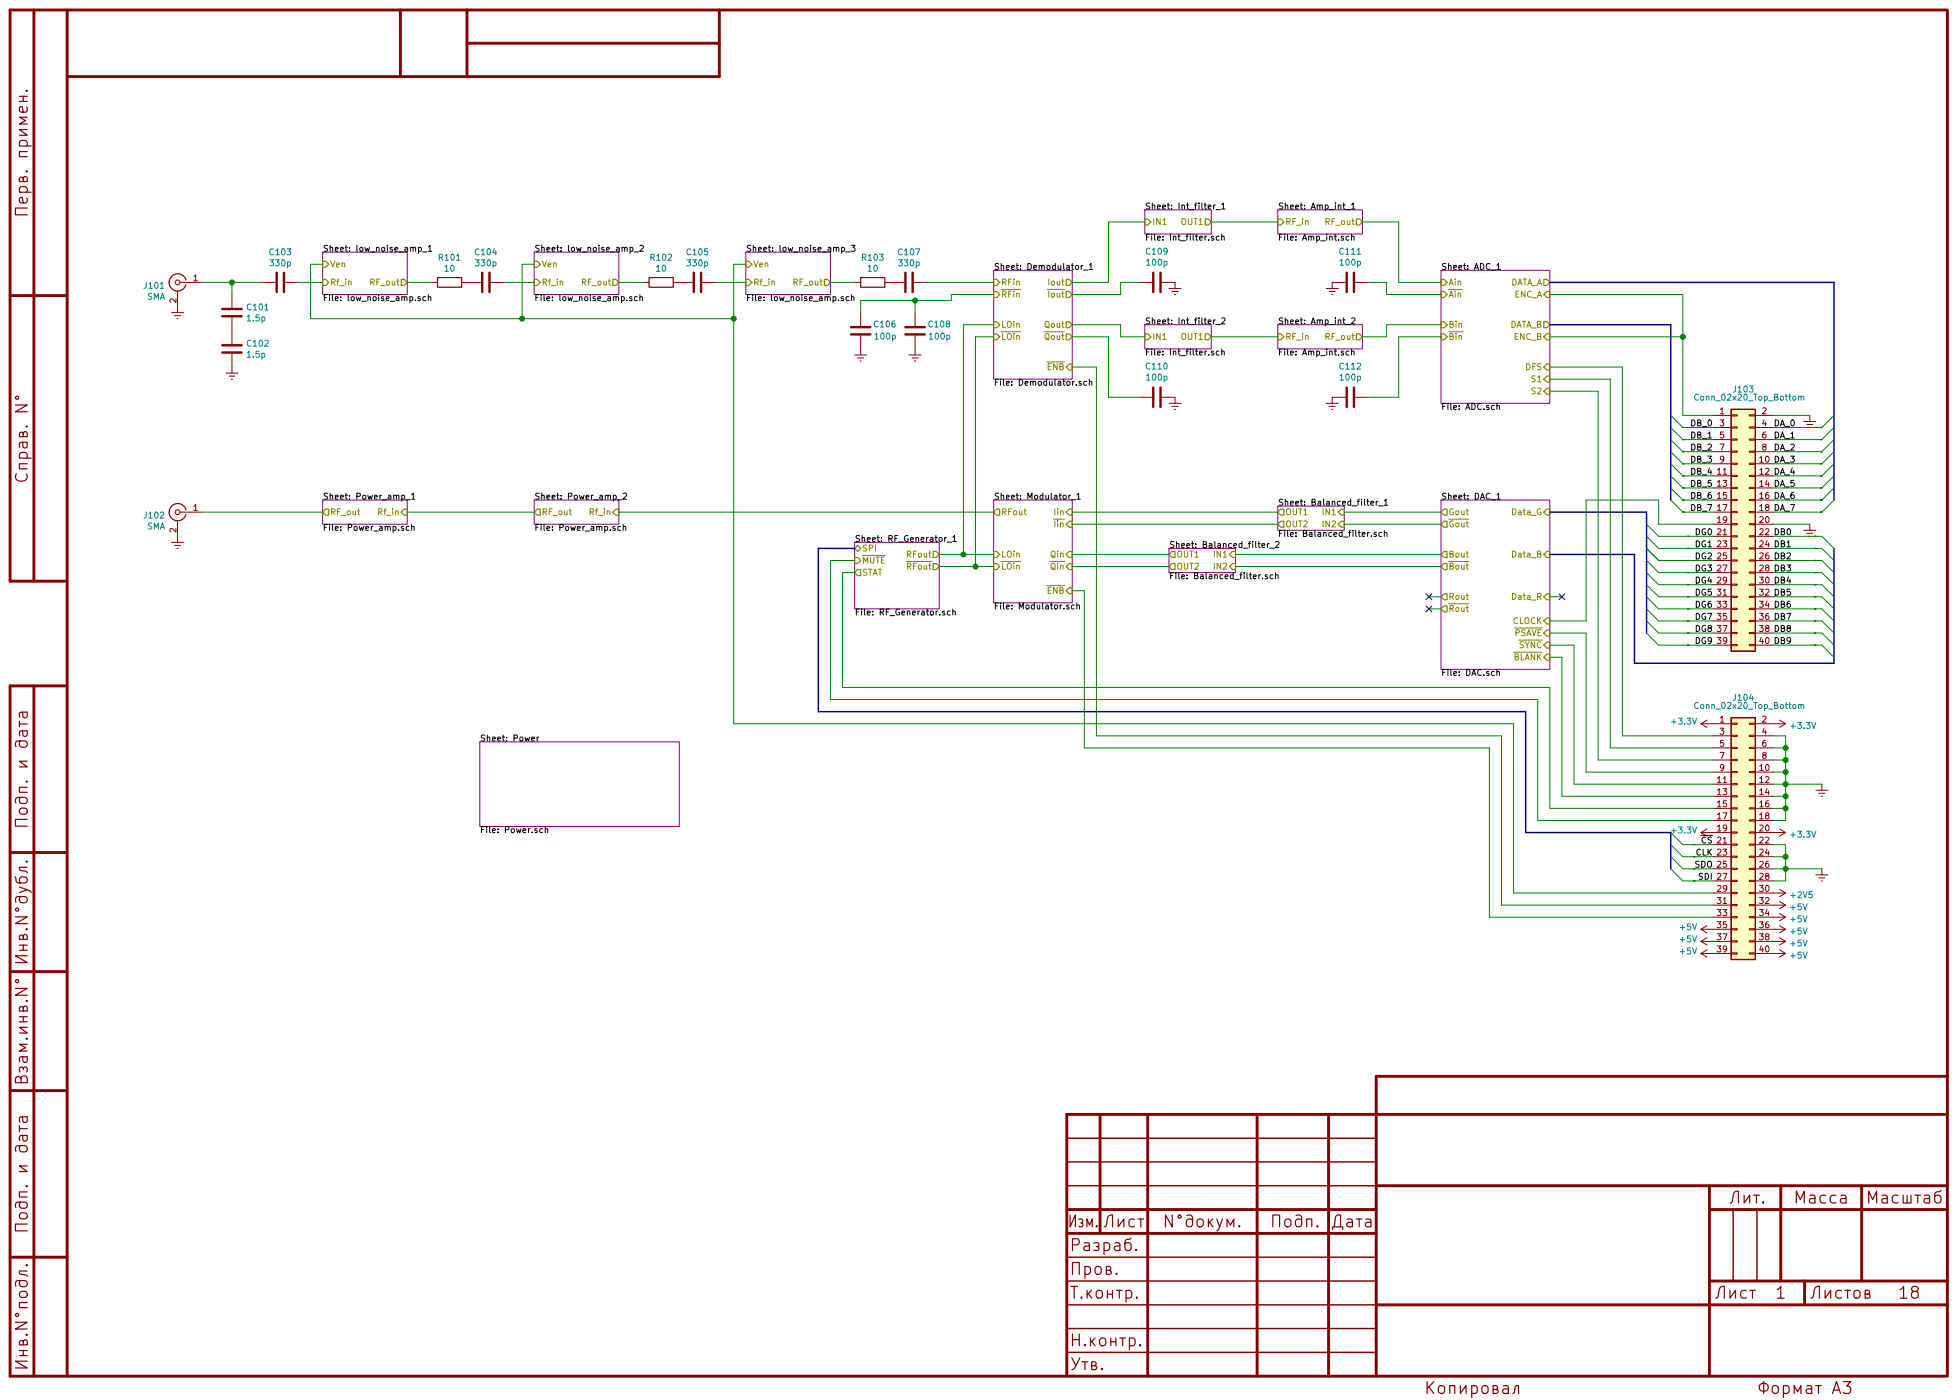
[picture p126: page 1]

S1S2 Ain Ain Bin Bin Sheet: low_noise_amp_3

BLANK Rout Gout Bout Sheet: Demodulator_1 File: Demodulator.sch
Iout Qout Qout RFin RFin

Sheet: Modulator_1 File: Modulator.sch

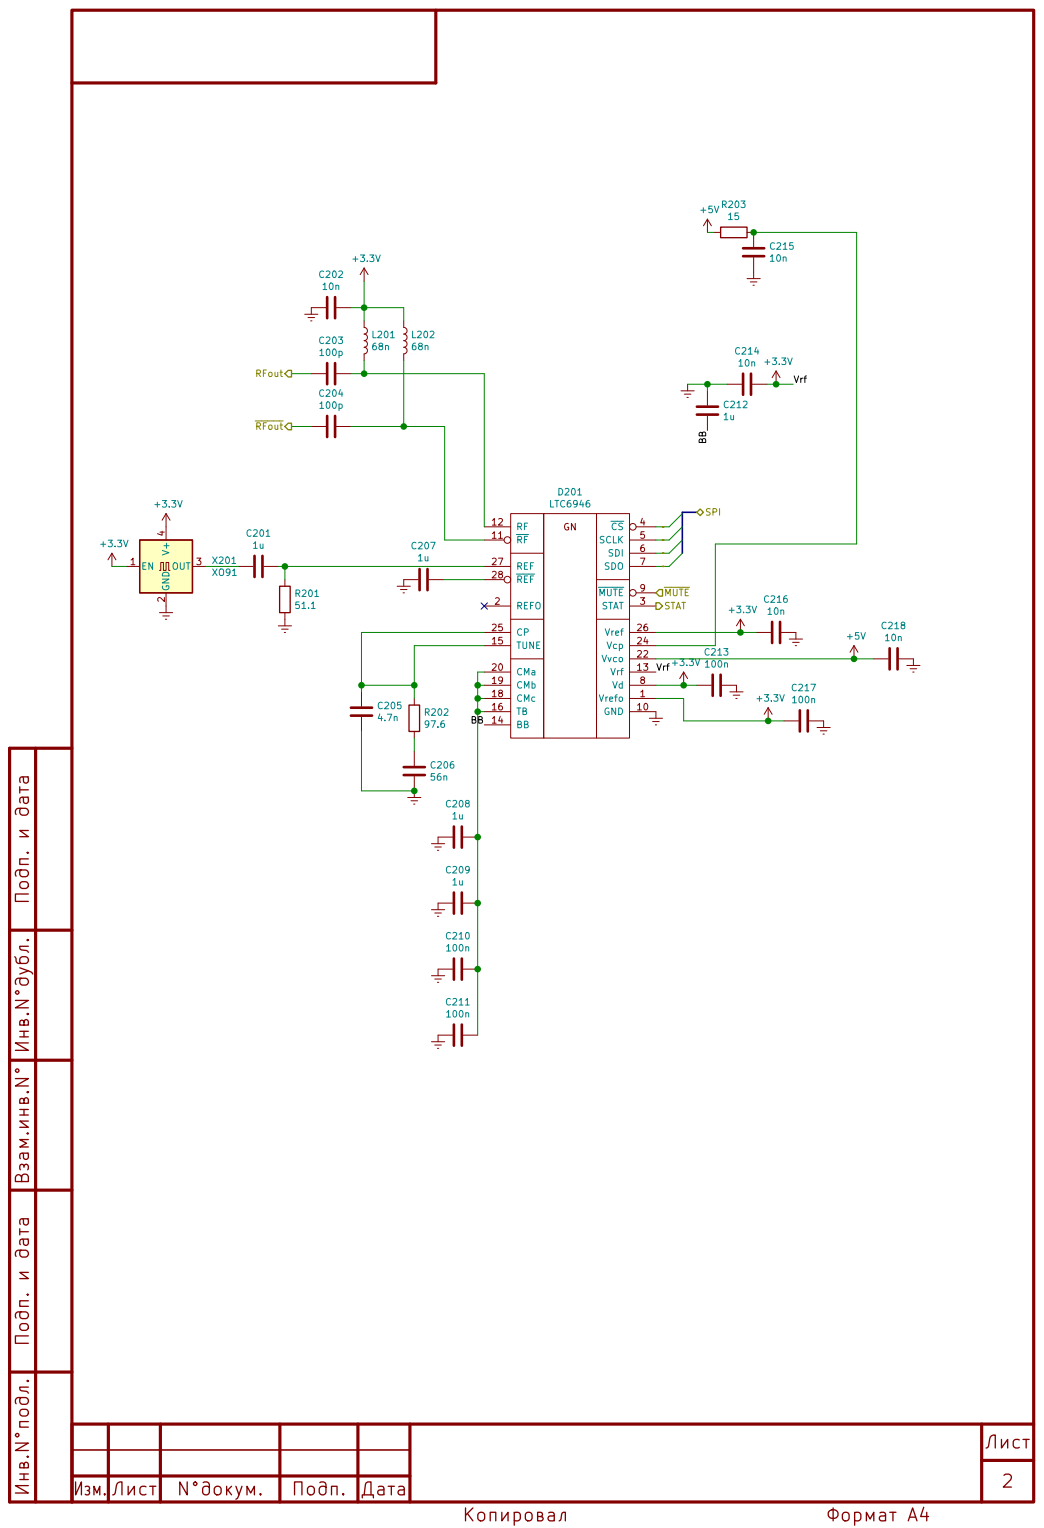
[picture p127: page 2]

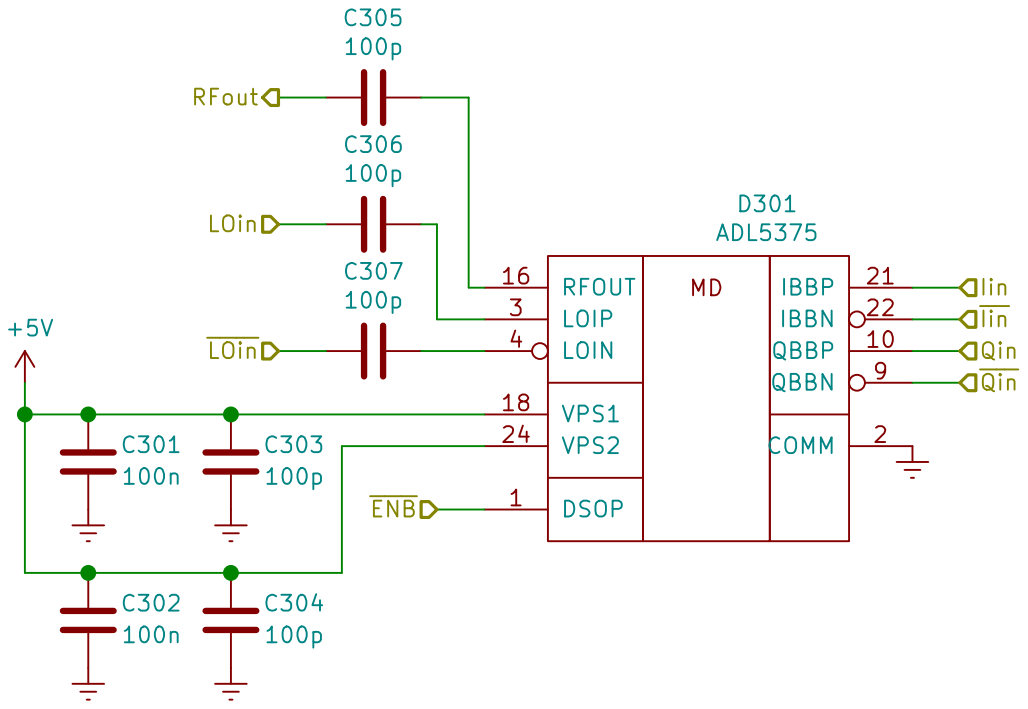
[picture p128: page 3]

IinQin Qin RFout LOin

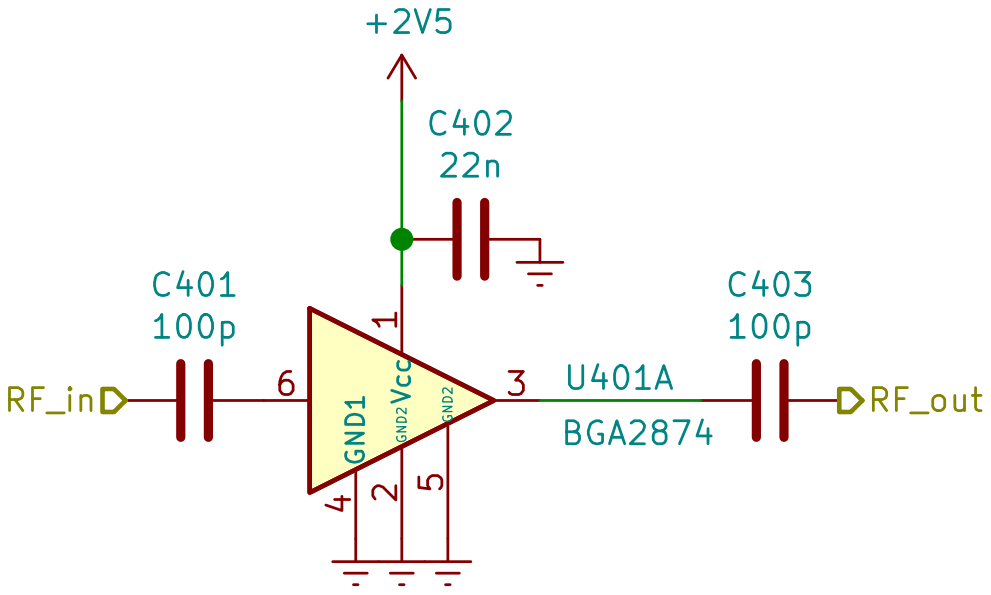
[picture p129: page 4]

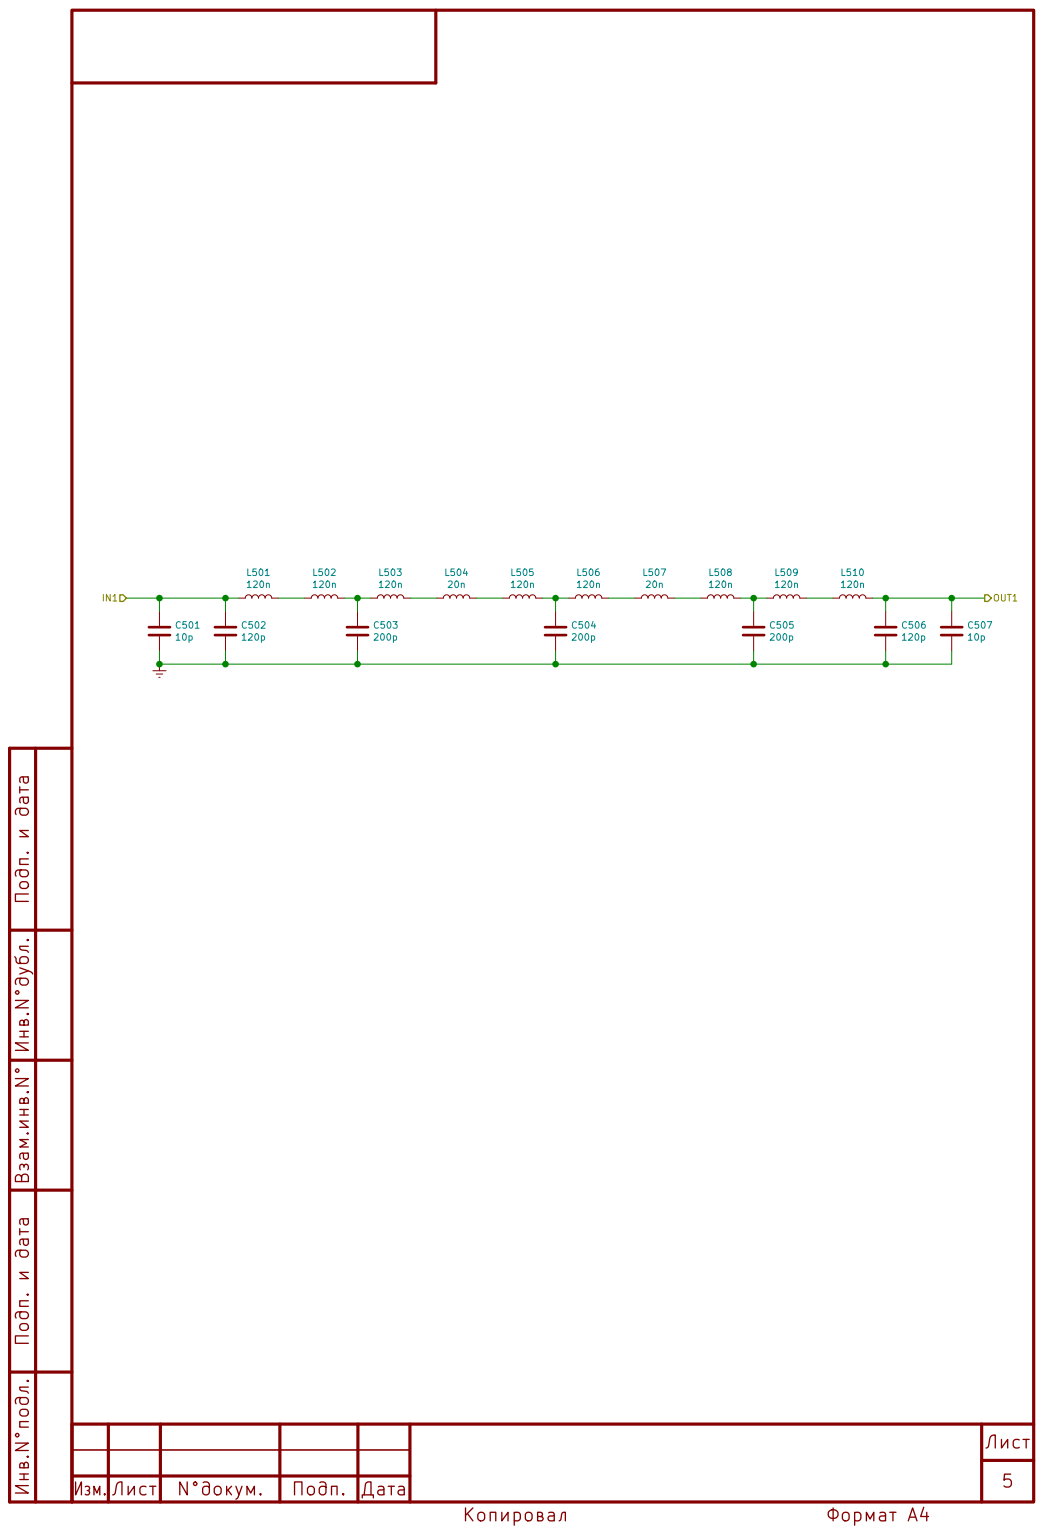
[picture p130: page 5]

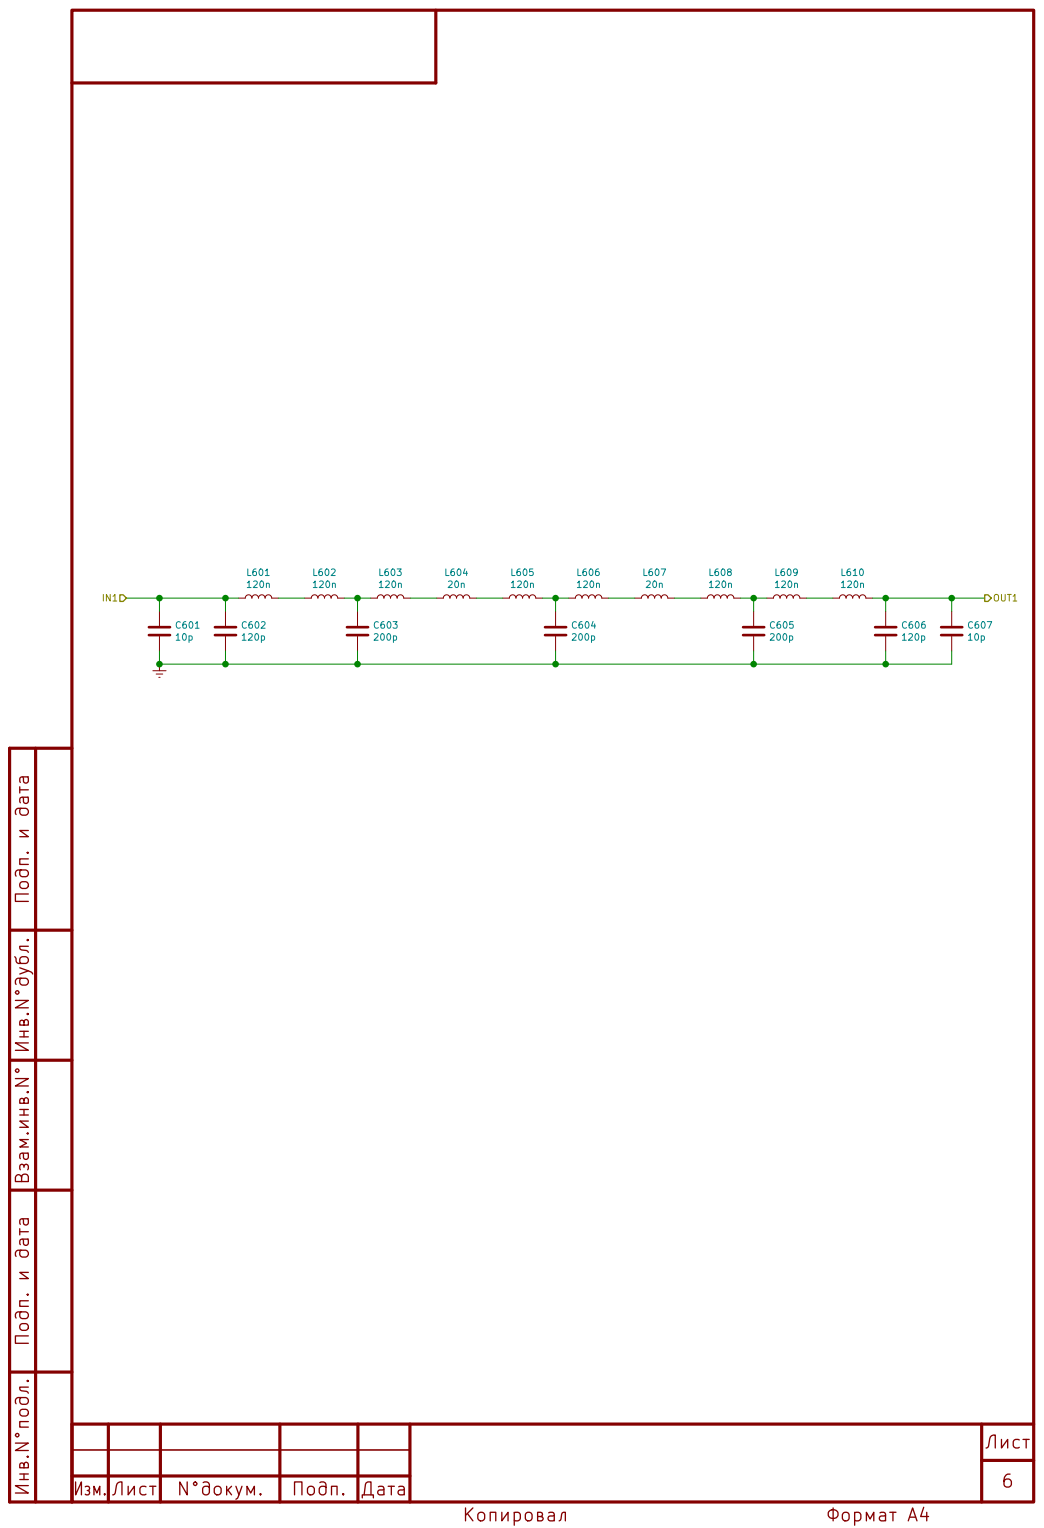
[picture p131: page 6]

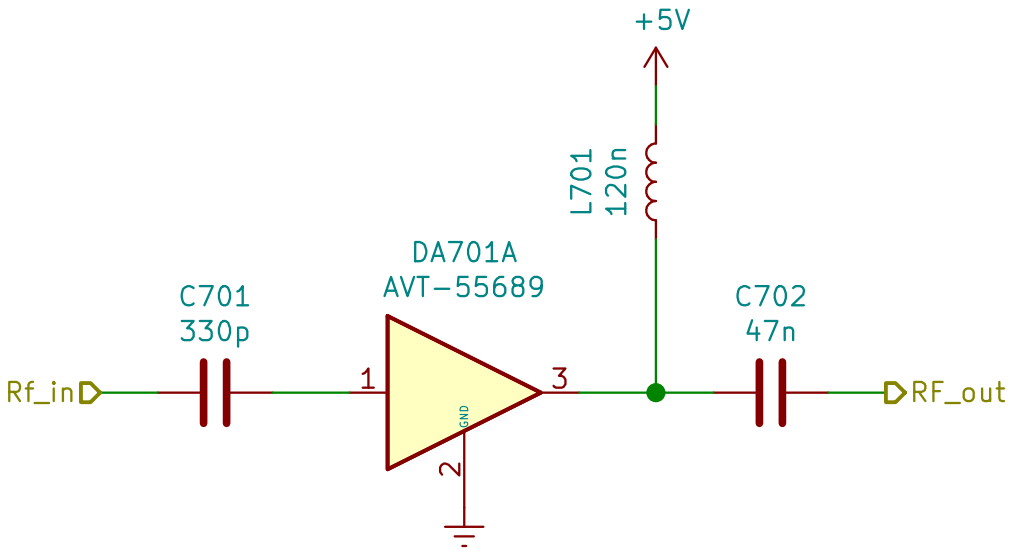
[picture p132: page 7]

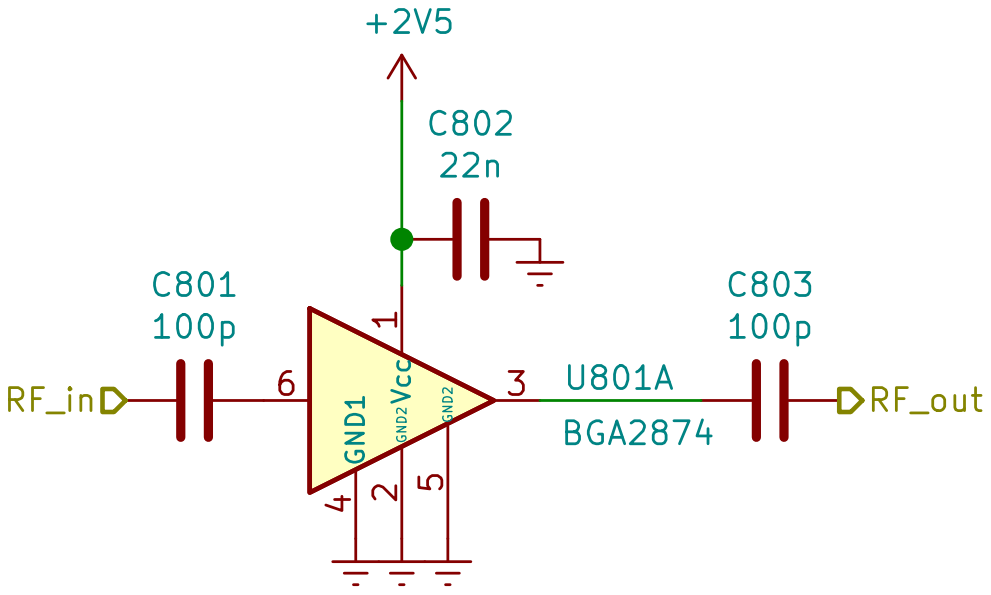
[picture p133: page 8]

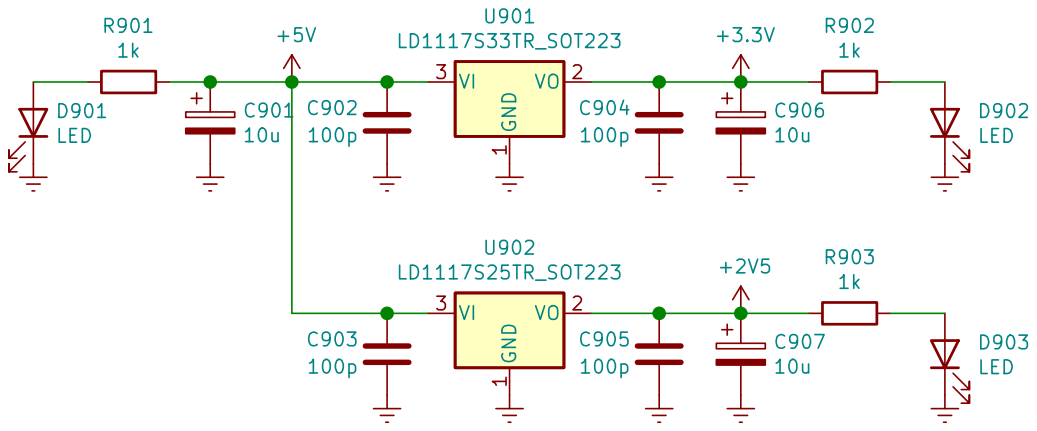
[picture p134: page 9]

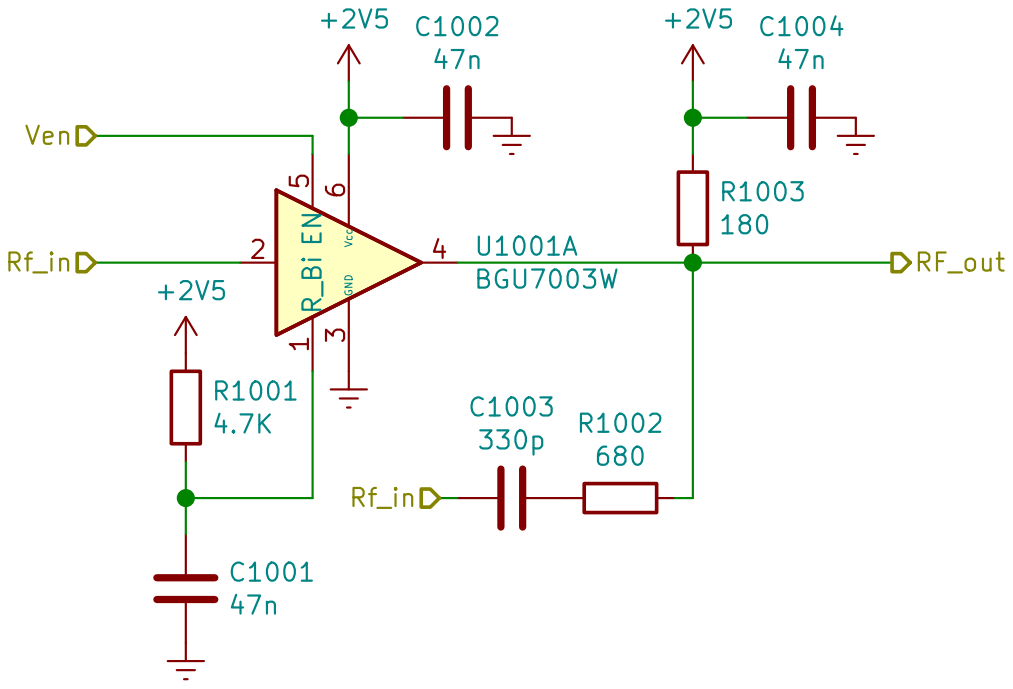
[picture p135: page 10]

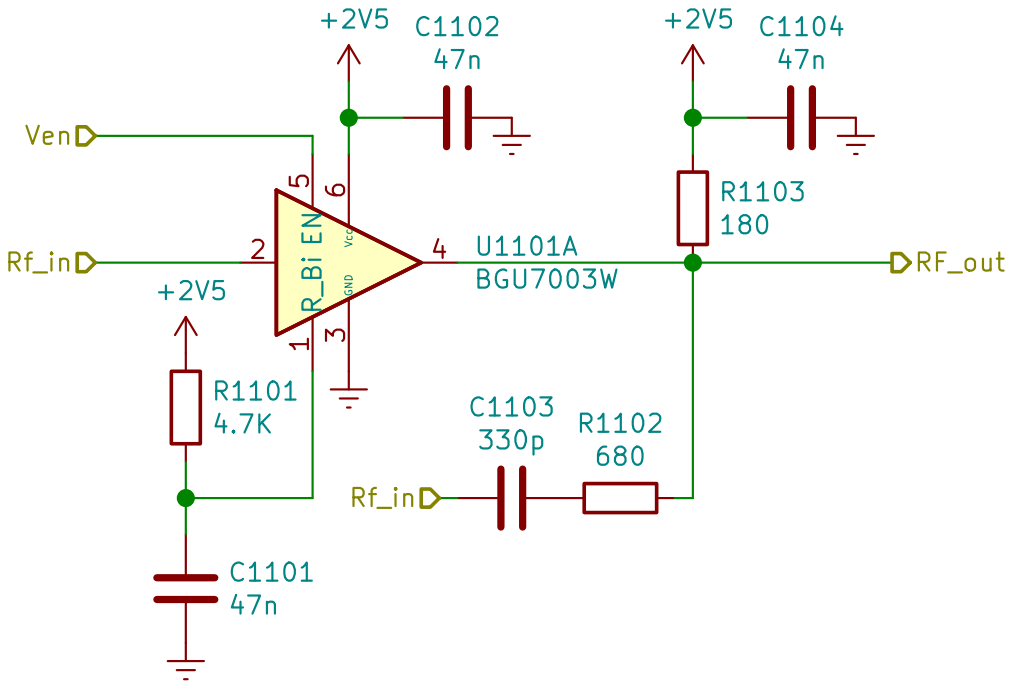
[picture p136: page 11]

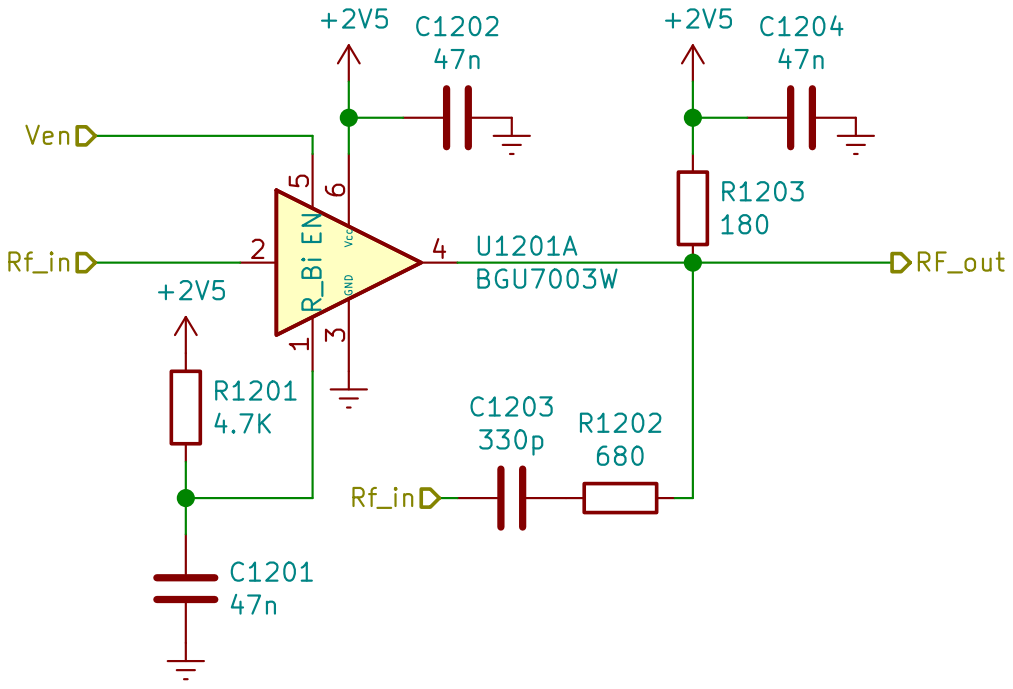
[picture p137: page 12]

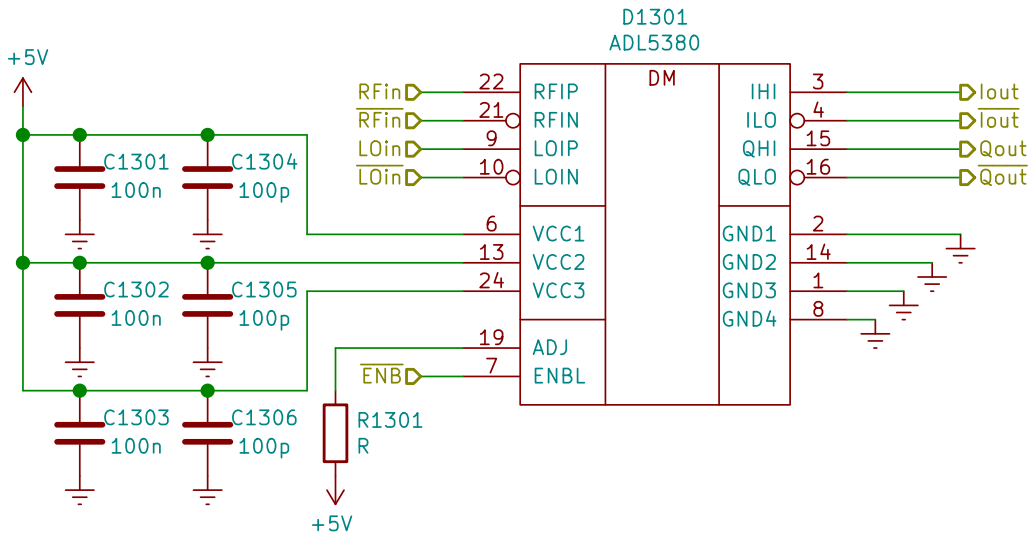
[picture p138: page 13]

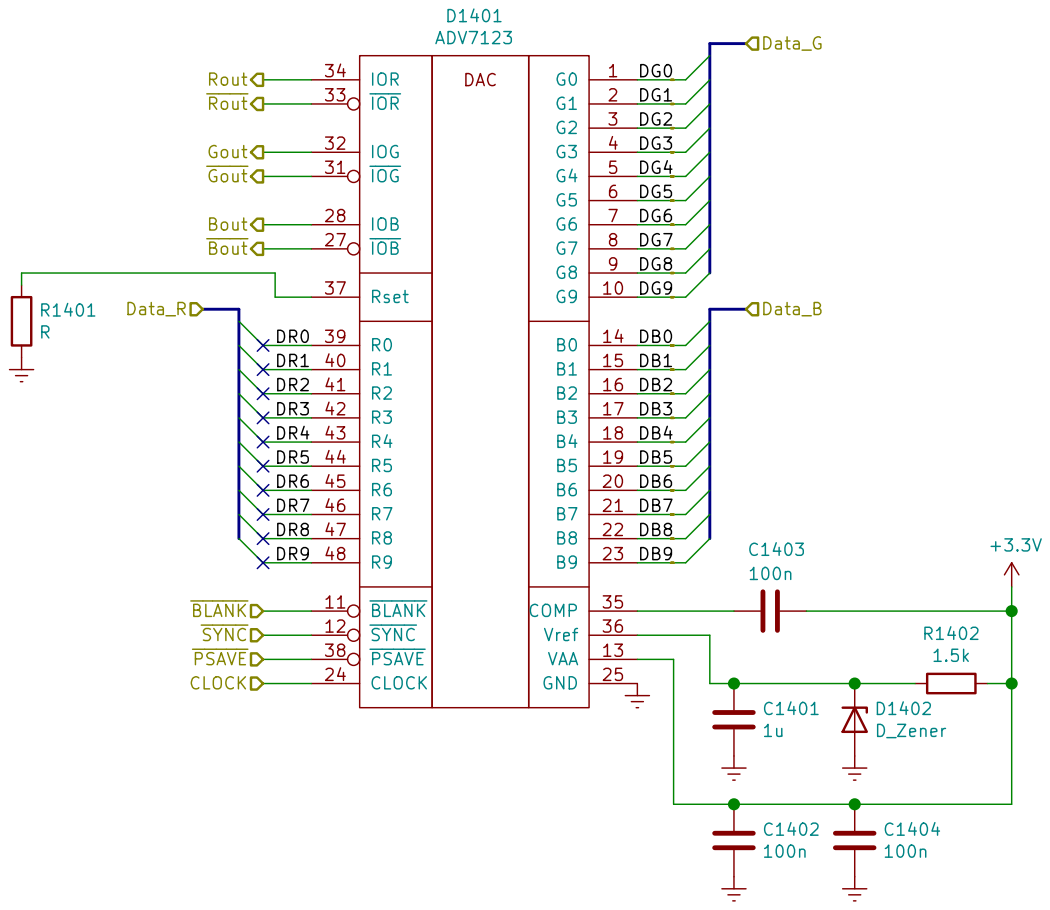
[picture p139: page 14]

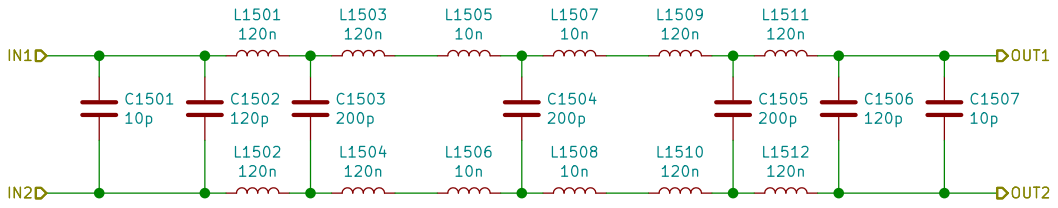
[picture p140: page 15]

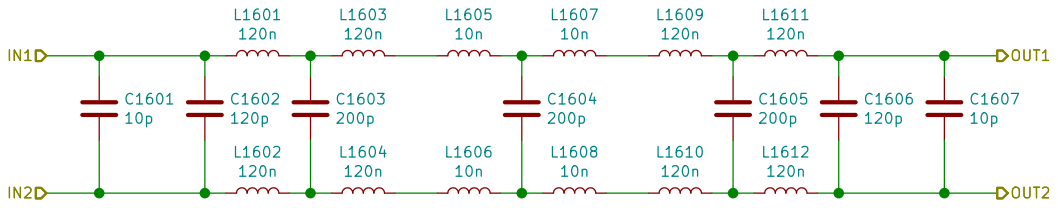
[picture p141: page 16]

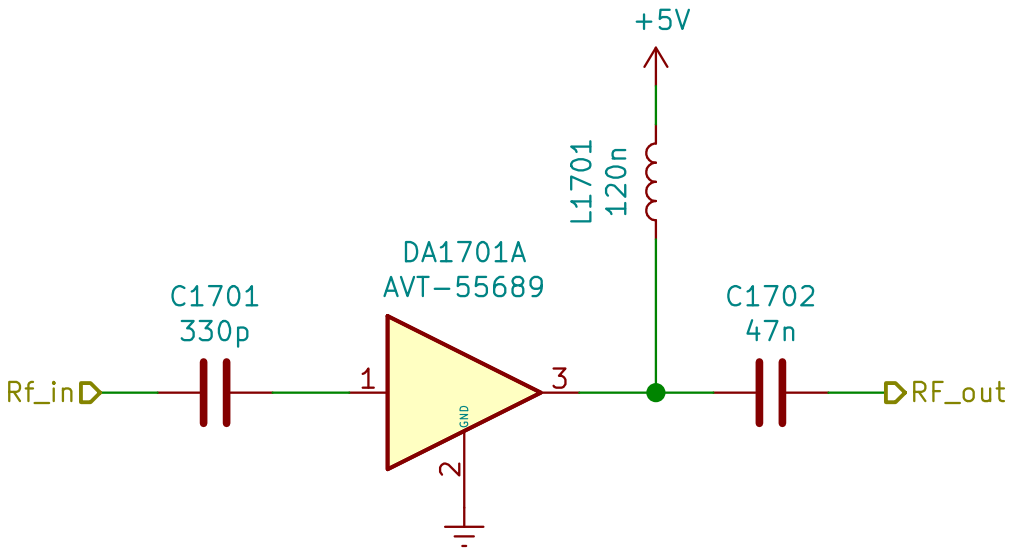
[picture p142: page 17]

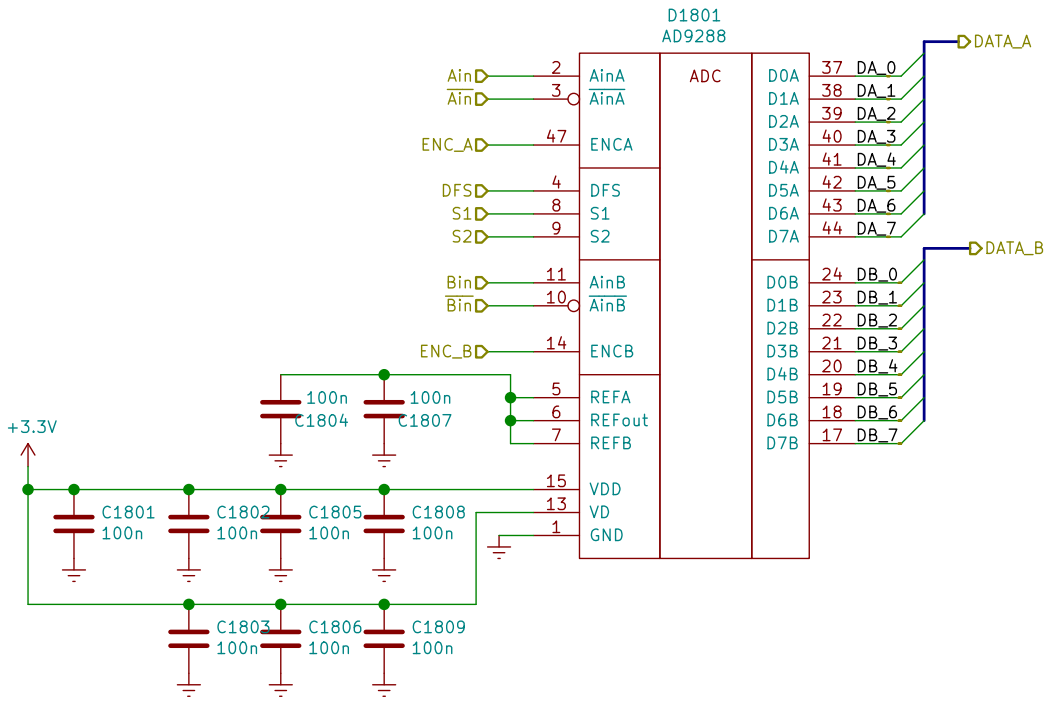
[picture p143: page 18]
