BYakov/Rx-Tx_module/Oldfiles/усилитель 100Мгц/усилок_v4_с Ару.cir

[Main]
FileType=CIR
Version=12.00
Program=Micro-Cap
Component Version=10.00
Shape Version=11.00
Screen=1366,768
MCAPVersion=12.2.0.2
Key ID=Demo
NLCnt=93
TXCnt=0

[shapedef]
Name=Battery
Line=0,0,22,0
Line=22,-3,22,3
Line=26,-7,26,7
Line=26,0,48,0
Current=32,8,16,8

[shapedef]
Name=Bjt.root
Line=0,0,13,0
Rectangle=13,-12,15,12
Current=32,-24,32,-16
Current=32,24,32,16
Current=0,-8,8,-8
PolyOpen=3
PolyLine=24,-24
PolyLine=24,-12
PolyLine=14,-2
PolyOpen=3
PolyLine=24,24
PolyLine=24,12
PolyLine=14,2

[shapedef]
Name=Capacitor
Line=0,0,22,0
Line=22,-8,22,8
Line=26,-8,26,8
Line=26,0,48,0
Current=32,12,16,12

[shapedef]
Name=Ground
Line=0,0,12,0
Line=12,-8,12,8
Line=18,-4,18,4
Line=24,0,24,0

[shapedef]
Name=NPN
Root="Bjt.root",0,0,0
PolyClosed=3
PolyLine=20,12
PolyLine=24,12
PolyLine=24,8

[shapedef]
Name=Plus.root
Line=-2,0,2,0
Line=0,-2,0,2

[shapedef]
Name=Resistor
PolyOpen=12
PolyLine=0,0
PolyLine=0,0
PolyLine=12,0
PolyLine=14,-4
PolyLine=18,4
PolyLine=22,-4
PolyLine=26,4
PolyLine=30,-4
PolyLine=34,4
PolyLine=36,0
PolyLine=48,0
PolyLine=48,0
Current=32,8,16,8

[shapedef]
Name=Sine_Source
Root="Vsource.root",0,0,0
Line=24,-6,26,-4
Line=26,-4,26,-2
Line=26,-2,22,2
Line=22,2,22,4
Line=22,4,24,6

[shapedef]
Name=Vsource.root
Line=0,0,12,0
Line=36,0,48,0
Ellipse=12,-12,36,12
FColor=None
Line=7,5,7,9
Root="Plus.root",41,7,0
Current=32,16,16,16

[compdef]
Name=Resistor
Definition=Resistor
Shape=Resistor
Mask=7425
Used=165
memo=Resistor
Label Offset=18,6,8,11
PinCnt=2
Pin="Plus",6,0,-10,-4
Pin="Minus",0,0,-14,-4

[compdef]
Name=Capacitor
Definition=Capacitor
Shape=Capacitor
Mask=7425
Used=30
memo=Capacitor
Label Offset=16,12,12,12
PinCnt=2
Pin="Plus",6,0,-3,-5
Pin="Minus",0,0,-14,-5

[compdef]
Name=Sine Source
Definition=Sine source
Shape=Sine_Source
Mask=4864
Used=2
memo=Sine Source
Label Offset=18,12,15,12
PinCnt=2
Pin="Plus",6,0,-6,-6
Pin="Minus",0,0,-19,-6

[compdef]
Name=Battery
Definition=Battery
Shape=Battery
Mask=7425
Used=54
memo=Battery
Label Offset=19,7,10,13
PinCnt=2
Pin="Plus",6,0,-4,-5
Pin="Minus",0,0,-10,-5

[compdef]
Name=NPN
Definition=NPN
Shape=NPN
Mask=4097
Used=15
memo=NPN Transistor
Label Offset=37,-17,-14,33
PinCnt=3
Pin="Collector",3,-3,4,14
Pin="Base",0,0,-18,-3
Pin="Emitter",3,3,5,1

[compdef]
Name=Ground
Definition=Ground
Shape=Ground
Mask=1793
Used=260
memo=Ground
Label Offset=0,0,0,0
PinCnt=1
Pin="PinA",0,0,-3,-7

[Circuit]
Window Placement=2,3, -1,-1, -8,-31, 52,52,1051,435
Default Object=Color=#000080
Default Object Font=Height=-15,FStyle=0,Color=#000080,Name=Arial
Default Object Apply Border To Text=No
Default Object Apply Fill To Text=No
Default Object GridSnap=No
NodeVoltageFormat=3
CurrentFormat=3
PowerFormat=3
PathDelayFormat=3
WarningFormat=3
GridTextFormulaFormat=3
Window Placement in Transient Analysis=0,1, -1,-1, -8,-31, 676,0,1352,520
Window Placement in AC Analysis=2,3, -1,-1, -8,-31, 156,156,1341,508
SpiceType=AMBIGUOUS
Title_Block_Border=None
Title_Block=False
Show Nodes=True
Show Voltages=True
Show Current=False
Show Power=False
Show Condition=False
Show Pin Connections=False
Show Connection Warnings=False
Show Cross=False
Show Attribute Text=True
Show Grid Text=True

[Comp]
Name=Resistor
Px=240,176
Rot=2
Page=3

[Attr]
ON=-24,-25,PART
V=R1
Style=8192

[Attr]
ON=-24,-39,RESISTANCE
V=330
Style=8192

[Attr]
ON=0,0,PACKAGE
V

[Comp]
Name=Resistor
Px=360,248
Rot=3
Page=3

[Attr]
ON=-24,-25,PART
V=R2
Style=8192

[Attr]
ON=-32,-39,RESISTANCE
V=2.2k
Style=8192

[Attr]
ON=0,0,PACKAGE
V

[Comp]
Name=Resistor
Px=368,96
Rot=3
Page=3

[Attr]
ON=-24,-25,PART
V=R3
Style=8192

[Attr]
ON=-23,-39,RESISTANCE
V=3k
Style=8192

[Attr]
ON=0,0,PACKAGE
V

[Comp]
Name=Resistor
Px=440,312
Rot=3
Page=3

[Attr]
ON=-24,-25,PART
V=R4
Style=8192

[Attr]
ON=-24,-39,RESISTANCE
V=355
Style=8192

[Attr]
ON=0,0,PACKAGE
V

[Comp]
Name=Resistor
Px=448,96
Rot=3
Page=3

[Attr]
ON=-24,-25,PART
V=R5
Style=8192

[Attr]
ON=-32,-39,RESISTANCE
V=600
Style=8192

[Attr]
ON=0,0,PACKAGE
V

[Comp]
Name=Capacitor
Px=256,176
Rot=4
Page=3

[Attr]
ON=12,-26,PART
V=C1
Style=8192

[Attr]
ON=12,-36,CAPACITANCE
V=1u
Style=8192

[Attr]
ON=0,0,PACKAGE
V

[Comp]
Name=Capacitor
Px=472,320
Rot=5
Page=3

[Attr]
ON=11,-26,PART
V=C2
Style=8192

[Attr]
ON=12,-41,CAPACITANCE
V=1u
Style=8192

[Attr]
ON=0,0,PACKAGE
V

[Comp]
Name=Sine Source
Px=184,240
Rot=3
Page=3

[Attr]
ON=-31,-26,PART
V=V1
Style=8192

[Attr]
ON=-50,-40,MODEL
V=1MHZ

[Attr]
ON=0,0,PACKAGE
V

[Comp]
Name=Battery
Px=80,232
Rot=5
Page=3
COff=8,54,245,43,3

[Attr]
ON=-26,13,PART
V=V2
Style=8192

[Attr]
ON=-30,27,VALUE
V=8.5
Style=8192

[Attr]
ON=0,0,PACKAGE
V

[Wire]
Pxs=80,48,80,184
Page=3

[Wire]
Pxs=368,48,448,48
Page=3

[Wire]
Pxs=80,232,80,352
Page=3

[Wire]
Pxs=80,352,184,352
Page=3

[Wire]
Pxs=184,240,184,352
Page=3

[Wire]
Pxs=184,352,360,352
Page=3

[Wire]
Pxs=184,176,184,192
Page=3

[Wire]
Pxs=184,176,192,176
Page=3

[Wire]
Pxs=240,176,256,176
Page=3

[Wire]
Pxs=304,176,360,176
Page=3

[Wire]
Pxs=360,176,360,200
Page=3

[Wire]
Pxs=360,248,360,352
Page=3

[Wire]
Pxs=360,352,384,352
Page=3

[Wire]
Pxs=440,256,440,264
Page=3

[Wire]
Pxs=472,256,472,272
Page=3

[Wire]
Pxs=440,256,472,256
Page=3

[Comp]
Name=NPN
Px=392,184
Page=3

[Attr]
ON=-55,-17,PART
V=Q1
Style=8192

[Attr]
ON=-86,-3,MODEL
V=BFR193F

[Attr]
ON=-75,25,PACKAGE
V=TO-92

[Wire]
Pxs=360,176,368,176
Page=3

[Wire]
Pxs=368,184,392,184
Page=3

[Wire]
Pxs=368,176,368,184
Page=3

[Wire]
Pxs=416,144,416,160
Page=3

[Wire]
Pxs=416,144,440,144
Page=3

[Wire]
Pxs=440,312,440,352
Page=3

[Wire]
Pxs=440,352,472,352
Page=3

[Wire]
Pxs=472,320,472,352
Page=3

[Wire]
Pxs=472,352,512,352
Page=3

[Wire]
Pxs=416,256,440,256
Page=3

[Wire]
Pxs=416,208,416,256
Page=3

[Wire]
Pxs=448,96,448,144
Page=3

[Wire]
Pxs=448,144,464,144
Page=3

[Comp]
Name=Ground
Px=384,352
Rot=7
Page=3

[Wire]
Pxs=384,352,440,352
Page=3

[Wire]
Pxs=368,96,368,176
Page=3

[Comp]
Name=NPN
Px=464,144
Page=3

[Attr]
ON=-55,-17,PART
V=Q2
Style=8192

[Attr]
ON=-86,-3,MODEL
V=BFR193F

[Attr]
ON=-75,25,PACKAGE
V=TO-92

[Comp]
Name=Resistor
Px=488,120
Rot=3
Page=3

[Attr]
ON=-24,-25,PART
V=R6
Style=8192

[Attr]
ON=-32,-39,RESISTANCE
V=460
Style=8192

[Attr]
ON=0,0,PACKAGE
V

[Wire]
Pxs=448,48,488,48
Page=3

[Comp]
Name=Resistor
Px=544,328
Rot=3
Page=3

[Attr]
ON=-24,-25,PART
V=R7
Style=8192

[Attr]
ON=-24,-39,RESISTANCE
V=390
Style=8192

[Attr]
ON=0,0,PACKAGE
V

[Comp]
Name=Capacitor
Px=576,256
Rot=5
Page=3

[Attr]
ON=11,-26,PART
V=C3
Style=8192

[Attr]
ON=12,-41,CAPACITANCE
V=1u
Style=8192

[Attr]
ON=0,0,PACKAGE
V

[Wire]
Pxs=544,168,544,208
Page=3

[Wire]
Pxs=488,168,544,168
Page=3

[Wire]
Pxs=544,328,544,352
Page=3

[Wire]
Pxs=544,352,576,352
Page=3

[Wire]
Pxs=488,48,488,72
Page=3

[Wire]
Pxs=488,120,584,120
Page=3

[Comp]
Name=Resistor
Px=976,280
Rot=3
Page=3

[Attr]
ON=-24,-25,PART
V=R8
Style=8192

[Attr]
ON=-32,-39,RESISTANCE
V=330
Style=8192

[Attr]
ON=0,0,PACKAGE
V

[Wire]
Pxs=976,144,976,232
Page=3

[Wire]
Pxs=976,280,976,368
Page=3

[Comp]
Name=NPN
Px=584,120
Page=3

[Attr]
ON=-55,-17,PART
V=Q3
Style=8192

[Attr]
ON=-86,-3,MODEL
V=BFR193F

[Attr]
ON=-75,25,PACKAGE
V=TO-92

[Comp]
Name=Resistor
Px=624,328
Rot=3
Page=3

[Attr]
ON=9,-22,PART
V=R9
Style=8192

[Attr]
ON=12,-37,RESISTANCE
V=355
Style=8192

[Attr]
ON=0,0,PACKAGE
V

[Comp]
Name=Capacitor
Px=672,248
Rot=5
Page=3

[Attr]
ON=11,-26,PART
V=C5
Style=8192

[Attr]
ON=12,-41,CAPACITANCE
V=1u
Style=8192

[Attr]
ON=0,0,PACKAGE
V

[Wire]
Pxs=624,144,624,200
Page=3

[Wire]
Pxs=624,328,624,352
Page=3

[Wire]
Pxs=624,352,648,352
Page=3

[Wire]
Pxs=608,144,624,144
Page=3

[Comp]
Name=Resistor
Px=608,96
Rot=3
Page=3

[Attr]
ON=-24,-25,PART
V=R10
Style=8192

[Attr]
ON=-32,-39,RESISTANCE
V=60
Style=8192

[Attr]
ON=0,0,PACKAGE
V

[Wire]
Pxs=488,48,608,48
Page=3

[Wire]
Pxs=656,144,976,144
Page=3

[Wire]
Pxs=656,96,656,144
Page=3

[Wire]
Pxs=608,96,656,96
Page=3

[Wire]
Pxs=648,368,688,368
Page=3

[Wire]
Pxs=648,352,648,368
Page=3

[Wire]
Pxs=976,368,976,376
Page=3

[Wire]
Pxs=648,352,656,352
Page=3

[Wire]
Pxs=688,368,976,368
Page=3

[Wire]
Pxs=688,248,688,264
Page=3

[Wire]
Pxs=672,248,688,248
Page=3

[Wire]
Pxs=624,200,672,200
Page=3

[Wire]
Pxs=624,200,624,280
Page=3

[Wire]
Pxs=80,48,368,48
Page=3

[Comp]
Name=Resistor
Px=688,312
Rot=5
Page=3

[Attr]
ON=8,-25,PART
V=R11
Style=8192

[Attr]
ON=8,-39,RESISTANCE
V=0
Style=8192

[Attr]
ON=0,0,PACKAGE
V

[Wire]
Pxs=688,312,688,368
Page=3

[Wire]
Pxs=544,208,576,208
Page=3

[Wire]
Pxs=544,208,544,280
Page=3

[Comp]
Name=Resistor
Px=576,328
Rot=5
Page=3

[Attr]
ON=8,-25,PART
V=R12
Style=8192

[Attr]
ON=8,-39,RESISTANCE
V=0
Style=8192

[Attr]
ON=0,0,PACKAGE
V

[Wire]
Pxs=576,256,576,280
Page=3

[Wire]
Pxs=576,328,576,352
Page=3

[Wire]
Pxs=576,352,624,352
Page=3

[Comp]
Name=Resistor
Px=512,264
Rot=3
Page=3

[Attr]
ON=-24,-25,PART
V=R13
Style=8192

[Attr]
ON=-24,-39,RESISTANCE
V=1.5meg
Style=8192

[Attr]
ON=0,0,PACKAGE
V

[Wire]
Pxs=512,192,512,216
Page=3

[Wire]
Pxs=440,192,512,192
Page=3

[Wire]
Pxs=440,144,440,192
Page=3

[Wire]
Pxs=440,144,448,144
Page=3

[Wire]
Pxs=512,264,512,352
Page=3

[Wire]
Pxs=512,352,544,352
Page=3

[Schematic]
CurrentSection 0=0
CurrentSection 1=0
CurrentSection 2=0
CurrentSection 3=0
Splitter.xs=0
Splitter.ys=0
TextQuad=4099
Scale=1
GridUser=10
ShapeGroups="Main","Euro","Polarity","Main1","Main11","Electrolytic","GroundArrow","DeMorgan"
CalcRMS=False
CalcAVG=False
CalcPeak=False
CalcVoltage=True
DisplayMeasure=Last
ShareScales=True

[Tools]
Pos=Top
FILESAVEASOLD=No
BOM=No
FILEPCB=No
PROBE=Yes
SELECT=Yes
PAN=Yes
COMP=Yes
TEXT=Yes
WIRE=Yes
WIRED=Yes
BUS=Yes
GRAPHIC=Yes
FLOWCHART=Yes
LINE=No
ELLIPSE=No
RECT=No
DIAM=No
ARC=No
PIE=No
TRIANGLE=No
STAR=No
LEFTBRK=No
RIGHTBRK=No
BOTHBRK=No
META=No
PARALLELOGRAM=No
FC_PROCESS=No
FC_ALT_PROCESS=No
FC_DECISION=No
FC_DATA=No
FC_PREDEFPROCESS=No
FC_INTERNALSTORAGE=No
FC_DOCUMENT=No
FC_MULTIDOCUMENT=No
FC_TERMINATOR=No
FC_PREPARATION=No
FC_MANUALINPUT=No
FC_MANUALOPERATION=No
FC_CONNECTOR=No
FC_OFFPAGECONNECTOR=No
FC_PUNCHCARD=No
FC_PUNCHEDTAPE=No
FC_SUMMING_JUNCTION=No
FC_OR=No
FC_COLLATE=No
FC_SORT=No
FC_EXTRACT=No
FC_MERGE=No
FC_STORED_DATA=No
FC_DELAY=No
FC_SAS=No
FC_MAGNETIC_DISK=No
FC_DAS=No
FC_DISPLAY=No
SPREAD_SHEET=Yes
POLYCLOS=No
POLYOPEN=No
FLAG=Yes
INFO=Yes
HELP=Yes
HELP_SPICE=No
LINK=Yes
CHECK=Yes
REGION_ENABLE=Yes
TITLE_BLOCK=Yes
DIGTRC=No
DIGTRC2=No
BUILD_COMMAND=Yes
DIGALL=No
GRIDTEXT=Yes
COMPTEXT=Yes
NODE=Yes
MEASURED=Yes
NODEV=Yes
CURRENT=Yes
POWER=Yes
CONDITIN=Yes
PIN=Yes
CONNWARN=Yes
CROSS=No
GRID=Yes
BORDER=Yes
BORDERONE=Yes
TITLE=Yes
RUBBER=Yes
PROPERTY=Yes
STEP=Yes
MIRROR=Yes
ROTATE=Yes
FLIPY=Yes
FLIPX=Yes
CIR_MAKEMACRO=No
CLEARCUTWIRE=No
CLIPBOARDCIRPAGE2BMM=No
FINDCOMP=Yes
FIND=Yes
REPEAT=No
REPLACE=No
MODEL=Yes
CIR2CKT=No
ATTDISP=No
ENABLE=Yes
DISABLE=Yes
ENABLE_WITH=Yes
TOFRONT=Yes
TOBACK=Yes
SELNEXT=No
PAGEADD=No
PAGEADDTEXT=No
ADDSECTION=No
PAGEDEL=No
ZOOMIN=Yes
ZOOMOUT=Yes
AUTOSCALECIR=Yes
GOTOFLAG=No
UPLEVEL=Yes
COLOR=Yes
FONT=Yes
STYLE=Yes
DM_LAST=No
DM_RMS=No
DM_AVG=No
DM_PEAK=No
GRID_NONE=No
GRID_NORMAL=No
GRID_BOLD_5=No
GRID_BOLD_6=No
GRID_BOLD_USER=No
GRAPH_PAPER=No
SPLITCIRTEXTH=No
SPLITCIRTEXTV=No
SPACE_SPLITTERS_EVENLY=No
NORMALCIR=No
RENAMEDEFINE=No
RENAMECMP=No
ATTALIGN=No
RESETNODEPOS=No
FIT2STANDARD=No
NODESNAP=No
MOVETEXT=No
TEXTINC=No
TOGGLETEXT=No
TOGGLEMODE=No
TOLERANCE=No
ALIGNAB=No
ALIGNLEFT=No
ALIGNCENTER=No
ALIGNRIGHT=No
ALIGNTOP=No
ALIGNMIDDLES=No
ALIGNBOTTOM=No

[Section]
Index=0
Name="усилок_v4_с Ару"
Type=Main
Enable=True
CurrentPage 0=3
CurrentPage 1=3
CurrentPage 2=3
CurrentPage 3=3
TabSize 0=425
TabSize 1=425
TabSize 2=425
TabSize 3=425

[Page]
Index=0
Section=0
Type=Text
Print=False
Enable=True
Name=Text
Font=Height=-15,FStyle=0,Color=#000000,Name=Courier New
Comment Color=#008000
WinBackGround Color=#FFFFFF
Disabled	Color=#C0C0C0
KeyWord Color=#0000FF
Error	Color=#FF0000
Search Color=#FFFF00

[Page]
Index=1
Section=0
Type=Text
Print=False
Enable=True
Name=Models
SB 0=32,5
Font=Height=-15,FStyle=0,Color=#000000,Name=Courier New
Comment Color=#008000
WinBackGround Color=#FFFFFF
Disabled	Color=#C0C0C0
KeyWord Color=#0000FF
Error	Color=#FF0000
Search Color=#FFFF00

[Page]
Index=2
Section=0
Type=Info
Print=False
Enable=True
Name=Info
Font=Height=-15,FStyle=0,Color=#000000,Name=Courier New
Comment Color=#008000
WinBackGround Color=#FFFFFF
Disabled	Color=#C0C0C0
KeyWord Color=#0000FF
Error	Color=#FF0000
Search Color=#FFFF00

[Page]
Index=3
Section=0
Print=True
Enable=True
Name=Main
PrinterScale=1
Scale 0=1
Scale 1=1
Scale 2=1
SB 3=383,0
Scale 3=1
Px=612,72
WinBackGround Color=#FFFFFF
Select Color=#FF0000
Anchor Color=#000000
Select Box Color=#000080
Grid Text Color=Height=-12,FStyle=0,Color=#0000FF,Name=Verdana
Grid Text RTF=False
Grid Text Angle=0
Grid Text GridSnap=True
Grid Text PinIt=False
Grid Text JustifyH=Left
Grid Text JustifyV=Bottom
Grid GradientColor2=None
Grid OutlineThickness=1
Grid OutlineColor=None
Component Color=#0000FF
Attribute Text=Height=-12,FStyle=0,Color=#008000,Name=Verdana
Wire Color=#008000
Bus Color=#008000
Pin Connection=Height=-10,FStyle=0,Color=#FF0000,Name=Arial
Pin Marker Color=#008000
Node Number=Height=-11,FStyle=0,Color=#FF00FF,Name=Arial
Node Voltage Color=Height=-11,FStyle=0,Color=#000000,Name=Arial
Dynamic AC Voltage Color=#E4E4E4
Text Banner Text=Height=-15,FStyle=0,Color=#800000,Name=Arial
Title Block Background=#C0C0C0
Current=Height=-11,FStyle=0,Color=#0000FF,Name=Arial
Power/Condition=Height=-11,FStyle=0,Color=#FF0000,Name=Arial
Digital Path Color=#FF0000
Title Block Border=#000000
Disabled	Color=#C0C0C0
Search Color=#FFFF00
Grid Color=#000000
Graph Paper=#E4E4E4
Digital 0 Color=#000000
Digital R Color=#FFFF00
Digital F Color=#FFFF00
Digital 1 Color=#FF0000
Digital X Color=#C0C0C0
Digital Z Color=#808080
Block Select Color=#51F998

[Text Area]
Section=0
Page=0
Text=.MODEL BFR193F NPN (BF=114 BR=11.16 CJC=6.473E-013 CJE=2.049E-012 FC=0.9999
Text=+ IKF=0.4814 IKR=0.07071 IRB=0.0001166 IS=4.981E-016 ISC=2.254E-014
Text=+ ISE=3.125E-015 ITF=0.6292 MJC=0.3598 MJE=0.372 NC=1.894 NE=1.723 NR=0.9901
Text=+ PTF=1E-015 RB=1.22358 RBM=0.85 RC=1.377 RE=0.493289 TF=1.552E-011
Text=+ TR=5.53E-009 VAF=56.06 VAR=3.941 VJC=0.5728 VJE=0.8885 VJS=0.1 VTF=3.177
Text=+ XTB=1.303 XTF=33.9 XTI=6.548)

[Text Area]
Section=0
Page=1
Text=*** From file D:\Program Files\mc12cd\library\UTILITY.LBR
Text=*** 0 Phase Leg
Text=.MODEL 3PHASEA SIN (A=169.7 F=60)
Text=*** From file D:\Program Files\mc12cd\library\UTILITY.LBR
Text=*** 1MHz Sinusoidal Source
Text=.MODEL 1MHZ SIN (A=300u F=10MEG)
Text=*** From file D:\Program Files\mc12cd\library\PH_BJT.LIB
Text=.MODEL PMBT2222A NPN (BF=256.7 BR=6.590 CJC=10.11E-12 CJE=25.89E-12 CJS=0.000
Text=+ EG=1.110 FC=938.8E-3 IKF=489.9E-3 IKR=192.9E-3 IRB=1.000E-3 IS=29.13E-15
Text=+ ISC=320.3E-12 ISE=9.652E-15 ITF=4.797 MJC=416.0E-3 MJE=366.8E-3 MJS=333.0E-3
Text=+ NC=1.608 NE=1.516 NF=992.6E-3 NR=984.4E-3 PTF=0.000 RB=1.000 RBM=1.000
Text=+ RC=224.8E-3 RE=193.4E-3 TF=293.9E-12 TR=320.0E-9 VAF=80.99 VAR=101.2
Text=+ VJC=662.2E-3 VJE=689.1E-3 VJS=750.0E-3 VTF=20.00 XCJC=0.5946 XTB=0.000
Text=+ XTF=71.78 XTI=3.000)
Text=*** From file D:\Program Files\mc12cd\library\PH_BJT.LIB
Text=.MODEL PMBT3904 NPN (BF=160.1 BR=5.944 CJC=4.949E-12 CJE=5.631E-12 FC=0.5582
Text=+ IKF=0.12 IKR=0.06 IRB=1E-06 IS=4.639E-15 ISC=3.257E-12 ISE=2.091E-14
Text=+ ITF=0.2723 MJC=0.1928 MJE=0.3385 MJS=0.333 NC=1.394 NE=1.6 NF=0.9995 NR=1.001
Text=+ RB=1 RBM=1 RC=1.755 RE=0.3614 TF=3.001E-10 TR=9.4E-8 VAF=98.69 VAR=19.29
Text=+ VJC=0.5969 VJE=0.7002 VJS=0.75 VTF=1.461 XCJC=0.864 XTF=27)
Text=*** From file D:\Program Files\mc12cd\library\PH_BJT.LIB
Text=.MODEL PMBT3904D NPN (BF=160.1 BR=5.944 CJC=4.949E-12 CJE=5.631E-12 FC=0.5582
Text=+ IKF=0.12 IKR=0.06 IRB=1E-06 IS=4.639E-15 ISC=3.257E-12 ISE=2.091E-14
Text=+ ITF=0.2723 MJC=0.1928 MJE=0.3385 MJS=0.333 NC=1.394 NE=1.6 NF=0.9995 NR=1.001
Text=+ RB=1 RBM=1 RC=1.755 RE=0.3614 TF=3.001E-10 TR=9.4E-8 VAF=98.69 VAR=19.29
Text=+ VJC=0.5969 VJE=0.7002 VJS=0.75 VTF=1.461 XCJC=0.864 XTF=27)
Text=*** From file D:\Program Files\mc12cd\library\PH_BJT.LIB
Text=.MODEL PMBT5551 NPN (BF=144.7 BR=2.994 CJC=6.422E-12 CJE=2.716E-11 FC=0.8953
Text=+ IKF=0.545 IKR=0.2 IRB=0.0002 IS=1.663E-14 ISC=4E-12 ISE=2.072E-15 ITF=0.3
Text=+ MJC=0.4077 MJE=0.3438 MJS=0.333 NC=1.4 NE=1.311 NF=0.9956 NR=0.985 RB=20
Text=+ RBM=6 RC=0.76 RE=0.3345 TF=1.026E-09 TR=3.28E-07 VAF=440.1 VAR=30 VJC=0.4281
Text=+ VJE=0.6743 VJS=0.75 VTF=5 XCJC=0.595 XTF=15)
Text=*** From file D:\Program Files\mc12cd\library\PH_BJT.LIB
Text=.MODEL PMST2222A NPN (BF=256.7 BR=6.590 CJC=10.11E-12 CJE=25.89E-12 CJS=0.000
Text=+ EG=1.110 FC=938.8E-3 IKF=489.9E-3 IKR=192.9E-3 IRB=1.000E-3 IS=29.13E-15
Text=+ ISC=320.3E-12 ISE=9.652E-15 ITF=4.797 MJC=416.0E-3 MJE=366.8E-3 MJS=333.0E-3
Text=+ NC=1.608 NE=1.516 NF=992.6E-3 NR=984.4E-3 PTF=0.000 RB=1.000 RBM=1.000
Text=+ RC=224.8E-3 RE=193.4E-3 TF=293.9E-12 TR=320.0E-9 VAF=80.99 VAR=101.2
Text=+ VJC=662.2E-3 VJE=689.1E-3 VJS=750.0E-3 VTF=20.00 XCJC=0.5946 XTB=0.000
Text=+ XTF=71.78 XTI=3.000)
Text=*** From file D:\Program Files\mc12cd\library\ON_SEMI.LIB
Text=.MODEL Q2N2102 NPN (BF=79.3546 BR=3.76239 CJC=1.3035E-11 CJE=1E-11 EG=1.05
Text=+ FC=0.5 IKF=0.640083 IKR=2.76346 IRB=0.1 IS=1.1791E-10 ISC=3.24999E-13
Text=+ ISE=7.91563E-12 ITF=0.01 MJC=0.23 MJE=0.33 MJS=0.5 NC=3.96875 NE=3.31476
Text=+ NF=1.42901 NR=1.5 RB=0.1 RBM=0.1 RC=0.38569 RE=0.00431604 TF=1E-09 TR=1E-07
Text=+ VAF=30.134 VAR=3.69384 VJC=0.62509 VJE=0.75 VJS=0.75 VTF=10 XCJC=0.9 XTB=0.1
Text=+ XTF=1 XTI=1)
Text=*** From file D:\Program Files\mc12cd\library\ON_SEMI.LIB
Text=.MODEL Q2N3055 NPN (BF=129.119 BR=1.01252 CJC=5E-10 CJE=9.03089E-08 EG=1.206
Text=+ FC=0.661216 IKF=0.990922 IKR=2.70227 IRB=0.1 IS=2.37426E-14 ISC=2.47498E-10
Text=+ ISE=2.47498E-10 ITF=0.987296 MJC=0.410238 MJE=0.59999 MJS=0.5 NC=2.90624
Text=+ NE=1.89002 NF=0.85 NR=0.924456 RB=3.66609 RBM=0.1 RC=0.0764459 RE=0.000352673
Text=+ TF=1E-08 TR=1E-07 VAF=31.1252 VAR=254.624 VJC=0.400243 VJE=0.513954 VJS=0.75
Text=+ VTF=1.02605 XCJC=0.803124 XTB=1.34801 XTF=1.36696 XTI=1.07207)
Text=*** From file D:\Program Files\mc12cd\library\ON_SEMI.LIB
Text=.MODEL Q2N5657 NPN (BF=46.1881 BR=4.46937 CJC=4.74919E-11 CJE=2.13868E-10
Text=+ EG=1.206 FC=0.8 IKF=6.79554 IKR=3.17468 IRB=0.1 IS=2.60089E-13
Text=+ ISC=1.74986E-13 ISE=7.20462E-12 ITF=0.226713 MJC=0.361447 MJE=0.391421
Text=+ MJS=0.5 NC=3.90625 NE=3.28966 NF=0.9868 NR=0.866274 RB=10.927 RBM=0.1
Text=+ RC=2.43986 RE=0.0141049 TF=1.01847E-08 TR=9.5407E-06 VAF=61.921 VAR=7.19873
Text=+ VJC=0.95 VJE=0.99 VJS=0.75 VTF=3.60195 XCJC=0.789467 XTB=0.136699 XTF=1.77369
Text=+ XTI=1.1199)
Text=*** From file D:\Program Files\mc12cd\library\ON_SEMI.LIB
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
Text=*** From file D:\Program Files\mc12cd\library\ON_SEMI.LIB
Text=.MODEL QMJE13009 NPN (BF=22.7911 BR=2.27911 CJC=5E-10 CJE=4.50839E-09
Text=+ EG=1.12482 FC=0.8 IKF=5.53474 IKR=8.44426 IRB=0.1 IS=5.36792E-12
Text=+ ISC=8.27274E-13 ISE=8.27274E-13 ITF=0.001 MJC=0.457977 MJE=0.23 MJS=0.5
Text=+ NC=3.65698 NE=3.68432 NF=0.85 NR=0.75 RB=0.938365 RBM=0.1 RC=0.0350521
Text=+ RE=0.0001 TF=1E-08 TR=1.76449E-06 VAF=10 VAR=4.68261 VJC=0.95 VJE=0.4
Text=+ VJS=0.75 VTF=6.06314 XCJC=0.799439 XTB=0.114306 XTF=2.77017 XTI=1)
Text=*** From file D:\Program Files\mc12cd\library\ON_SEMI.LIB
Text=.MODEL QMJE18004 NPN (BF=28.9081 BR=2.8908 CJC=1.81952E-10 CJE=2.59175E-09
Text=+ EG=1.10976 FC=0.8 IKF=5.56749 IKR=2.47573 IRB=0.100033 IS=1E-17
Text=+ ISC=4.31878E-13 ISE=5.41307E-12 ITF=620.447 MJC=0.536669 MJE=0.345984 MJS=0.5
Text=+ NC=3.99474 NE=3.42903 NF=0.85 NR=0.782418 RB=1.01858 RBM=0.100017 RC=0.193973
Text=+ RE=0.000655569 TF=1E-08 TR=1.29051E-07 VAF=30.1386 VAR=3.18374 VJC=0.8
Text=+ VJE=0.4 VJS=0.75 VTF=0.1 XCJC=0.1 XTB=0.119644 XTF=0.05 XTI=1.00078)
Text=*** From file D:\Program Files\mc12cd\library\ON_SEMI.LIB
Text=.MODEL QMJF2955 NPN (BF=327.43 BR=0.654697 CJC=5E-10 CJE=9.23675E-08 EG=1.05
Text=+ FC=0.658133 IKF=0.620037 IKR=6.20037 IRB=0.1 IS=1.92238E-13 ISC=6.85154E-12
Text=+ ISE=1.4602E-10 ITF=0.999796 MJC=0.410184 MJE=0.607139 MJS=0.5 NC=2.96871
Text=+ NE=1.50926 NF=0.85 NR=0.935367 RB=16.05 RBM=0.161446 RC=0.0632768
Text=+ RE=0.000602331 TF=1E-08 TR=1E-07 VAF=36.105 VAR=361.05 VJC=0.400198
Text=+ VJE=0.506151 VJS=0.75 VTF=0.997047 XCJC=0.803125 XTB=0.943656 XTF=1.35736
Text=+ XTI=1.12302)
Text=*** From file D:\Program Files\mc12cd\library\ZETEX.LIB
Text=.MODEL ZXTN25100DZ NPN (BF=550 BR=35 CJC=28E-12 CJE=182E-12 GAMMA=8.3E-8 IKF=4
Text=+ IKR=1 IS=6E-13 ISC=5E-13 ISE=1.3E-13 MJC=0.3 MJE=0.39 NC=1.18 NE=1.42
Text=+ QUASIMOD=1 RB=0.2 RC=0.0016 RCO=7 RE=0.0013 TF=7.5E-10 TR=5.3E-8 TRB1=.005
Text=+ TRC1=.005 TRE1=.005 VAF=117 VAR=36 VJC=0.4 VJE=0.78 XTB=1.4)
Text=*** From file D:\Program Files\mc12cd\library\ZETEX.LIB
Text=.MODEL ZXTN25100DFH NPN (BF=550 BR=35 CJC=28E-12 CJE=182E-12 GAMMA=8.3E-8 IKF=4
Text=+ IKR=1 IS=6E-13 ISC=5E-13 ISE=1.3E-13 MJC=0.3 MJE=0.39 NC=1.18 NE=1.42
Text=+ QUASIMOD=1 RB=0.2 RC=0.0016 RCO=7 RE=0.0013 TF=7.5E-10 TR=5.3E-8 TRB1=.005
Text=+ TRC1=.005 TRE1=.005 VAF=117 VAR=36 VJC=0.4 VJE=0.78 XTB=1.4)
Text=*** From file D:\Program Files\mc12cd\library\ZETEX.LIB
Text=.MODEL ZXTN25060BZ NPN (BF=315 BR=12 CJC=34E-12 CJE=222E-12 GAMMA=16E-9 IKF=4.0
Text=+ IKR=0.5 IS=2E-13 ISC=4.2E-13 ISE=1.2E-13 MJC=0.34 MJE=0.35 NC=1.33 NE=1.3
Text=+ QUASIMOD=1 RB=0.25 RC=.005 RCO=1.9 RE=.005 TF=7.4E-10 TR=7.6E-8 TRB1=.004
Text=+ TRC1=.004 TRE1=.004 VAF=210 VAR=27 VJC=0.46 VJE=0.73 XTB=1.4)
Text=*** From file D:\Program Files\mc12cd\library\DIODESINC_BJT.LIB
Text=.MODEL 2DC4672 NPN (BF=230 BR=56 CJC=51E-12 CJE=318E-12 IKF=2 IKR=1
Text=+ IS=2.218E-13 ISC=2.971E-13 ISE=2.9E-14 MJC=.42 NC=1.321 NE=1.35 NF=.9956
Text=+ NR=.995 RB=.04 RC=.069 RE=.075 TF=.77E-9 TR=27E-9 VAF=100 VAR=30 VJC=.595)
Text=*** From file D:\Program Files\mc12cd\library\DIODESINC_BJT.LIB
Text=.MODEL 2DC2412R NPN (BF=524 BR=4.00 CJC=7.34P CJE=22.7P EG=1.12 IKF=54.7M
Text=+ IKR=0.135 IS=15.5F ISE=3.90P MJC=0.300 MJE=0.500 NE=2.00 NF=1.00 NR=1.00
Text=+ RB=1.16 RC=0.116 RE=0.290 TF=698P TR=121N VAF=127 VAR=28.0 VJC=0.300 VJE=1.10
Text=+ XTB=1.5)
Text=*** From file D:\Program Files\mc12cd\library\DIODESINC_BJT.LIB
Text=.MODEL 2DD2652 NPN (BF=550 BR=280 CJC=34.2E-12 CJE=103.5E-12 IKF=2.25 IKR=0.9
Text=+ IS=2.66E-13 ISC=2.76E-13 ISE=5.7E-14 MJC=0.298 MJE=0.357 NC=1.46 NE=1.425
Text=+ RB=0.22 RC=0.038 RE=0.055 TF=1.12E-9 TR=2.15E-9 VAF=34.6 VAR=12.25 VJC=0.441
Text=+ VJE=0.7042)
Text=*** From file D:\Program Files\mc12cd\library\MSBJT.LBR
Text=*** NPN General purpose transistor
Text=.MODEL 2N915 NPN (BF=139.213 BR=1m CJC=3.5p CJE=2p FC=501.9m IKF=808.43m
Text=+ IKR=10m IS=10.1652f ISC=100p ISE=992.595f ITF=10m MJC=501.9m MJE=500m
Text=+ NE=2.10611 NF=1.23211 RC=2 RE=1.99985 TF=1n TR=10n VAF=100 VJC=700m VTF=10
Text=+ XTF=500m)
Text=*** From file D:\Program Files\mc12cd\library\MSBJT.LBR
Text=*** NPN Amplifier transistor
Text=.MODEL 2N918 NPN (BF=199.631 BR=219.479m CJC=7.78681p CJE=2.82826p IKF=1.00006
Text=+ IKR=995.4m IS=9.65895f ISC=3.55928p ISE=807.101f ITF=9.88227m MJC=558.067m
Text=+ MJE=642.887m NE=2 NF=1.3696 RC=500m RE=1.99896 TF=158.837p TR=10n VAF=100
Text=+ VJC=700m VJE=700m VTF=10 XTF=500.003m)
Text=*** From file D:\Program Files\mc12cd\library\MSBJT.LBR
Text=*** NPN Amplifier transistor
Text=.MODEL 2N930A NPN (BF=316.518 BR=6.51708m CJC=19.8997p CJE=2p IKF=10K
Text=+ IKR=478.625 IS=10.1652f ISC=.00502062f ISE=418.098f ITF=9.81926m MJC=571.783m
Text=+ MJE=500m NE=2.36712 NF=1.23211 RC=1.84317 RE=1.99985 TF=2.97408n TR=10n
Text=+ VAF=100 VJC=700.228m VTF=10 XTF=499.972m)
Text=*** From file D:\Program Files\mc12cd\library\MSBJT.LBR
Text=*** NPN General purpose transistor
Text=.MODEL 2N910 NPN (BF=166.182 BR=1m CJC=68.7063p CJE=120.201p IKF=395.236m
Text=+ IKR=10m IS=9.98962f ISC=100p ISE=991.476f ITF=9.33493m MJC=558.063m
Text=+ MJE=642.887m NE=1.92822 NF=1.10043 RC=2 RE=1.35482 TF=1.95793n TR=10n VAF=100
Text=+ VJC=700m VJE=700m VTF=10 XTF=500.007m)
Text=*** From file D:\Program Files\mc12cd\library\MSBJT.LBR
Text=*** NPN General purpose transistor
Text=.MODEL 2N916 NPN (BF=146.036 BR=1m CJC=19.8997p CJE=14.1412p IKF=867.28m
Text=+ IKR=10m IS=10.1652f ISC=100p ISE=993.687f ITF=10m MJC=571.783m MJE=642.878m
Text=+ NE=2.10134 NF=1.23211 RC=2 RE=1.99985 TF=1n TR=10n VAF=100 VJC=700.228m
Text=+ VJE=700m VTF=10 XTF=500m)
Text=*** From file D:\Program Files\mc12cd\library\MSBJT.LBR
Text=*** NPN Amplifier transistor
Text=.MODEL 2N930 NPN (BF=316.518 BR=6.51708m CJC=26.533p CJE=2p IKF=10K IKR=478.625
Text=+ IS=10.1652f ISC=.00502062f ISE=418.098f ITF=11.6236m MJC=571.784m MJE=500m
Text=+ NE=2.36712 NF=1.23211 RC=1.84317 RE=1.99985 TF=4.64885n TR=10n VAF=100
Text=+ VJC=700.227m VTF=10 XTF=500.104m)
Text=*** From file D:\Program Files\mc12cd\library\MPBJT.LIB
Text=.MODEL 2N3054A NPN (BF=153.47597185664 BR=20.074543923541M
Text=+ CJC=155.090027333211P CJE=263.770948388189P FC=500.000000689595M
Text=+ IKF=607.618021810564M IKR=996.576438476171 IS=9.515713199252F
Text=+ ISC=98.555827968388P ISE=926.908248229621F ITF=11.269234820254M
Text=+ MJC=300.000000042459M MJE=456.861753457561M NC=2.000000003546
Text=+ NE=1.237073149436 NF=839.313185444086M RE=170.212781532508M
Text=+ TF=42.071825791901N TR=95.78145725923U VAF=100 VJC=700.000000011081M
Text=+ VJE=951.9599378471M VTF=10.000000025208 XTF=499.99979770608M)
Text=*** From file D:\Program Files\mc12cd\library\MPBJT.LIB
Text=.MODEL 2N3054 NPN (BF=153.47597185664 BR=20.074543923541M CJC=155.090027333211P
Text=+ CJE=263.770948388189P FC=500.000000689595M IKF=607.618021810564M
Text=+ IKR=996.576438476171 IS=9.515713199252F ISC=98.555827968388P
Text=+ ISE=926.908248229621F ITF=11.269234820254M MJC=300.000000042459M
Text=+ MJE=456.861753457561M NC=2.000000003546 NE=1.237073149436
Text=+ NF=839.313185444086M RE=170.212781532508M TF=42.071825791901N
Text=+ TR=95.78145725923U VAF=100 VJC=700.000000011081M VJE=951.9599378471M
Text=+ VTF=10.000000025208 XTF=499.99979770608M)
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
