BYakov/Rx-Tx_module/Аналоговая часть/Фильтры/Diff_L_C_S_42000000_50000000.cir

[Main]
FileType=CIR
Version=12.00
Program=Micro-Cap
Component Version=10.00
Shape Version=11.00
Screen=1920,1080
MCAPVersion=12.2.0.0
Key ID=Demo
NLCnt=51
TXCnt=6

[shapedef]
Name=Capacitor
Line=0,0,22,0
Line=22,-8,22,8
Line=26,-8,26,8
Line=26,0,48,0
Current=32,12,16,12

[shapedef]
Name=Ground
Line=0,0,12,0
Line=12,-8,12,8
Line=18,-4,18,4
Line=24,0,24,0

[shapedef]
Name=Inductor
Line=42,0,48,0
Line=0,0,5,0
Arc=5,-7,17,7 , 11,-7,5,0
Arc=13,-7,25,7 , 19,-7,13,0
Arc=29,-7,41,7 , 35,-7,29,0
Arc=21,-7,33,7 , 27,-7,21,0
Arc=6,-7,18,7 , 18,0,12,-7
Arc=14,-7,26,7 , 26,0,20,-7
Arc=22,-7,34,7 , 34,0,28,-7
Arc=30,-7,42,7 , 42,0,36,-7
Line=11,-7,12,-7
Line=19,-7,20,-7
Line=27,-7,28,-7
Line=35,-7,36,-7
Arc=13,-4,17,2 , 13,-1,15,2
Arc=29,-4,33,2 , 29,-1,31,2
Arc=21,-4,25,2 , 21,-1,23,2
Arc=14,-4,18,2 , 16,2,18,-1
Arc=30,-4,34,2 , 32,2,34,-1
Arc=22,-4,26,2 , 24,2,26,-1
Line=15,2,16,2
Line=23,2,24,2
Line=31,2,32,2
Line=5,5,9,5
Line=41,5,41,9
Line=39,7,43,7
Current=32,8,16,8

[shapedef]
Name=Plus.root
Line=-2,0,2,0
Line=0,-2,0,2

[shapedef]
Name=Resistor
PolyOpen=12
PolyLine=0,0
PolyLine=0,0
PolyLine=12,0
PolyLine=14,-4
PolyLine=18,4
PolyLine=22,-4
PolyLine=26,4
PolyLine=30,-4
PolyLine=34,4
PolyLine=36,0
PolyLine=48,0
PolyLine=48,0
Current=32,8,16,8

[shapedef]
Name=SPICE_V
Root="Vsource.root",0,0,0

[shapedef]
Name=Vsource.root
Line=0,0,12,0
Line=36,0,48,0
Ellipse=12,-12,36,12
FColor=None
Line=7,5,7,9
Root="Plus.root",41,7,0
Current=32,16,16,16

[compdef]
Name=Inductor
Definition=Inductor
Shape=Inductor
Mask=7681
Used=37
memo=Inductor
Label Offset=18,9,11,12
PinCnt=2
Pin="Plus",6,0,-5,-9
Pin="Minus",0,0,-3,-9

[compdef]
Name=Capacitor
Definition=Capacitor
Shape=Capacitor
Mask=7425
Used=35
memo=Capacitor
Label Offset=16,12,12,12
PinCnt=2
Pin="Plus",6,0,-3,-5
Pin="Minus",0,0,-14,-5

[compdef]
Name=Resistor
Definition=Resistor
Shape=Resistor
Mask=6913
Used=186
memo=Resistor
Label Offset=18,6,8,11
PinCnt=2
Pin="Plus",6,0,-10,-4
Pin="Minus",0,0,-14,-4

[compdef]
Name=Voltage Source
Definition=VSpice
Shape=SPICE_V
Mask=4865
Used=45
memo=Voltage Source
Label Offset=19,13,15,13
PinCnt=2
Pin="Plus",6,0,-5,-6
Pin="Minus",0,0,-20,-6

[compdef]
Name=Ground
Definition=Ground
Shape=Ground
Mask=1793
Used=267
memo=Ground
Label Offset=0,0,0,0
PinCnt=1
Pin="PinA",0,0,-3,-7

[Circuit]
Window Placement=2,3, -1,-1, -8,-31, 0,0,1206,511
Default Object=Color=#000080
Default Object Font=Height=-23,FStyle=0,Color=#000080,Name=Arial
Default Object Apply Border To Text=No
Default Object Apply Fill To Text=No
Default Object GridSnap=No
NodeVoltageFormat=3
CurrentFormat=3
PowerFormat=3
PathDelayFormat=3
WarningFormat=3
GridTextFormulaFormat=3
Window Placement in AC Analysis=0,1, -1,-1, -8,-31, 953,0,1906,770
SpiceType=AMBIGUOUS
Title_Block_Border=None
Title_Block=False
Show Nodes=False
Show Voltages=False
Show Current=False
Show Power=False
Show Condition=False
Show Pin Connections=False
Show Connection Warnings=False
Show Cross=False
Show Attribute Text=True
Show Grid Text=True

[Comp]
Name=Inductor
Px=488,192
Rot=6

[Attr]
ON=-27,-31,PART
V=L1
Style=8192

[Attr]
ON=-34,10,INDUCTANCE
V=120n
Style=8192

[Attr]
ON=0,56,MODEL
V=IM1

[Attr]
ON=0,98,PACKAGE
V

[Comp]
Name=Capacitor
Px=400,264
Rot=3

[Attr]
ON=15,-43,PART
V=C1
Style=8192

[Attr]
ON=9,-25,CAPACITANCE
V=130p
Style=8192

[Attr]
ON=0,56,MODEL
V=CM1

[Attr]
ON=0,98,PACKAGE
V

[Wire]
Pxs=368,192,400,192

[Wire]
Pxs=400,192,400,216

[Wire]
Pxs=400,192,440,192

[Wire]
Pxs=488,192,560,192

[Comp]
Name=Inductor
Px=648,192
Rot=6

[Attr]
ON=-27,-31,PART
V=L2
Style=8192

[Attr]
ON=-34,10,INDUCTANCE
V=130n
Style=8192

[Attr]
ON=0,56,MODEL
V=IM1

[Attr]
ON=0,98,PACKAGE
V

[Comp]
Name=Capacitor
Px=560,264
Rot=3

[Attr]
ON=15,-43,PART
V=C2
Style=8192

[Attr]
ON=9,-25,CAPACITANCE
V=200p
Style=8192

[Attr]
ON=0,56,MODEL
V=CM1

[Attr]
ON=0,98,PACKAGE
V

[Wire]
Pxs=560,192,560,216

[Wire]
Pxs=560,192,600,192

[Wire]
Pxs=648,192,720,192

[Comp]
Name=Inductor
Px=808,192
Rot=6

[Attr]
ON=-27,-31,PART
V=L3
Style=8192

[Attr]
ON=-34,10,INDUCTANCE
V=130n
Style=8192

[Attr]
ON=0,56,MODEL
V=IM1

[Attr]
ON=0,98,PACKAGE
V

[Comp]
Name=Capacitor
Px=720,264
Rot=3

[Attr]
ON=15,-43,PART
V=C3
Style=8192

[Attr]
ON=9,-25,CAPACITANCE
V=200p
Style=8192

[Attr]
ON=0,56,MODEL
V=CM1

[Attr]
ON=0,98,PACKAGE
V

[Wire]
Pxs=720,192,720,216

[Wire]
Pxs=720,192,760,192

[Wire]
Pxs=808,192,880,192

[Comp]
Name=Inductor
Px=968,192
Rot=6

[Attr]
ON=-27,-31,PART
V=L4
Style=8192

[Attr]
ON=-34,10,INDUCTANCE
V=120n
Style=8192

[Attr]
ON=0,56,MODEL
V=IM1

[Attr]
ON=0,98,PACKAGE
V

[Comp]
Name=Capacitor
Px=880,264
Rot=3

[Attr]
ON=15,-43,PART
V=C4
Style=8192

[Attr]
ON=9,-25,CAPACITANCE
V=200p
Style=8192

[Attr]
ON=0,56,MODEL
V=CM1

[Attr]
ON=0,98,PACKAGE
V

[Wire]
Pxs=880,192,880,216

[Wire]
Pxs=880,192,920,192

[Wire]
Pxs=968,192,1048,192

[Comp]
Name=Resistor
Px=320,192

[Attr]
ON=18,6,PART
V=RS
Style=8192

[Attr]
ON=18,31,RESISTANCE
V=50
Style=8192

[Attr]
ON=0,0,MODEL
V=RM1

[Attr]
ON=0,0,PACKAGE
V

[Comp]
Name=Capacitor
Px=1048,264
Rot=3

[Attr]
ON=15,-43,PART
V=C5
Style=8192

[Attr]
ON=8,2,CAPACITANCE
V=130p
Style=8192

[Attr]
ON=0,56,MODEL
V=CM1

[Attr]
ON=0,98,PACKAGE
V

[Wire]
Pxs=1048,192,1048,216

[Wire]
Pxs=1048,192,1080,192

[Comp]
Name=Resistor
Px=1080,192
Rot=1

[Attr]
ON=8,11,PART
V=RL
Style=8192

[Attr]
ON=9,36,RESISTANCE
V=50
Style=8192

[Attr]
ON=0,0,MODEL
V=RM1

[Attr]
ON=0,0,PACKAGE
V

[Comp]
Name=Inductor
Px=488,304
Rot=6

[Attr]
ON=-27,-31,PART
V=L5
Style=8192

[Attr]
ON=-34,10,INDUCTANCE
V=120n
Style=8192

[Attr]
ON=0,56,MODEL
V=IM1

[Attr]
ON=0,98,PACKAGE
V

[Comp]
Name=Inductor
Px=640,304
Rot=6

[Attr]
ON=-27,-31,PART
V=L6
Style=8192

[Attr]
ON=-34,10,INDUCTANCE
V=130n
Style=8192

[Attr]
ON=0,56,MODEL
V=IM1

[Attr]
ON=0,98,PACKAGE
V

[Comp]
Name=Inductor
Px=808,296
Rot=6

[Attr]
ON=-27,-31,PART
V=L7
Style=8192

[Attr]
ON=-34,10,INDUCTANCE
V=130n
Style=8192

[Attr]
ON=0,56,MODEL
V=IM1

[Attr]
ON=0,98,PACKAGE
V

[Comp]
Name=Inductor
Px=968,296
Rot=6

[Attr]
ON=-27,-31,PART
V=L8
Style=8192

[Attr]
ON=-34,10,INDUCTANCE
V=120n
Style=8192

[Attr]
ON=0,56,MODEL
V=IM1

[Attr]
ON=0,98,PACKAGE
V

[Wire]
Pxs=400,264,400,304

[Wire]
Pxs=400,304,440,304

[Wire]
Pxs=488,304,560,304

[Wire]
Pxs=640,304,720,304

[Wire]
Pxs=760,296,760,304

[Wire]
Pxs=808,296,880,296

[Wire]
Pxs=968,296,1048,296

[Wire]
Pxs=1048,264,1048,296

[Wire]
Pxs=1048,296,1080,296

[Wire]
Pxs=1080,240,1080,296

[Wire]
Pxs=560,264,560,304

[Wire]
Pxs=560,304,592,304

[Wire]
Pxs=720,264,720,304

[Wire]
Pxs=720,304,760,304

[Wire]
Pxs=880,264,880,296

[Wire]
Pxs=880,296,920,296

[Wire]
Pxs=320,304,336,304

[Comp]
Name=Voltage Source
Px=320,240
Rot=3

[Attr]
ON=-42,-38,PART
V=V1
Style=8192

[Attr]
ON=-320,-63,VALUE
V=DC 0 AC 1 0

[Attr]
ON=0,0,PACKAGE
V

[Attr]
ON=0,0,SMOOTHING
V=N
Style=256

[Attr]
ON=0,0,Saved_PulseS
V=N
Style=256

[Attr]
ON=0,0,FRACTION
V=.2
Style=256

[Attr]
ON=0,0,Saved_PulseF
V=.2
Style=256

[Attr]
ON=0,0,Saved_Pulse
V=DC 0 AC 1 0 Pulse 0 5 100n 10n 10n 400n 1u
Style=256

[Attr]
ON=0,11,Saved_None
V=DC 0 AC 1 0
Style=256

[Comp]
Name=Ground
Px=336,304
Rot=7

[Wire]
Pxs=320,240,320,304

[Wire]
Pxs=336,304,400,304

[Grid Text]
Text="In"
Px=320,192
GridSnap=True
JustifyH=Left
JustifyV=Bottom
CBorder=None

[Grid Text]
Text="Low-Pass Chebyshev Standard"
Text="Passband Gain = 0 dB  Passband Ripple (R) = 0.5 dB  Passband Frequency (Fc) = 4.2e+007Hz "
Text="Stopband Attenuation (A) = 30 dB  Stopband Frequency (Fs) = 5e+007 Hz"
Text="Impedance Scale Factor=1"
Px=160,108
GridSnap=False
JustifyH=Left
JustifyV=Bottom
CFill=#C0C0C0
CBorder=#000000

[Grid Text]
Text="LP = Ideal low-pass response based upon choice of filter type and response. "
Px=302,399
GridSnap=False
JustifyH=Left
JustifyV=Bottom
CBorder=None

[Grid Text]
Text=".define U (S/(2*PI*4.2E+007))"
Px=302,440
GridSnap=False
JustifyH=Left
JustifyV=Bottom
CBorder=None

[Grid Text]
Text=".define LP "
Text="1.0092/(U*U+0.068905*U+1.0092)*"
Text="0.78936/(U*U+0.19841*U+0.78936)*"
Text="0.45254/(U*U+0.30397*U+0.45254)*"
Text="0.15634/(U*U+0.37288*U+0.15634)*"
Text="0.19841/(U+0.19841)"
Px=302,606
GridSnap=False
JustifyH=Left
JustifyV=Bottom
CBorder=None

[Grid Text]
Text="Out"
Px=1080,192
GridSnap=True
JustifyH=Left
JustifyV=Bottom
CBorder=None

[Schematic]
CurrentSection 0=0
CurrentSection 1=0
CurrentSection 2=0
CurrentSection 3=0
Splitter.xs=0
Splitter.ys=0
TextQuad=4099
Scale=1.3333333333333333
GridUser=10
ShapeGroups="Main","Euro","Polarity","Main1","Main11","Electrolytic","GroundArrow","DeMorgan"
CalcRMS=False
CalcAVG=False
CalcPeak=False
CalcVoltage=True
DisplayMeasure=Last
ShareScales=True

[Tools]
Pos=Top
FILESAVEASOLD=No
BOM=No
FILEPCB=No
PROBE=Yes
SELECT=Yes
PAN=Yes
COMP=Yes
TEXT=Yes
WIRE=Yes
WIRED=Yes
BUS=Yes
GRAPHIC=Yes
FLOWCHART=Yes
LINE=No
ELLIPSE=No
RECT=No
DIAM=No
ARC=No
PIE=No
TRIANGLE=No
STAR=No
LEFTBRK=No
RIGHTBRK=No
BOTHBRK=No
META=Yes
PARALLELOGRAM=No
FC_PROCESS=No
FC_ALT_PROCESS=No
FC_DECISION=No
FC_DATA=No
FC_PREDEFPROCESS=No
FC_INTERNALSTORAGE=No
FC_DOCUMENT=No
FC_MULTIDOCUMENT=No
FC_TERMINATOR=No
FC_PREPARATION=No
FC_MANUALINPUT=No
FC_MANUALOPERATION=No
FC_CONNECTOR=No
FC_OFFPAGECONNECTOR=No
FC_PUNCHCARD=No
FC_PUNCHEDTAPE=No
FC_SUMMING_JUNCTION=No
FC_OR=No
FC_COLLATE=No
FC_SORT=No
FC_EXTRACT=No
FC_MERGE=No
FC_STORED_DATA=No
FC_DELAY=No
FC_SAS=No
FC_MAGNETIC_DISK=No
FC_DAS=No
FC_DISPLAY=No
SPREAD_SHEET=Yes
POLYCLOS=No
POLYOPEN=No
FLAG=Yes
INFO=Yes
HELP=Yes
HELP_SPICE=No
LINK=Yes
CHECK=Yes
REGION_ENABLE=Yes
TITLE_BLOCK=Yes
DIGTRC=No
DIGTRC2=No
BUILD_COMMAND=Yes
DIGALL=No
GRIDTEXT=Yes
COMPTEXT=Yes
NODE=Yes
MEASURED=Yes
NODEV=Yes
CURRENT=Yes
POWER=Yes
CONDITIN=Yes
PIN=Yes
CONNWARN=Yes
CROSS=Yes
GRID=Yes
BORDER=Yes
BORDERONE=Yes
TITLE=Yes
RUBBER=Yes
PROPERTY=Yes
STEP=Yes
MIRROR=Yes
ROTATE=Yes
FLIPY=Yes
FLIPX=Yes
CIR_MAKEMACRO=No
CLEARCUTWIRE=No
CLIPBOARDCIRPAGE2BMM=No
FINDCOMP=Yes
FIND=Yes
REPEAT=No
REPLACE=No
MODEL=Yes
CIR2CKT=Yes
ATTDISP=Yes
ENABLE=Yes
DISABLE=Yes
ENABLE_WITH=Yes
TOFRONT=Yes
TOBACK=Yes
SELNEXT=Yes
PAGEADD=Yes
PAGEADDTEXT=No
ADDSECTION=No
PAGEDEL=Yes
ZOOMIN=Yes
ZOOMOUT=Yes
AUTOSCALECIR=Yes
GOTOFLAG=Yes
UPLEVEL=Yes
COLOR=Yes
FONT=Yes
STYLE=Yes
DM_LAST=No
DM_RMS=No
DM_AVG=No
DM_PEAK=No
GRID_NONE=No
GRID_NORMAL=No
GRID_BOLD_5=No
GRID_BOLD_6=No
GRID_BOLD_USER=No
GRAPH_PAPER=No
SPLITCIRTEXTH=No
SPLITCIRTEXTV=No
SPACE_SPLITTERS_EVENLY=No
NORMALCIR=No
RENAMEDEFINE=No
RENAMECMP=No
ATTALIGN=No
RESETNODEPOS=No
FIT2STANDARD=No
NODESNAP=No
MOVETEXT=No
TEXTINC=No
TOGGLETEXT=No
TOGGLEMODE=No
TOLERANCE=No
ALIGNAB=No
ALIGNLEFT=Yes
ALIGNCENTER=Yes
ALIGNRIGHT=Yes
ALIGNTOP=Yes
ALIGNMIDDLES=Yes
ALIGNBOTTOM=Yes

[Section]
Index=0
Name="Diff_L_C_S_42000000_50000000"
Type=Main
Enable=True
CurrentPage 0=0
CurrentPage 1=0
CurrentPage 2=0
CurrentPage 3=0
TabSize 0=525
TabSize 1=525
TabSize 2=525
TabSize 3=525

[Page]
Index=0
Section=0
Print=True
Enable=True
Name=Main
PrinterScale=1
Scale 0=1
Scale 1=1
Scale 2=1
Scale 3=1.3333333333333333
Px=892,719
WinBackGround Color=#FFFFFF
Select Color=#FF0000
Anchor Color=#000000
Select Box Color=#000080
Grid Text Color=Height=-20,FStyle=0,Color=#0000FF,Name=Verdana
Grid Text RTF=False
Grid Text Angle=0
Grid Text GridSnap=True
Grid Text PinIt=False
Grid Text JustifyH=Left
Grid Text JustifyV=Bottom
Grid GradientColor2=None
Grid OutlineThickness=1
Grid OutlineColor=None
Component Color=#0000FF
Attribute Text=Height=-20,FStyle=0,Color=#008000,Name=Verdana
Wire Color=#008000
Bus Color=#008000
Pin Connection=Height=-15,FStyle=0,Color=#FF0000,Name=Arial
Pin Marker Color=#008000
Node Number=Height=-17,FStyle=0,Color=#FF00FF,Name=Arial
Node Voltage Color=Height=-17,FStyle=0,Color=#000000,Name=Arial
Dynamic AC Voltage Color=#E4E4E4
Text Banner Text=Height=-23,FStyle=0,Color=#800000,Name=Arial
Title Block Background=#C0C0C0
Current=Height=-17,FStyle=0,Color=#0000FF,Name=Arial
Power/Condition=Height=-17,FStyle=0,Color=#FF0000,Name=Arial
Digital Path Color=#FF0000
Title Block Border=#000000
Disabled	Color=#C0C0C0
Search Color=#FFFF00
Grid Color=#000000
Graph Paper=#E4E4E4
Digital 0 Color=#000000
Digital R Color=#FFFF00
Digital F Color=#FFFF00
Digital 1 Color=#FF0000
Digital X Color=#C0C0C0
Digital Z Color=#808080
Block Select Color=#51F998

[Page]
Index=1
Section=0
Type=Text
Print=False
Enable=True
Name=Text
Font=Height=-23,FStyle=0,Color=#000000,Name=Courier New
Comment Color=#008000
WinBackGround Color=#FFFFFF
Disabled	Color=#C0C0C0
KeyWord Color=#0000FF
Error	Color=#FF0000
Search Color=#FFFF00

[Page]
Index=2
Section=0
Type=Text
Print=False
Enable=True
Name=Models
Font=Height=-23,FStyle=0,Color=#000000,Name=Courier New
Comment Color=#008000
WinBackGround Color=#FFFFFF
Disabled	Color=#C0C0C0
KeyWord Color=#0000FF
Error	Color=#FF0000
Search Color=#FFFF00

[Page]
Index=3
Section=0
Type=Info
Print=False
Enable=True
Name=Info
Font=Height=-23,FStyle=0,Color=#000000,Name=Courier New
Comment Color=#008000
WinBackGround Color=#FFFFFF
Disabled	Color=#C0C0C0
KeyWord Color=#0000FF
Error	Color=#FF0000
Search Color=#FFFF00

[Text Area]
Section=0
Page=1

[Text Area]
Section=0
Page=2
Text=.MODEL RM1 RES (R=1)
Text=.MODEL CM1 CAP (C=1)
Text=.MODEL IM1 IND (L=1)

[InfoPage]
InfoPage=True
Warnings=True
System=True
Defines=True
Array=True
Model=True
Measure=True
MacroSubckt=True
NotUsed=True
ComponentCounts=True
VariablizePaths=False
DontShowPaths=False
SimulationLog=True

[AC]
WinID=2
Window Placement=0,1, -1,-1, -8,-31, 0,0,953,770
Font=Height=-19,FStyle=0,Color=#0000FF,Name=Arial
WinBackGround Color=#FFFFFF
Select Color=#FF0000
Anchor Color=#000000
Select Box Color=#000080
Title=Diff_L_C_S_42000000_50000000.cir
AutoTitle=Yes
Grid Color=#808080
Grid Weight=1
Grid Pattern=Dot6
Tracker Foreground=Height=-15,FStyle=0,Color=#000000,Name=Arial
Tracker Background=#FFFF00
Baseline color=#0000FF
BaseLine Weight=1
CurveFit color=#FF0000
CurveFit Weight=2
CurveFit Pattern=Dash
Static Grids=False
PlusMark=False
MinorLog25=Off
LabelMinor=Off
DataPoints=False
Token=False
Ruler=False
XAxisGrids=True
YAxisGrids=True
MinorLogGrids=True
BaseLine=False
AlignZ=True
Align Cursors=True
TagFormatX=3
TagFormatY=3
FormulaFormat=2
EndMode=SCALE
Graph Background=#FFFFFF
Tracker Intercept=False
Tracker Mouse=True
Tracker Cursor=True
Tracker Cursor BranchInfo=False
Horizontal Cursor=False
Same Y Scales=Yes
Enable X Scaling=True
Enable Y Scaling=True
Keep X Scales The Same=True
Number of Grids X=5
Number of Grids Y=5
Cursor Select Color Primary=#C0C0C0
Cursor Select Color Secondary=#FF0000
Data Point Labels Color Fore=Height=-15,FStyle=0,Color=#000000,Name=Arial
Data Point Labels Color Back=#FFFF00
OperPoint=True
AutoScaleRanges=True
FFT_NPts="8192"
FFT_IncludeDCHarmonic=False
FFT_AutoScale_Harmonics="10"
PrinterAutoTile=No
PrinterBlackBorder=No
MonMaxShow=3
MonPageWidth=66
MonPlotWidth=21
MonExprXWidth=142
MonExprYWidth=260
MonRangeXWidth=90
MonRangeYWidth=90
AnimateWait=None
AnimateWaitTime=500
AnimatePressAfter=0
Save_For_Future=No
Reduce_Display=1
Reduce_Save=1
Reduce_ThrowDataOut=0
Num Out Header Left
Num Out Header Center="$MC\n$user\n$company\n$Analysis of $name\n$date $time"
Num Out Header Right
Num Out Delimiter=32
Num Out Write=True
Num Out Write Main Header=True
Num Out Write Limits=True
Num Out Write Branch Header=True
Num Out Write Models=False
Num Out Write Zero Models=True
Num Out Write Undefined Models=True
Num Out Write Operating Point=True
Num Out Write Measurement Values=True
Num Out Write Tolerance Detail=True
Num Out Write Noise=True
Num Out Write Values=True
Num Out Write Waveform Header=True
Num Out Allow Dup Y Expr=False
Num Out Low="FMIN"
Num Out High="FMAX"
Num Out Font=Height=-15,FStyle=0,Color=#000000,Name=Courier New
Num Out Format=3
Num Out HideNonSelected=False
Num Out UseActualDataPoints=False
AutoSaveWave=False
Wave Format=16E
State Variables Format=5E
Print Individual Pages=False

[Tools]
Pos=Top
SELECT=Yes
PAN=Yes
GRAPHIC=Yes
LINE=No
ELLIPSE=No
RECT=No
DIAM=No
ARC=No
PIE=No
TRIANGLE=No
STAR=No
LEFTBRK=No
RIGHTBRK=No
BOTHBRK=No
META=No
PARALLELOGRAM=No
POLYCLOS=No
POLYOPEN=No
SCALE=Yes
CURSOR=Yes
MEASUREH=Yes
MEASUREV=Yes
TAG=Yes
PTAG=Yes
TEXT=Yes
PROPERTY=Yes
START=Yes
STOP=Yes
PAUSE=Yes
RESUME=No
DATAPTS=Yes
TOKENS=Yes
RULER=Yes
PLUS=Yes
XAXIS=Yes
YAXIS=Yes
MINORLOG=Yes
LOG25=Yes
BASELINE=Yes
HORIZCUR=Yes
GOTOX=Yes
GOTOY=Yes
GOTOPERF=Yes
GOTOBRNC=Yes
CLEAR_ACCUMULATED=Yes
PDELETE_ALL_PLOTS=Yes
NEXT=Yes
NEXTIN=Yes
PEAK=Yes
VALLEY=Yes
HIGH=Yes
LOW=Yes
INFLECTN=Yes
GHIGH=Yes
GLOW=Yes
BOTTOM=Yes
TOP=Yes
WAVEFORMBUFFER=Yes
AOUTPUT=Yes
PKEY=Yes
ENXSCALE=Yes
ENYSCALE=Yes
ZOOMIN=Yes
ZOOMOUT=Yes
AUTOSCALE=Yes
RESTORESCALE=No
COLOR=Yes
FONT=Yes
STYLE=Yes
SELNEXT=No
NORMALIZE=No
NORMALIZE_MIN=No
NORMALIZE_MAX=No
ADD_TAG_LEFT=No
ADD_TAG_RIGHT=No
ADD_HORZ_TAG=No
ADD_VERT_TAG=No
ALIGN_CURSORS=No
ALIGN_CURSORSZ=No
CURSORTOCLIPBOARD=No
TRACKER_CURSOR=No
TRACKER_CURSOR_BRANCHINFO=No
TRACKER_INTERCEPT=No
TRACKER_MOUSE=No
TOFRONT=Yes
TOBACK=Yes
SPLITCIRTEXTH=No
SPLITCIRTEXTV=No
SPACE_SPLITTERS_EVENLY=No
NORMALCIR=No
LABEL_WAVEFORM=No
LABEL_DATA_POINTS=No
WFB_ADD_TO_LIMITS=No
ENVELOPE=No
SAMEYSCALES=No
KEEPXSCALESTHESAME=No
CURVEFIT=No
ADD_MARKER=No
SHOWWATCH=No
BP=No
TOGGLEMODE=No
REMOVEALLTEXT=No
AUTOSCALEX=No
LABELALLMINOR=No
ALIGNLEFT=No
ALIGNCENTER=No
ALIGNRIGHT=No
ALIGNTOP=No
ALIGNMIDDLES=No
ALIGNBOTTOM=No

[APage]
Analysis=AC
Name="MAIN"

[AObject]
Analysis=AC
Object=MeasureV
Locked=True
EndPoint=ArrowF
CBorder=#000080
w=2
AliasID1=3
w2=2
AliasID2=3
Pos=6950243.1758881425,2.8160998314098183e-008,28973435.877014477,4.0078765200660695e-008
Posm=7324902.7787263775
Font=Height=-23,FStyle=0,Color=#008000,Name=Arial
Format=3

[Monte Carlo Options]
Analysis=AC
Status=Off
Zero Tolerance=False
Eliminate Outliers=False
Distribution=Normal
Number of Runs=10
Seed=0

[Limits]
Analysis=AC
FRange=1E8,1Meg
NPts=1001
Temp=27
MaxChng=5
NInput=NONE
NOutput=2
Sweep type=Log
StateVar=Zero
RunOption=Normal
Temperature Type=Linear
Accumulate Plots=False
IgnoreExprErrors=False
FirstValueDisplay=Mag
SecondValueDisplay=PhaseDeg
DisplayValuesInProbe=DC

[WaveForm]
Analysis=AC
Plt=1
AliasID=1
XExp=F
YExp=dB(v(RL))
XRng=1e+8,1e+6
YRng=30,-120
Options=LINEARY
Range Grid X=1.98e+7
Range Grid Y=30
Enable=Enable
CS=Normal
Line Color=#0000FF
Text Color=#0000FF
Rainbow=False
LWdth=3
VFmtX=3
VFmtY=3
ScaleFactorX="None"
ScaleFactorY="None"
ScaleUnitsX="Auto"
ScaleUnitsY="Auto"
SFmtX=2
SFmtY=2
NOFmtX=3E
NOFmtY=3E

[WaveForm]
Analysis=AC
Plt=2
AliasID=2
XExp=F
YExp=ph(v(RL))
XRng=1e+8,1e+6
YRng=500,-750
Options=LINEARY
Range Grid X=1.98e+7
Range Grid Y=250
Enable=Enable
CS=Normal
Line Color=#FF0000
Text Color=#FF0000
Rainbow=False
LWdth=3
VFmtX=3
VFmtY=3
ScaleFactorX="None"
ScaleFactorY="None"
ScaleUnitsX="Auto"
ScaleUnitsY="Auto"
SFmtX=2
SFmtY=2
NOFmtX=3E
NOFmtY=3E

[WaveForm]
Analysis=AC
Plt=3
AliasID=3
XExp=F
YExp=GD(v(RL))
XRng=1e+8,1e+6
YRng=2e-7
Options=LINEARY
Range Grid X=1.98e+7
Range Grid Y=4e-8
Enable=Enable
CS=Normal
Line Color=#008000
Text Color=#008000
Rainbow=False
LWdth=4
VFmtX=3
VFmtY=3
ScaleFactorX="None"
ScaleFactorY="None"
ScaleUnitsX="Auto"
ScaleUnitsY="Auto"
SFmtX=2
SFmtY=2
NOFmtX=3E
NOFmtY=3E

[Limits]
Analysis=DynamicAC
FirstValueDisplay=Mag
SecondValueDisplay=PhaseDeg
PlaceText=True

[Limits]
Analysis=DynamicDC
PlaceText=True

[Pane]
Analysis=Transient

[Pane]
Analysis=AC
CurrentPage 0="MAIN"

[Pane]
Analysis=DC

[Pane]
Analysis=HmDistortion

[Pane]
Analysis=ImDistortion

[Pane]
Analysis=Stability

[Watch]
Analysis=AC
Format=3
ExprPercentWidth=80

[WCTolerance]
Var Width=125
Nominal Width=90
Tol Width=190
Tol Name=Drift
Col Width Neq=63
Col Width Pos=63
Col Width Rnd=63

[WCFiles]
UseFile=<Library>Standard.tlib
AVAILABLE_FILE=<Library>Standard.tlib

[OPMethods]
Analysis=Transient
Standard Newton-Raphson=0,0
Source Stepping=0,0
Diagonal Gmin Stepping=0,0
Junction Gmin Stepping=0,0
Pseudo Transient=0,0

[OPMethods]
Analysis=AC
Standard Newton-Raphson=0,0
Source Stepping=0,0
Diagonal Gmin Stepping=0,0
Junction Gmin Stepping=0,0
Pseudo Transient=0,0

[OPMethods]
Analysis=DC
Standard Newton-Raphson=0,0
Source Stepping=0,0
Diagonal Gmin Stepping=0,0
Junction Gmin Stepping=0,0
Pseudo Transient=0,0

[OPMethods]
Analysis=HmDistortion
Standard Newton-Raphson=0,0
Source Stepping=0,0
Diagonal Gmin Stepping=0,0
Junction Gmin Stepping=0,0
Pseudo Transient=0,0

[OPMethods]
Analysis=ImDistortion
Standard Newton-Raphson=0,0
Source Stepping=0,0
Diagonal Gmin Stepping=0,0
Junction Gmin Stepping=0,0
Pseudo Transient=0,0

[OPMethods]
Analysis=Stability
Standard Newton-Raphson=0,0
Source Stepping=0,0
Diagonal Gmin Stepping=0,0
Junction Gmin Stepping=0,0
Pseudo Transient=0,0

[OPMethods]
Analysis=DynamicAC
Standard Newton-Raphson=0,0
Source Stepping=0,0
Diagonal Gmin Stepping=0,0
Junction Gmin Stepping=0,0
Pseudo Transient=0,0

[OPMethods]
Analysis=DynamicDC
Standard Newton-Raphson=0,0
Source Stepping=0,0
Diagonal Gmin Stepping=0,0
Junction Gmin Stepping=0,0
Pseudo Transient=0,0
