BYakov/Rx-Tx_module/(list of files, drawings)

Other design files:
Oldfiles/усилитель 100Мгц/tranzistor_amplifier_input.ms14
