BYakov/Rx-Tx_module/PCB/SDR/SDR.kicad_pcb

## KiCad design PCB/SDR/SDR.kicad_pcb (2020-12-24)

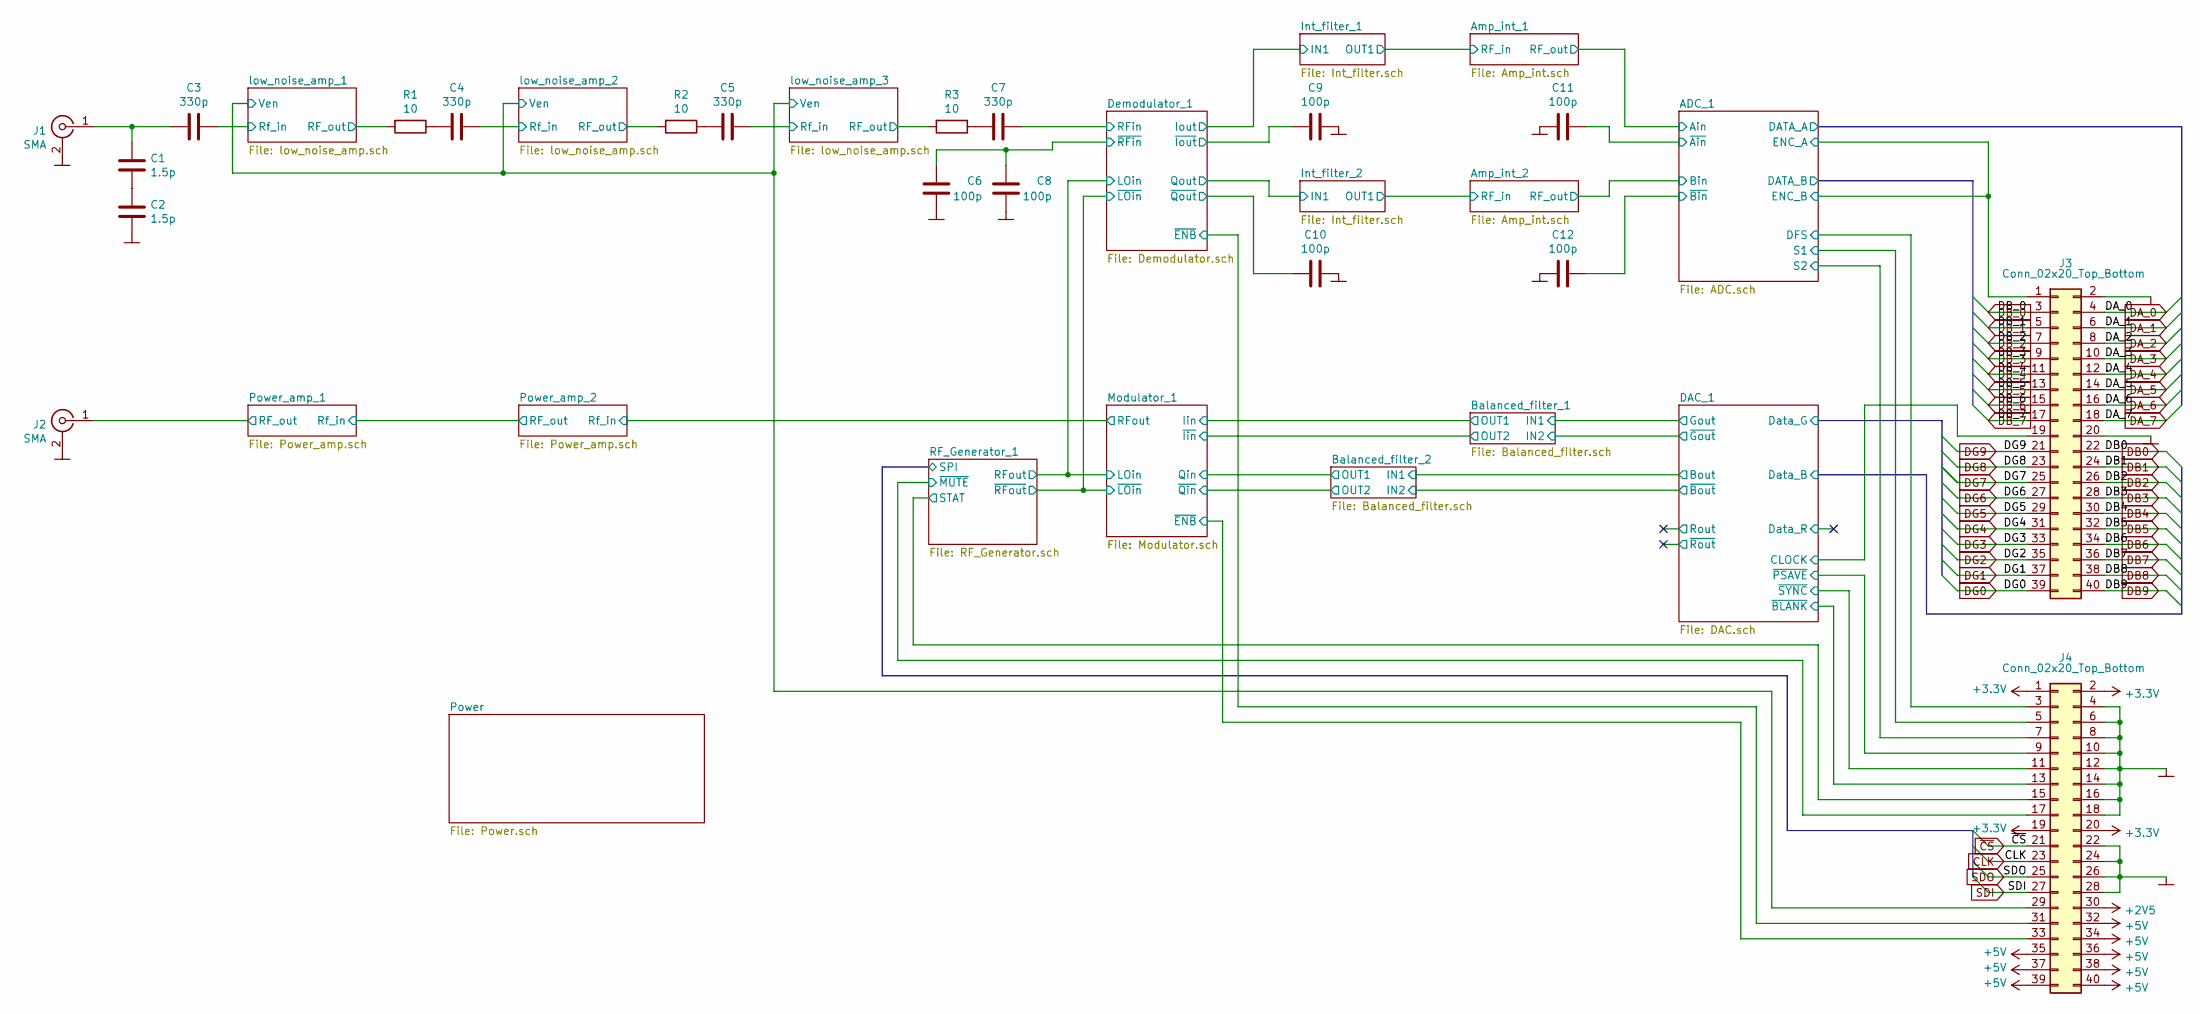
[picture p144: schematic SDR.sch, РЧ Модуль\\nСхема принципиальная]

Parts:
C1, C2: 1.5p; C_0805_2012Metric_Pad1.18x1.45mm_HandSolder
C3, C4, C5, C7: 330p; C_0805_2012Metric_Pad1.18x1.45mm_HandSolder
C6, C8, C9, C10, C11, C12: 100p; C_0805_2012Metric_Pad1.18x1.45mm_HandSolder
J1, J2: SMA; SMA_Amphenol_132289_EdgeMount
J3, J4: Conn_02x20_Top_Bottom; PinHeader_2x20_P2.54mm_Vertical
R1, R2, R3: 10; R_0805_2012Metric_Pad1.20x1.40mm_HandSolder

Connections:
+2V5: J4.30; also elsewhere on the board
+3V3: J4.1, J4.2, J4.19, J4.20; also elsewhere on the board
+5V: J4.32, J4.34, J4.35, J4.36, J4.37, J4.38, J4.39, J4.40; also elsewhere on the board
/ADC_1/DFS: J4.3; also elsewhere on the board
/ADC_1/ENC_A: J3.1; also elsewhere on the board
/ADC_1/S1: J4.5; also elsewhere on the board
/ADC_1/S2: J4.7; also elsewhere on the board
/ADC_1/~Ain: C12.2; also elsewhere on the board
/ADC_1/~Bin: C11.2; also elsewhere on the board
/DAC_1/CLOCK: J3.19; also elsewhere on the board
/DAC_1/~BLANK: J4.13; also elsewhere on the board
/DAC_1/~PSAVE: J4.9; also elsewhere on the board
/DAC_1/~SYNC: J4.11; also elsewhere on the board
/Demodulator_1/RFin: C7.1; also elsewhere on the board
/Demodulator_1/~ENB: J4.31; also elsewhere on the board
/Demodulator_1/~Iout: C9.1; also elsewhere on the board
/Demodulator_1/~Qout: C10.1; also elsewhere on the board
/Demodulator_1/~RFin: C6.2, C8.2; also elsewhere on the board
/Modulator_1/~ENB: J4.33; also elsewhere on the board
/Power_amp_1/RF_out: J2.1 (In); also elsewhere on the board
/RF_Generator_1/STAT: J4.15; also elsewhere on the board
/RF_Generator_1/~MUTE: J4.17; also elsewhere on the board
/low_noise_amp_1/RF_out: R1.2; also elsewhere on the board
/low_noise_amp_1/Rf_in: C3.1; also elsewhere on the board
/low_noise_amp_1/Ven: J4.29; also elsewhere on the board
/low_noise_amp_2/RF_out: R2.2; also elsewhere on the board
/low_noise_amp_2/Rf_in: C4.1; also elsewhere on the board
/low_noise_amp_3/RF_out: R3.2; also elsewhere on the board
/low_noise_amp_3/Rf_in: C5.1; also elsewhere on the board
CLK: J4.23; also elsewhere on the board
COMM: C2.2, C6.1, C8.1, C9.2, C10.2, C11.1, C12.1, J1.2 (Ext), J2.2 (Ext), J3.2, J3.20, J4.4, J4.6, J4.8, J4.10, J4.12, J4.14, J4.16, J4.18, J4.22, J4.24, J4.26, J4.28; also elsewhere on the board
DA_0: J3.4; also elsewhere on the board
DA_1: J3.6; also elsewhere on the board
DA_2: J3.8; also elsewhere on the board
DA_3: J3.10; also elsewhere on the board
DA_4: J3.12; also elsewhere on the board
DA_5: J3.14; also elsewhere on the board
DA_6: J3.16; also elsewhere on the board
DA_7: J3.18; also elsewhere on the board
DB0: J3.22; also elsewhere on the board
DB1: J3.24; also elsewhere on the board
DB2: J3.26; also elsewhere on the board
DB3: J3.28; also elsewhere on the board
DB4: J3.30; also elsewhere on the board
DB5: J3.32; also elsewhere on the board
DB6: J3.34; also elsewhere on the board
DB7: J3.36; also elsewhere on the board
DB8: J3.38; also elsewhere on the board
DB9: J3.40; also elsewhere on the board
DB_0: J3.3; also elsewhere on the board
DB_1: J3.5; also elsewhere on the board
DB_2: J3.7; also elsewhere on the board
DB_3: J3.9; also elsewhere on the board
DB_4: J3.11; also elsewhere on the board
DB_5: J3.13; also elsewhere on the board
DB_6: J3.15; also elsewhere on the board
DB_7: J3.17; also elsewhere on the board
DG0: J3.39; also elsewhere on the board
DG1: J3.37; also elsewhere on the board
DG2: J3.35; also elsewhere on the board
DG3: J3.33; also elsewhere on the board
DG4: J3.31; also elsewhere on the board
DG5: J3.29; also elsewhere on the board
DG6: J3.27; also elsewhere on the board
DG7: J3.25; also elsewhere on the board
DG8: J3.23; also elsewhere on the board
DG9: J3.21; also elsewhere on the board
unnamed: C1.1, C3.2, J1.1 (In)
unnamed: C1.2, C2.1
unnamed: C4.2, R1.1
unnamed: C5.2, R2.1
unnamed: C7.2, R3.1
SDI: J4.27; also elsewhere on the board
SDO: J4.25; also elsewhere on the board
~CS: J4.21; also elsewhere on the board

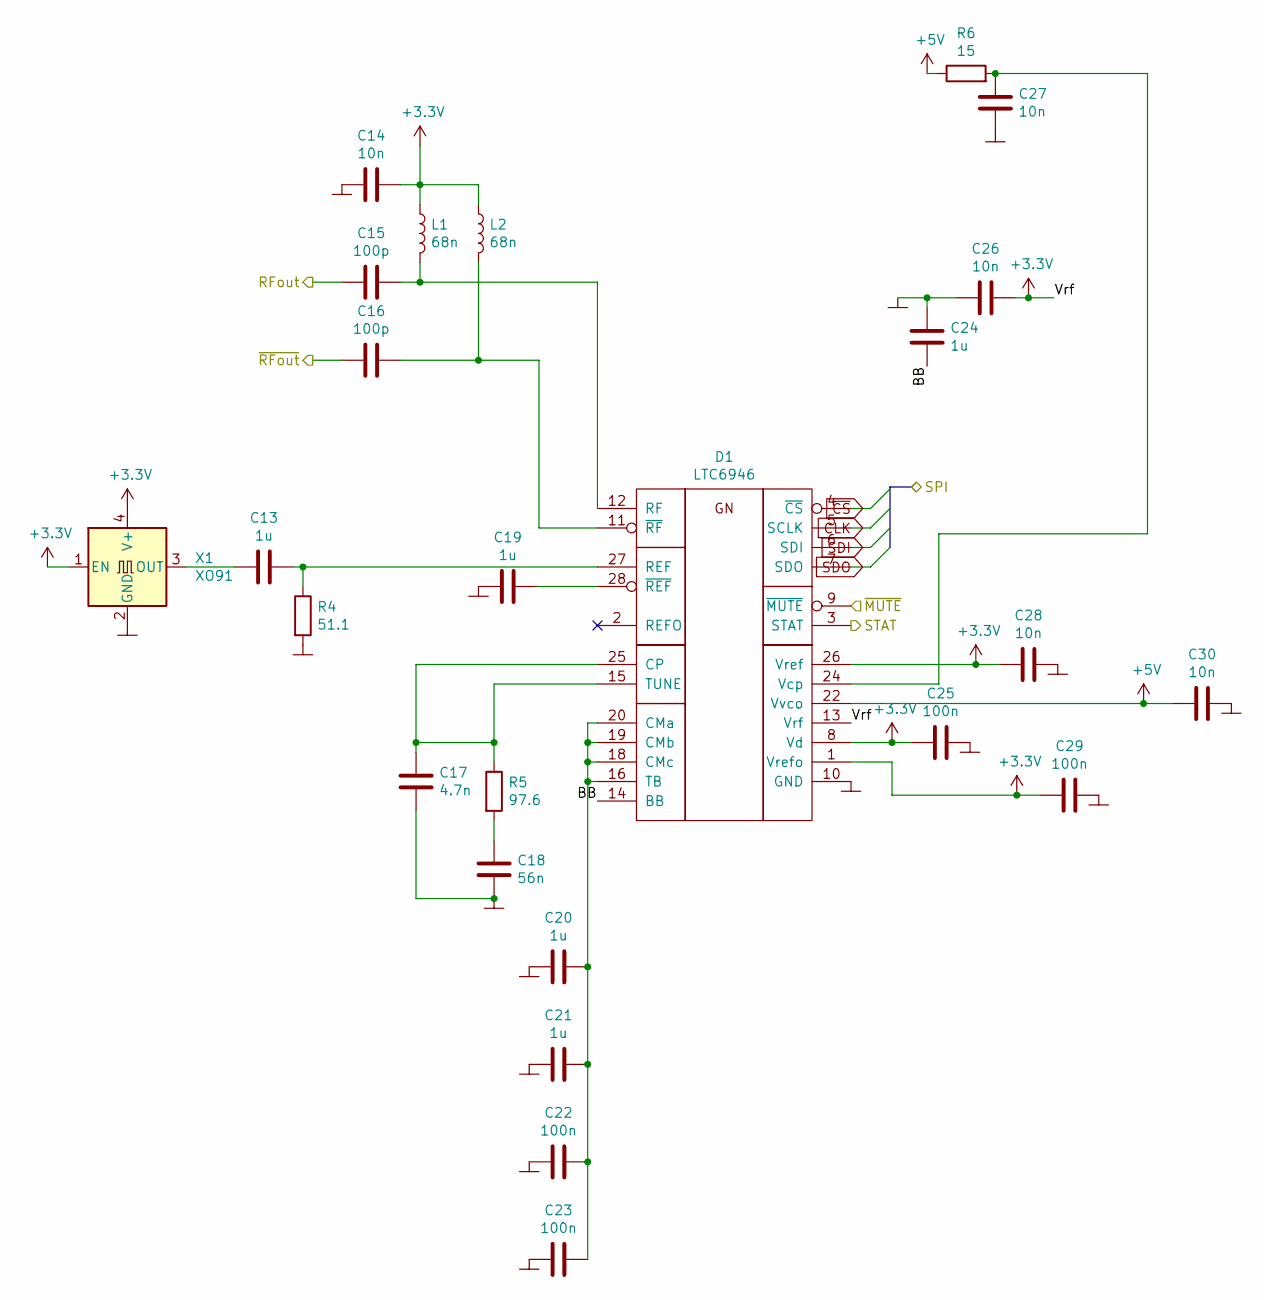
[picture p145: schematic RF_Generator.sch, РЧ Модуль\\nСхема принципиальная]

Parts:
C13, C19, C20, C21, C24: 1u; C_0805_2012Metric_Pad1.18x1.45mm_HandSolder
C14, C26, C27, C28, C30: 10n; C_1206_3216Metric_Pad1.33x1.80mm_HandSolder
C15, C16: 100p; C_0805_2012Metric_Pad1.18x1.45mm_HandSolder
C17: 4.7n; C_1206_3216Metric_Pad1.33x1.80mm_HandSolder
C18: 56n; C_1206_3216Metric_Pad1.33x1.80mm_HandSolder
C22, C23, C25, C29: 100n; C_1206_3216Metric_Pad1.33x1.80mm_HandSolder
D1: LTC6946; QFN-28-1EP_4x5mm_P0.5mm_EP2.65x3.65mm_ThermalVias
L1, L2: 68n; L_0402_1005Metric_Pad0.77x0.64mm_HandSolder
R4: 51.1; R_0805_2012Metric_Pad1.20x1.40mm_HandSolder
R5: 97.6; R_0805_2012Metric_Pad1.20x1.40mm_HandSolder
R6: 15; R_0805_2012Metric_Pad1.20x1.40mm_HandSolder
X1: XO91; Oscillator_SMD_EuroQuartz_XO91-4Pin_7.0x5.0mm

Connections:
+3V3: C14.1, C25.1, C26.1, C28.1, C29.1, D1.1 (Vrefo), D1.8 (Vd), D1.13 (Vrf), D1.26 (Vref), L1.1, L2.1, X1.1 (EN), X1.4 (V+); also elsewhere on the board
+5V: C30.1, D1.22 (Vvco), R6.1; also elsewhere on the board
/Demodulator_1/LOin: C15.2; also elsewhere on the board
/Demodulator_1/~LOin: C16.2; also elsewhere on the board
/RF_Generator_1/BB: C24.2, D1.14 (BB)
/RF_Generator_1/STAT: D1.3 (STAT); also elsewhere on the board
/RF_Generator_1/~MUTE: D1.9 (~MUTE); also elsewhere on the board
CLK: D1.5 (SCLK); also elsewhere on the board
COMM: C14.2, C17.2, C18.2, C19.1, C20.2, C21.2, C22.2, C23.2, C24.1, C25.2, C26.2, C27.2, C28.2, C29.2, C30.2, D1.10 (GND), D1.17 (GND), D1.21 (GND), D1.23 (GND), D1.29 (Ep), R4.2, X1.2 (GND); also elsewhere on the board
unnamed: C13.1, D1.27 (REF), R4.1
unnamed: C13.2, X1.3 (OUT)
unnamed: C15.1, D1.12 (RF), L1.2
unnamed: C16.1, D1.11 (~RF), L2.2
unnamed: C17.1, D1.15 (TUNE), D1.25 (CP), R5.1
unnamed: C18.1, R5.2
unnamed: C19.2, D1.28 (~REF)
unnamed: C20.1, C21.1, C22.1, C23.1, D1.16 (TB), D1.18 (CMc), D1.19 (CMb), D1.20 (CMa)
unnamed: C27.1, D1.24 (Vcp), R6.2
SDI: D1.6 (SDI); also elsewhere on the board
SDO: D1.7 (SDO); also elsewhere on the board
~CS: D1.4 (~CS); also elsewhere on the board

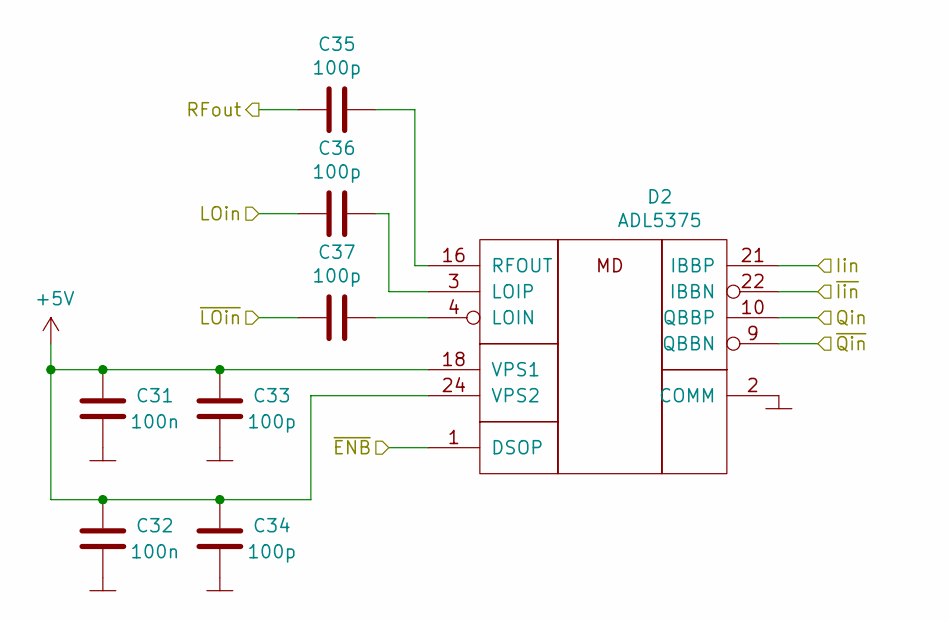
[picture p146: schematic Modulator.sch, РЧ Модуль\\nСхема принципиальная]

Parts:
C31, C32: 100n; C_1206_3216Metric_Pad1.33x1.80mm_HandSolder
C33, C34, C35, C36, C37: 100p; C_0805_2012Metric_Pad1.18x1.45mm_HandSolder
D2: ADL5375; LFCSP-24-1EP_4x4mm_P0.5mm_EP2.5x2.5mm_ThermalVias

Connections:
+5V: C31.2, C32.2, C33.2, C34.2, D2.18 (VPS1), D2.24 (VPS2); also elsewhere on the board
/Balanced_filter_1/OUT2: D2.22 (IBBN); also elsewhere on the board
/Balanced_filter_2/OUT1: D2.10 (QBBP); also elsewhere on the board
/Balanced_filter_2/OUT2: D2.9 (QBBN); also elsewhere on the board
/Demodulator_1/LOin: C36.2; also elsewhere on the board
/Demodulator_1/~LOin: C37.2; also elsewhere on the board
/Modulator_1/Iin: D2.21 (IBBP); also elsewhere on the board
/Modulator_1/RFout: C35.1; also elsewhere on the board
/Modulator_1/~ENB: D2.1 (DSOP); also elsewhere on the board
COMM: C31.1, C32.1, C33.1, C34.1, D2.2 (COMM), D2.5 (COMM), D2.8 (COMM), D2.11 (COMM), D2.12 (COMM), D2.14 (COMM), D2.17 (COMM), D2.19 (COMM), D2.20 (COMM), D2.23 (COMM), D2.25 (EP); also elsewhere on the board
unnamed: C35.2, D2.16 (RFOUT)
unnamed: C36.1, D2.3 (LOIP)
unnamed: C37.1, D2.4 (LOIN)

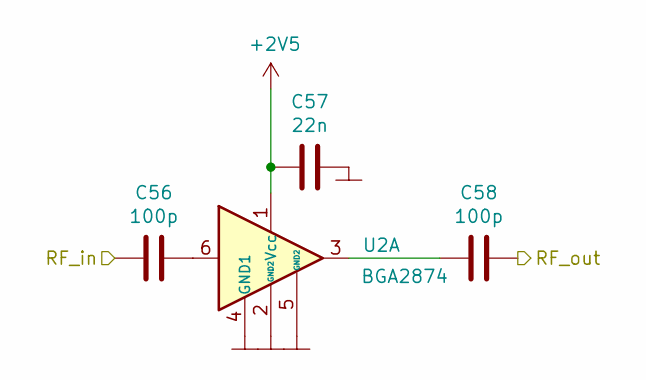
[picture p147: schematic Amp_int.sch, РЧ Модуль\\nСхема принципиальная]

Parts:
C38, C40: 100p; C_0805_2012Metric_Pad1.18x1.45mm_HandSolder
C39: 22n; C_0805_2012Metric_Pad1.18x1.45mm_HandSolder
U1: BGA2874; SOT-363_SC-70-6_Handsoldering

Connections:
+2V5: C39.2, U1.1 (Vcc); also elsewhere on the board
/ADC_1/Bin: C40.1; also elsewhere on the board
/Int_filter_1/OUT1: C38.2; also elsewhere on the board
COMM: C39.1, U1.2 (GND2), U1.4 (GND1), U1.5 (GND2); also elsewhere on the board
unnamed: C38.1, U1.6
unnamed: C40.2, U1.3

Parts of its further copies:
C56, C58: 100p; C_0805_2012Metric_Pad1.18x1.45mm_HandSolder
C57: 22n; C_0805_2012Metric_Pad1.18x1.45mm_HandSolder
U2: BGA2874; SOT-363_SC-70-6_Handsoldering

Connections of its further copies:
+2V5: C57.2, U2.1 (Vcc); also elsewhere on the board
/ADC_1/Ain: C58.1; also elsewhere on the board
/Int_filter_2/OUT1: C56.2; also elsewhere on the board
COMM: C57.1, U2.2 (GND2), U2.4 (GND1), U2.5 (GND2); also elsewhere on the board
unnamed: C56.1, U2.6
unnamed: C58.2, U2.3

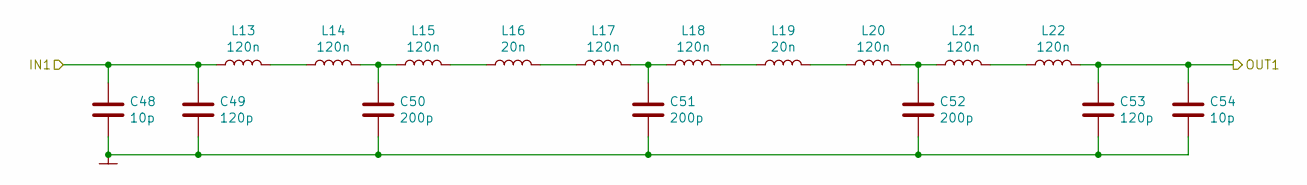
[picture p148: schematic Int_filter.sch, РЧ Модуль\\nСхема принципиальная]

Parts:
C41, C47: 10p; C_0805_2012Metric_Pad1.18x1.45mm_HandSolder
C42, C46: 120p; C_0805_2012Metric_Pad1.18x1.45mm_HandSolder
C43, C44, C45: 200p; C_0805_2012Metric_Pad1.18x1.45mm_HandSolder
L3, L4, L5, L7, L8, L10, L11, L12: 120n; L_0402_1005Metric_Pad0.77x0.64mm_HandSolder
L6, L9: 20n; L_0603_1608Metric_Pad1.05x0.95mm_HandSolder

Connections:
/Int_filter_1/IN1: C41.1, C42.1, L3.1; also elsewhere on the board
/Int_filter_1/OUT1: C46.1, C47.1, L12.2; also elsewhere on the board
COMM: C41.2, C42.2, C43.2, C44.2, C45.2, C46.2, C47.2; also elsewhere on the board
unnamed: C43.1, L4.2, L5.1
unnamed: C44.1, L7.2, L8.1
unnamed: C45.1, L10.2, L11.1
unnamed: L3.2, L4.1
unnamed: L5.2, L6.1
unnamed: L6.2, L7.1
unnamed: L8.2, L9.1
unnamed: L9.2, L10.1
unnamed: L11.2, L12.1

Parts of its further copies:
C48, C54: 10p; C_0805_2012Metric_Pad1.18x1.45mm_HandSolder
C49, C53: 120p; C_0805_2012Metric_Pad1.18x1.45mm_HandSolder
C50, C51, C52: 200p; C_0805_2012Metric_Pad1.18x1.45mm_HandSolder
L13, L14, L15, L17, L18, L20, L21, L22: 120n; L_0402_1005Metric_Pad0.77x0.64mm_HandSolder
L16, L19: 20n; L_0603_1608Metric_Pad1.05x0.95mm_HandSolder

Connections of its further copies:
/Int_filter_2/IN1: C48.1, C49.1, L13.1; also elsewhere on the board
/Int_filter_2/OUT1: C53.1, C54.1, L22.2; also elsewhere on the board
COMM: C48.2, C49.2, C50.2, C51.2, C52.2, C53.2, C54.2; also elsewhere on the board
unnamed: C50.1, L14.2, L15.1
unnamed: C51.1, L17.2, L18.1
unnamed: C52.1, L20.2, L21.1
unnamed: L13.2, L14.1
unnamed: L15.2, L16.1
unnamed: L16.2, L17.1
unnamed: L18.2, L19.1
unnamed: L19.2, L20.1
unnamed: L21.2, L22.1

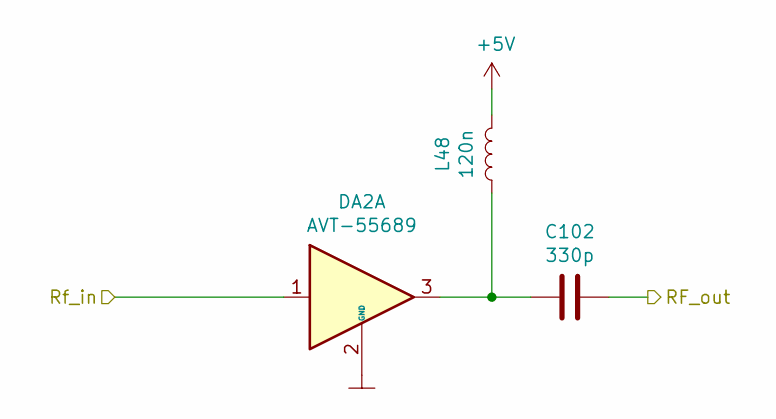
[picture p149: schematic Power_amp.sch, РЧ Модуль\\nСхема принципиальная]

Parts:
C55: 330p; C_1206_3216Metric_Pad1.33x1.80mm_HandSolder
DA1: AVT-55689; SOT-89-3_Handsoldering
L23: 120n; L_0402_1005Metric_Pad0.77x0.64mm_HandSolder

Connections:
+5V: L23.2; also elsewhere on the board
/Power_amp_1/RF_out: C55.1; also elsewhere on the board
/Power_amp_2/RF_out: DA1.1; also elsewhere on the board
COMM: DA1.2 (GND); also elsewhere on the board
unnamed: C55.2, DA1.3, L23.1

Parts of its further copies:
C102: 330p; C_1206_3216Metric_Pad1.33x1.80mm_HandSolder
DA2: AVT-55689; SOT-89-3_Handsoldering
L48: 120n; L_0402_1005Metric_Pad0.77x0.64mm_HandSolder

Connections of its further copies:
+5V: L48.2; also elsewhere on the board
/Modulator_1/RFout: DA2.1; also elsewhere on the board
/Power_amp_2/RF_out: C102.1; also elsewhere on the board
COMM: DA2.2 (GND); also elsewhere on the board
unnamed: C102.2, DA2.3, L48.1

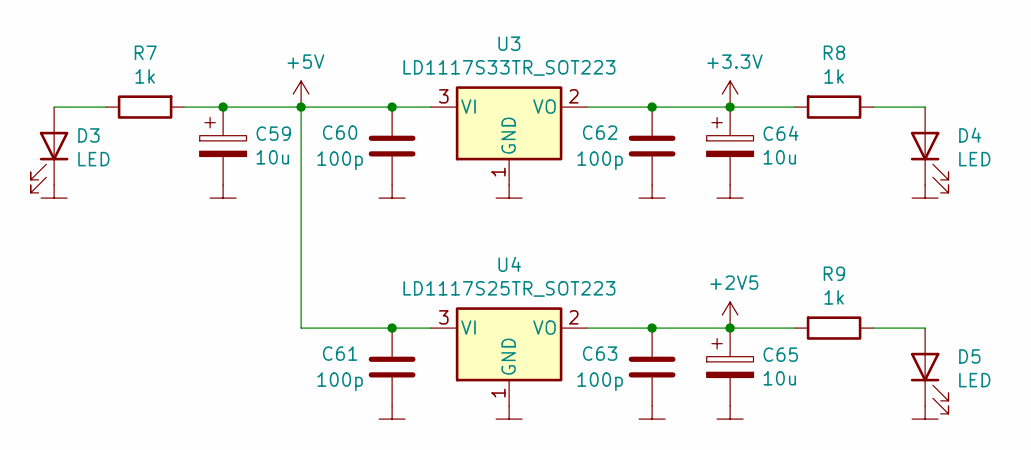
[picture p150: schematic Power.sch, РЧ Модуль\\nСхема принципиальная]

Parts:
C59, C64, C65: 10u; CP_Elec_4x5.4
C60, C61, C62, C63: 100p; C_0805_2012Metric_Pad1.18x1.45mm_HandSolder
D3, D4, D5: LED; D_1206_3216Metric_Pad1.42x1.75mm_HandSolder
R7, R8, R9: 1k; R_0805_2012Metric_Pad1.20x1.40mm_HandSolder
U3: LD1117S33TR_SOT223; SOT-223-3_TabPin2
U4: LD1117S25TR_SOT223; SOT-223-3_TabPin2

Connections:
+2V5: C63.2, C65.1, R9.2, U4.2 (VO); also elsewhere on the board
+3V3: C62.2, C64.1, R8.2, U3.2 (VO); also elsewhere on the board
+5V: C59.1, C60.2, C61.2, R7.2, U3.3 (VI), U4.3 (VI); also elsewhere on the board
COMM: C59.2, C60.1, C61.1, C62.1, C63.1, C64.2, C65.2, D3.1 (K), D4.1 (K), D5.1 (K), U3.1 (GND), U4.1 (GND); also elsewhere on the board
unnamed: D3.2 (A), R7.1
unnamed: D4.2 (A), R8.1
unnamed: D5.2 (A), R9.1

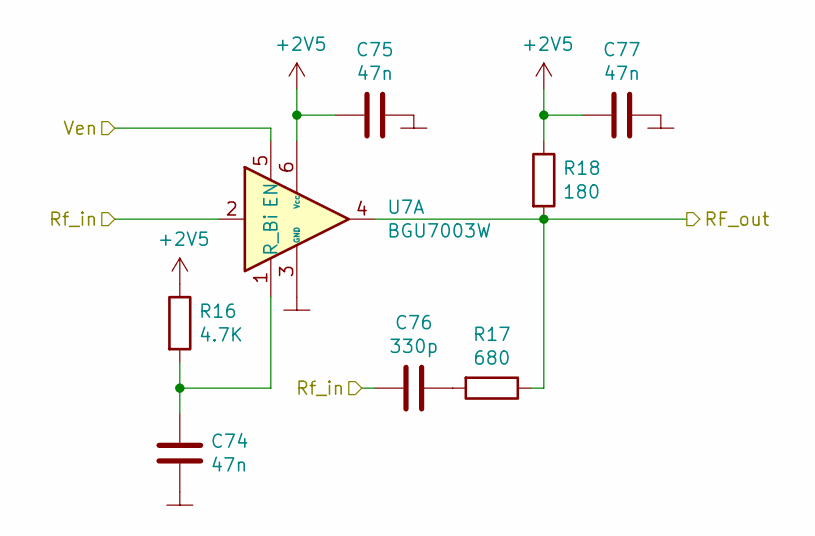
[picture p151: schematic low_noise_amp.sch, РЧ Модуль\\nСхема принципиальная]

Parts:
C66, C67, C69: 47n; C_1206_3216Metric_Pad1.33x1.80mm_HandSolder
C68: 330p; C_0805_2012Metric_Pad1.18x1.45mm_HandSolder
R10: 4.7К; R_0805_2012Metric_Pad1.20x1.40mm_HandSolder
R11: 680; R_0805_2012Metric_Pad1.20x1.40mm_HandSolder
R12: 180; R_0805_2012Metric_Pad1.20x1.40mm_HandSolder
U5: BGU7003W; SOT-886

Connections:
+2V5: C67.2, C69.2, R10.1, R12.1, U5.6 (Vcc); also elsewhere on the board
/low_noise_amp_1/RF_out: R11.1, R12.2, U5.4; also elsewhere on the board
/low_noise_amp_1/Rf_in: C68.2, U5.2; also elsewhere on the board
/low_noise_amp_1/Ven: U5.5 (EN); also elsewhere on the board
COMM: C66.2, C67.1, C69.1, U5.3 (GND); also elsewhere on the board
unnamed: C66.1, R10.2, U5.1 (R_Bi)
unnamed: C68.1, R11.2

Parts of its further copies:
C70, C71, C73, C74, C75, C77: 47n; C_1206_3216Metric_Pad1.33x1.80mm_HandSolder
C72, C76: 330p; C_0805_2012Metric_Pad1.18x1.45mm_HandSolder
R13, R16: 4.7К; R_0805_2012Metric_Pad1.20x1.40mm_HandSolder
R14, R17: 680; R_0805_2012Metric_Pad1.20x1.40mm_HandSolder
R15, R18: 180; R_0805_2012Metric_Pad1.20x1.40mm_HandSolder
U6, U7: BGU7003W; SOT-886

Connections of its further copies:
+2V5: C71.2, C73.2, C75.2, C77.2, R13.1, R15.1, R16.1, R18.1, U6.6 (Vcc), U7.6 (Vcc); also elsewhere on the board
/low_noise_amp_1/Ven: U6.5 (EN), U7.5 (EN); also elsewhere on the board
/low_noise_amp_2/RF_out: R14.1, R15.2, U6.4; also elsewhere on the board
/low_noise_amp_2/Rf_in: C72.2, U6.2; also elsewhere on the board
/low_noise_amp_3/RF_out: R17.1, R18.2, U7.4; also elsewhere on the board
/low_noise_amp_3/Rf_in: C76.2, U7.2; also elsewhere on the board
COMM: C70.2, C71.1, C73.1, C74.2, C75.1, C77.1, U6.3 (GND), U7.3 (GND); also elsewhere on the board
unnamed: C70.1, R13.2, U6.1 (R_Bi)
unnamed: C72.1, R14.2
unnamed: C74.1, R16.2, U7.1 (R_Bi)
unnamed: C76.1, R17.2

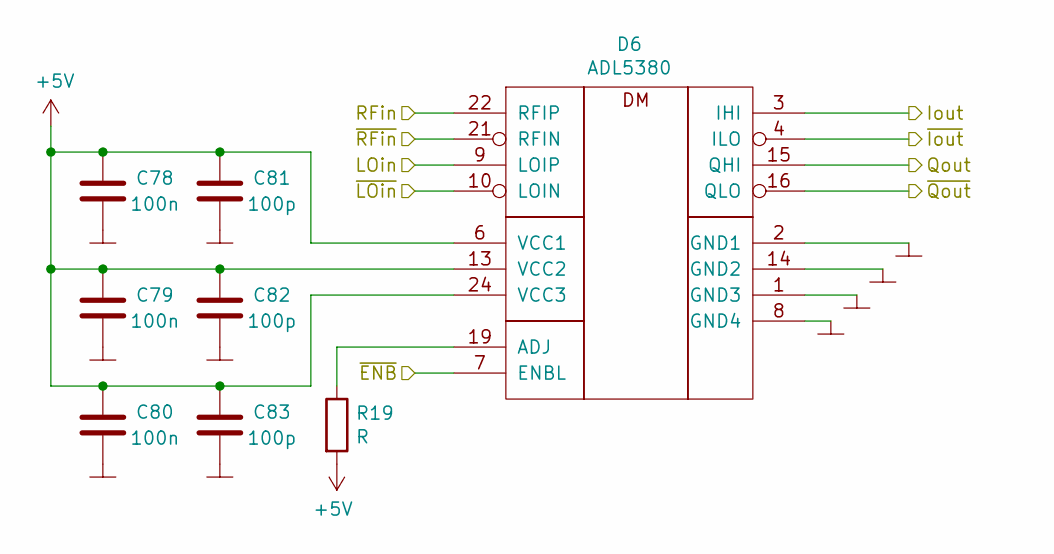
[picture p152: schematic Demodulator.sch, РЧ Модуль\\nСхема принципиальная]

Parts:
C78, C79, C80: 100n; C_1206_3216Metric_Pad1.33x1.80mm_HandSolder
C81, C82, C83: 100p; C_0805_2012Metric_Pad1.18x1.45mm_HandSolder
D6: ADL5380; LFCSP-24-1EP_4x4mm_P0.5mm_EP2.5x2.5mm_ThermalVias
R19: R; R_0805_2012Metric_Pad1.20x1.40mm_HandSolder

Connections:
+5V: C78.2, C79.2, C80.2, C81.2, C82.2, C83.2, D6.6 (VCC1), D6.13 (VCC2), D6.24 (VCC3), R19.2; also elsewhere on the board
/Demodulator_1/LOin: D6.9 (LOIP); also elsewhere on the board
/Demodulator_1/RFin: D6.22 (RFIP); also elsewhere on the board
/Demodulator_1/~ENB: D6.7 (ENBL); also elsewhere on the board
/Demodulator_1/~Iout: D6.4 (ILO); also elsewhere on the board
/Demodulator_1/~LOin: D6.10 (LOIN); also elsewhere on the board
/Demodulator_1/~Qout: D6.16 (QLO); also elsewhere on the board
/Demodulator_1/~RFin: D6.21 (RFIN); also elsewhere on the board
/Int_filter_1/IN1: D6.3 (IHI); also elsewhere on the board
/Int_filter_2/IN1: D6.15 (QHI); also elsewhere on the board
COMM: C78.1, C79.1, C80.1, C81.1, C82.1, C83.1, D6.1 (GND3), D6.2 (GND1), D6.5 (GND1), D6.8 (GND4), D6.11 (GND4), D6.14 (GND2), D6.17 (GND2), D6.18 (GND3), D6.20 (GND3), D6.23 (GND3), D6.25 (EP); also elsewhere on the board
unnamed: D6.19 (ADJ), R19.1

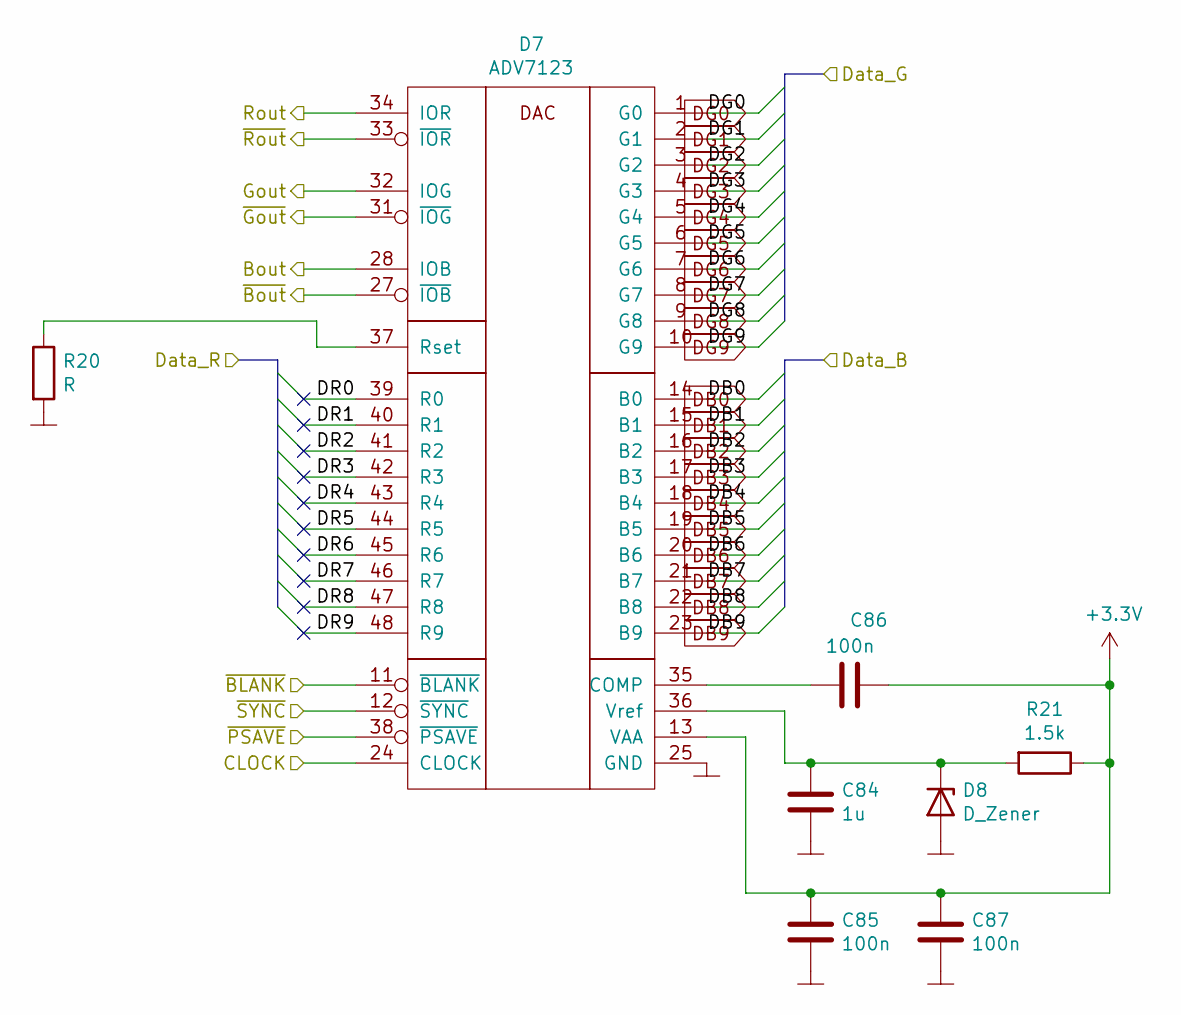
[picture p153: schematic DAC.sch, РЧ Модуль\\nСхема принципиальная]

Parts:
C84: 1u; C_1206_3216Metric_Pad1.33x1.80mm_HandSolder
C85, C86, C87: 100n; C_1206_3216Metric_Pad1.33x1.80mm_HandSolder
D7: ADV7123; LQFP-48_7x7mm_P0.5mm
D8: D_Zener; SOT-23
R20: R; R_0805_2012Metric_Pad1.20x1.40mm_HandSolder
R21: 1.5k; R_0805_2012Metric_Pad1.20x1.40mm_HandSolder

Connections:
+3V3: C85.1, C86.2, C87.1, D7.13 (VAA), D7.29 (VAA), D7.30 (VAA), R21.1; also elsewhere on the board
/Balanced_filter_1/IN2: D7.31 (~IOG); also elsewhere on the board
/Balanced_filter_2/IN2: D7.27 (~IOB); also elsewhere on the board
/DAC_1/Bout: D7.28 (IOB); also elsewhere on the board
/DAC_1/CLOCK: D7.24 (CLOCK); also elsewhere on the board
/DAC_1/DR0: D7.39 (R0)
/DAC_1/DR1: D7.40 (R1)
/DAC_1/DR2: D7.41 (R2)
/DAC_1/DR3: D7.42 (R3)
/DAC_1/DR4: D7.43 (R4)
/DAC_1/DR5: D7.44 (R5)
/DAC_1/DR6: D7.45 (R6)
/DAC_1/DR7: D7.46 (R7)
/DAC_1/DR8: D7.47 (R8)
/DAC_1/DR9: D7.48 (R9)
/DAC_1/Gout: D7.32 (IOG); also elsewhere on the board
/DAC_1/Rout: D7.34 (IOR)
/DAC_1/~BLANK: D7.11 (~BLANK); also elsewhere on the board
/DAC_1/~PSAVE: D7.38 (~PSAVE); also elsewhere on the board
/DAC_1/~Rout: D7.33 (~IOR)
/DAC_1/~SYNC: D7.12 (~SYNC); also elsewhere on the board
COMM: C84.2, C85.2, C87.2, D7.25 (GND), D7.26 (GND), D8.2 (A), R20.2; also elsewhere on the board
DB0: D7.14 (B0); also elsewhere on the board
DB1: D7.15 (B1); also elsewhere on the board
DB2: D7.16 (B2); also elsewhere on the board
DB3: D7.17 (B3); also elsewhere on the board
DB4: D7.18 (B4); also elsewhere on the board
DB5: D7.19 (B5); also elsewhere on the board
DB6: D7.20 (B6); also elsewhere on the board
DB7: D7.21 (B7); also elsewhere on the board
DB8: D7.22 (B8); also elsewhere on the board
DB9: D7.23 (B9); also elsewhere on the board
DG0: D7.1 (G0); also elsewhere on the board
DG1: D7.2 (G1); also elsewhere on the board
DG2: D7.3 (G2); also elsewhere on the board
DG3: D7.4 (G3); also elsewhere on the board
DG4: D7.5 (G4); also elsewhere on the board
DG5: D7.6 (G5); also elsewhere on the board
DG6: D7.7 (G6); also elsewhere on the board
DG7: D7.8 (G7); also elsewhere on the board
DG8: D7.9 (G8); also elsewhere on the board
DG9: D7.10 (G9); also elsewhere on the board
unnamed: C84.1, D7.36 (Vref), D8.1 (K), R21.2
unnamed: C86.1, D7.35 (COMP)
unnamed: D7.37 (Rset), R20.1

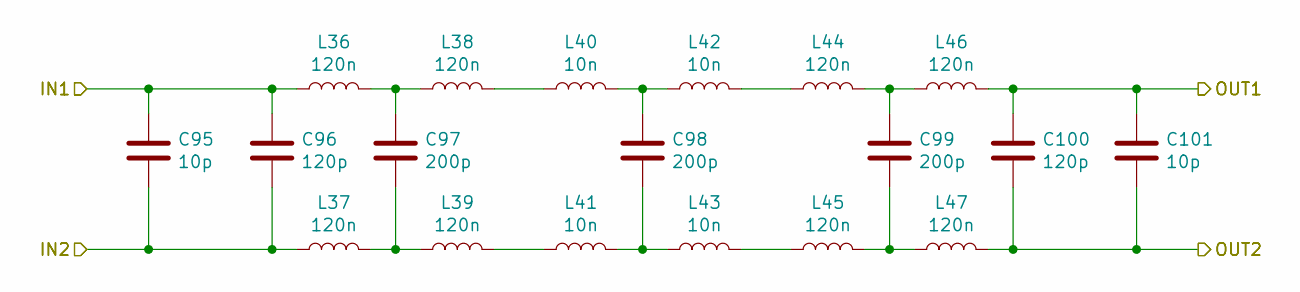
[picture p154: schematic Balanced_filter.sch, РЧ Модуль\\nСхема принципиальная]

Parts:
C88, C94: 10p; C_0805_2012Metric_Pad1.18x1.45mm_HandSolder
C89, C93: 120p; C_0805_2012Metric_Pad1.18x1.45mm_HandSolder
C90, C91, C92: 200p; C_0805_2012Metric_Pad1.18x1.45mm_HandSolder
L24, L25, L26, L27, L32, L33, L34, L35: 120n; L_0402_1005Metric_Pad0.77x0.64mm_HandSolder
L28, L29, L30, L31: 10n; L_0402_1005Metric_Pad0.77x0.64mm_HandSolder

Connections:
/Balanced_filter_1/IN2: C88.2, C89.2, L25.1; also elsewhere on the board
/Balanced_filter_1/OUT2: C93.2, C94.2, L35.2; also elsewhere on the board
/DAC_1/Gout: C88.1, C89.1, L24.1; also elsewhere on the board
/Modulator_1/Iin: C93.1, C94.1, L34.2; also elsewhere on the board
unnamed: C90.1, L24.2, L26.1
unnamed: C90.2, L25.2, L27.1
unnamed: C91.1, L28.2, L30.1
unnamed: C91.2, L29.2, L31.1
unnamed: C92.1, L32.2, L34.1
unnamed: C92.2, L33.2, L35.1
unnamed: L26.2, L28.1
unnamed: L27.2, L29.1
unnamed: L30.2, L32.1
unnamed: L31.2, L33.1

Parts of its further copies:
C95, C101: 10p; C_0805_2012Metric_Pad1.18x1.45mm_HandSolder
C96, C100: 120p; C_0805_2012Metric_Pad1.18x1.45mm_HandSolder
C97, C98, C99: 200p; C_0805_2012Metric_Pad1.18x1.45mm_HandSolder
L36, L37, L38, L39, L44, L45, L46, L47: 120n; L_0402_1005Metric_Pad0.77x0.64mm_HandSolder
L40, L41, L42, L43: 10n; L_0402_1005Metric_Pad0.77x0.64mm_HandSolder

Connections of its further copies:
/Balanced_filter_2/IN2: C95.2, C96.2, L37.1; also elsewhere on the board
/Balanced_filter_2/OUT1: C100.1, C101.1, L46.2; also elsewhere on the board
/Balanced_filter_2/OUT2: C100.2, C101.2, L47.2; also elsewhere on the board
/DAC_1/Bout: C95.1, C96.1, L36.1; also elsewhere on the board
unnamed: C97.1, L36.2, L38.1
unnamed: C97.2, L37.2, L39.1
unnamed: C98.1, L40.2, L42.1
unnamed: C98.2, L41.2, L43.1
unnamed: C99.1, L44.2, L46.1
unnamed: C99.2, L45.2, L47.1
unnamed: L38.2, L40.1
unnamed: L39.2, L41.1
unnamed: L42.2, L44.1
unnamed: L43.2, L45.1

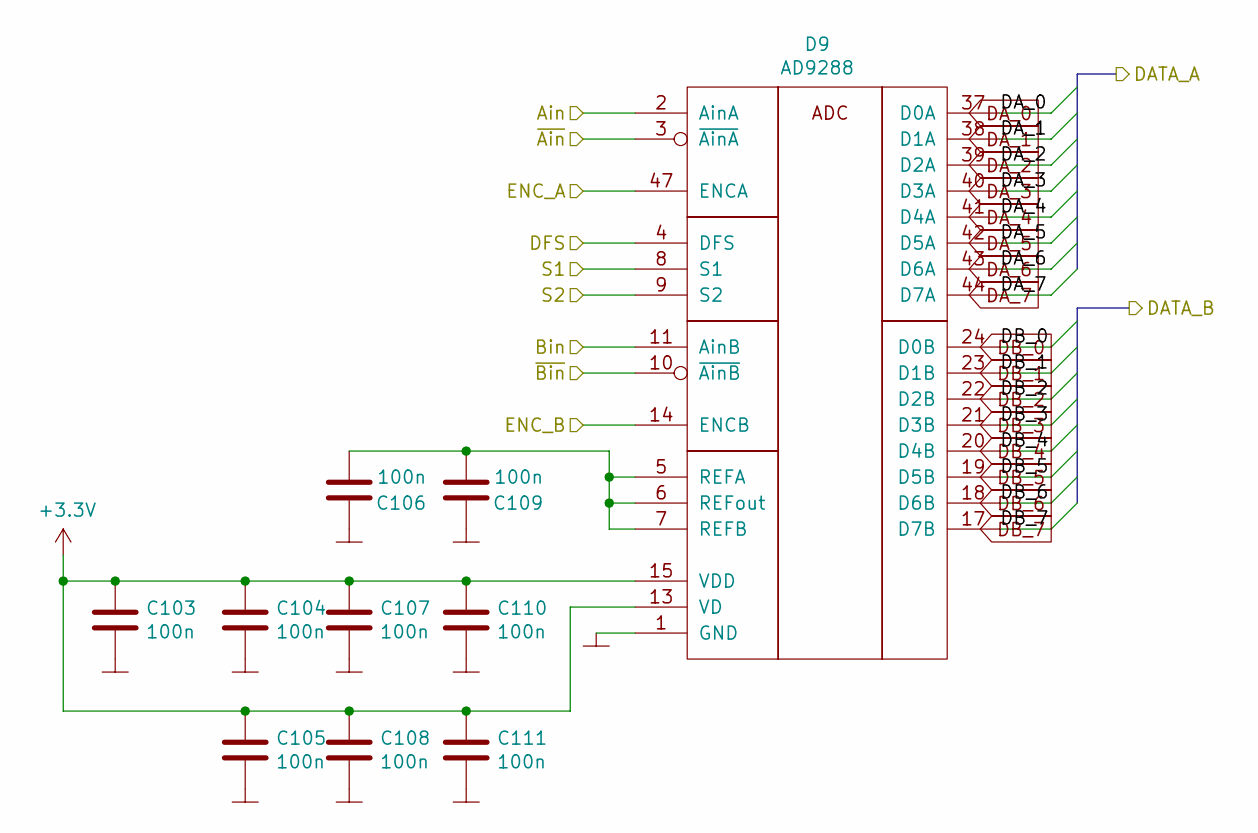
[picture p155: schematic ADC.sch, РЧ Модуль\\nСхема принципиальная]

Parts:
C103, C104, C105, C106, C107, C108, C109, C110, C111: 100n; C_1206_3216Metric_Pad1.33x1.80mm_HandSolder
D9: AD9288; LQFP-48_7x7mm_P0.5mm

Connections:
+3V3: C103.2, C104.2, C105.2, C107.2, C108.2, C110.2, C111.2, D9.13 (VD), D9.15 (VDD), D9.28 (VDD), D9.30 (VD), D9.31 (VD), D9.33 (VDD), D9.46 (VDD), D9.48 (VD); also elsewhere on the board
/ADC_1/Ain: D9.2 (AinA); also elsewhere on the board
/ADC_1/Bin: D9.11 (AinB); also elsewhere on the board
/ADC_1/DFS: D9.4 (DFS); also elsewhere on the board
/ADC_1/ENC_A: D9.14 (ENCB), D9.47 (ENCA); also elsewhere on the board
/ADC_1/S1: D9.8 (S1); also elsewhere on the board
/ADC_1/S2: D9.9 (S2); also elsewhere on the board
/ADC_1/~Ain: D9.3 (~AinA); also elsewhere on the board
/ADC_1/~Bin: D9.10 (~AinB); also elsewhere on the board
COMM: C103.1, C104.1, C105.1, C106.2, C107.1, C108.1, C109.2, C110.1, C111.1, D9.1 (GND), D9.12 (GND), D9.16 (GND), D9.27 (GND), D9.29 (GND), D9.32 (GND), D9.34 (GND), D9.45 (GND); also elsewhere on the board
DA_0: D9.37 (D0A); also elsewhere on the board
DA_1: D9.38 (D1A); also elsewhere on the board
DA_2: D9.39 (D2A); also elsewhere on the board
DA_3: D9.40 (D3A); also elsewhere on the board
DA_4: D9.41 (D4A); also elsewhere on the board
DA_5: D9.42 (D5A); also elsewhere on the board
DA_6: D9.43 (D6A); also elsewhere on the board
DA_7: D9.44 (D7A); also elsewhere on the board
DB_0: D9.24 (D0B); also elsewhere on the board
DB_1: D9.23 (D1B); also elsewhere on the board
DB_2: D9.22 (D2B); also elsewhere on the board
DB_3: D9.21 (D3B); also elsewhere on the board
DB_4: D9.20 (D4B); also elsewhere on the board
DB_5: D9.19 (D5B); also elsewhere on the board
DB_6: D9.18 (D6B); also elsewhere on the board
DB_7: D9.17 (D7B); also elsewhere on the board
unnamed: C106.1, C109.1, D9.5 (REFA), D9.6 (REFout), D9.7 (REFB)
