BYakov/Rx-Tx_module/PCB/SDR/SDR.kicad_pcb

## KiCad design PCB/SDR/SDR.kicad_pcb (continued)

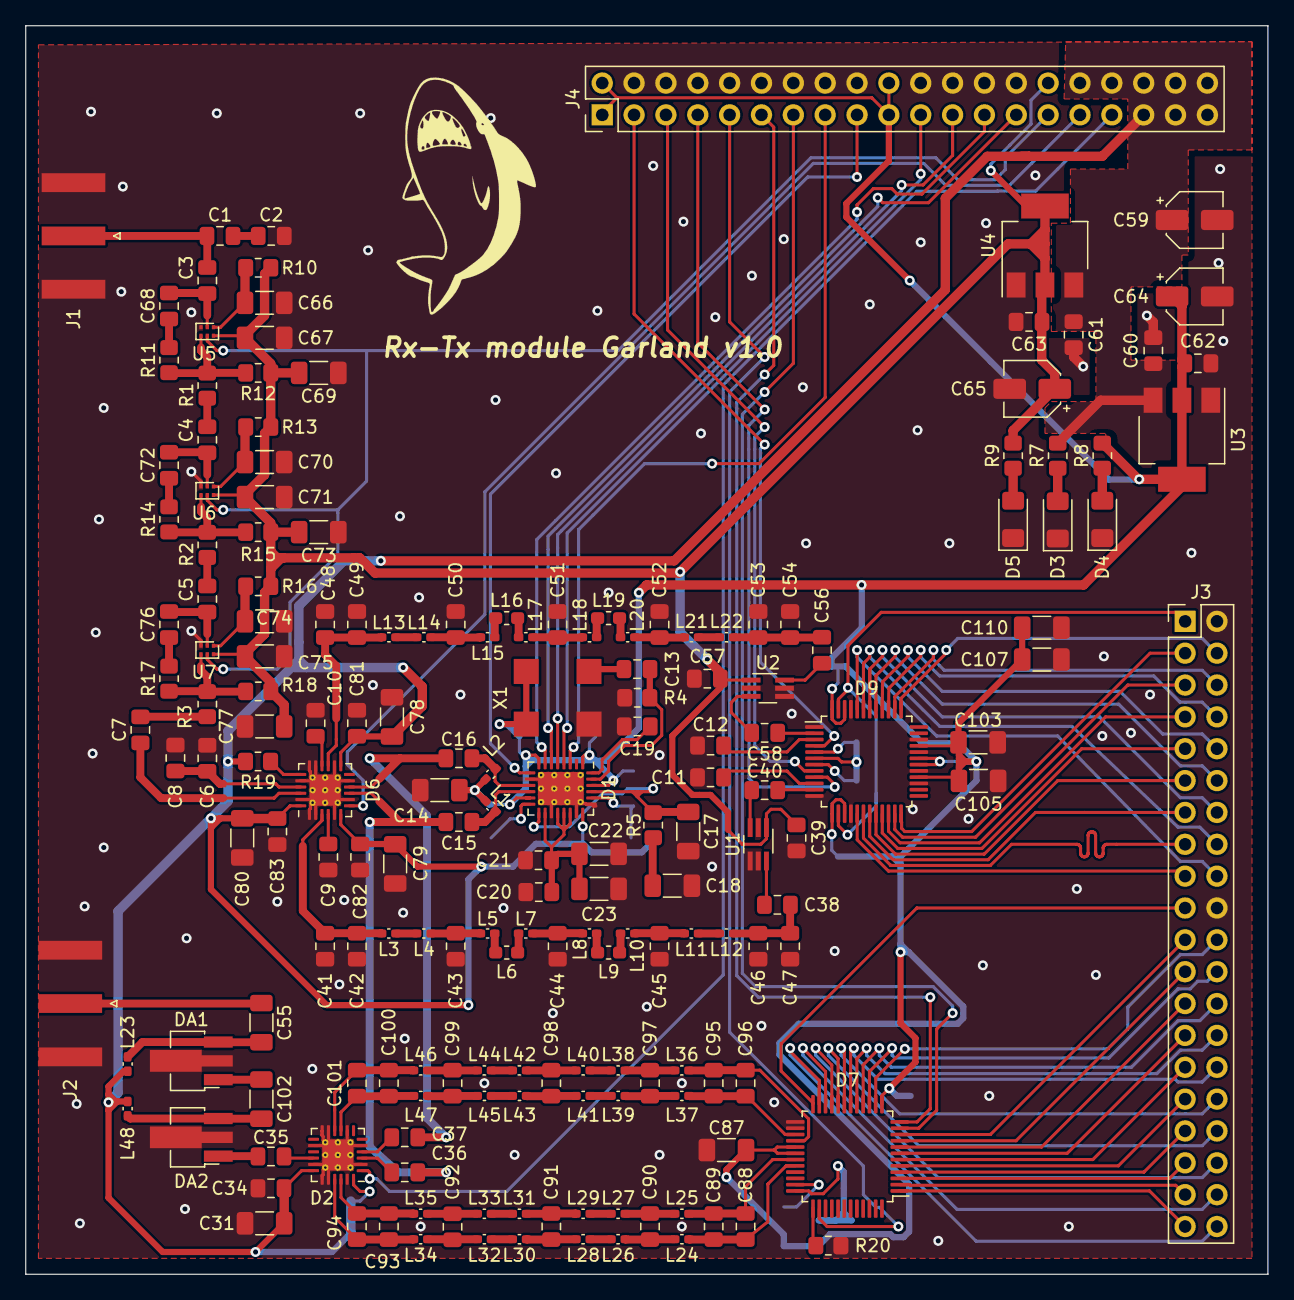
[picture p156: board SDR.kicad_pcb from above]

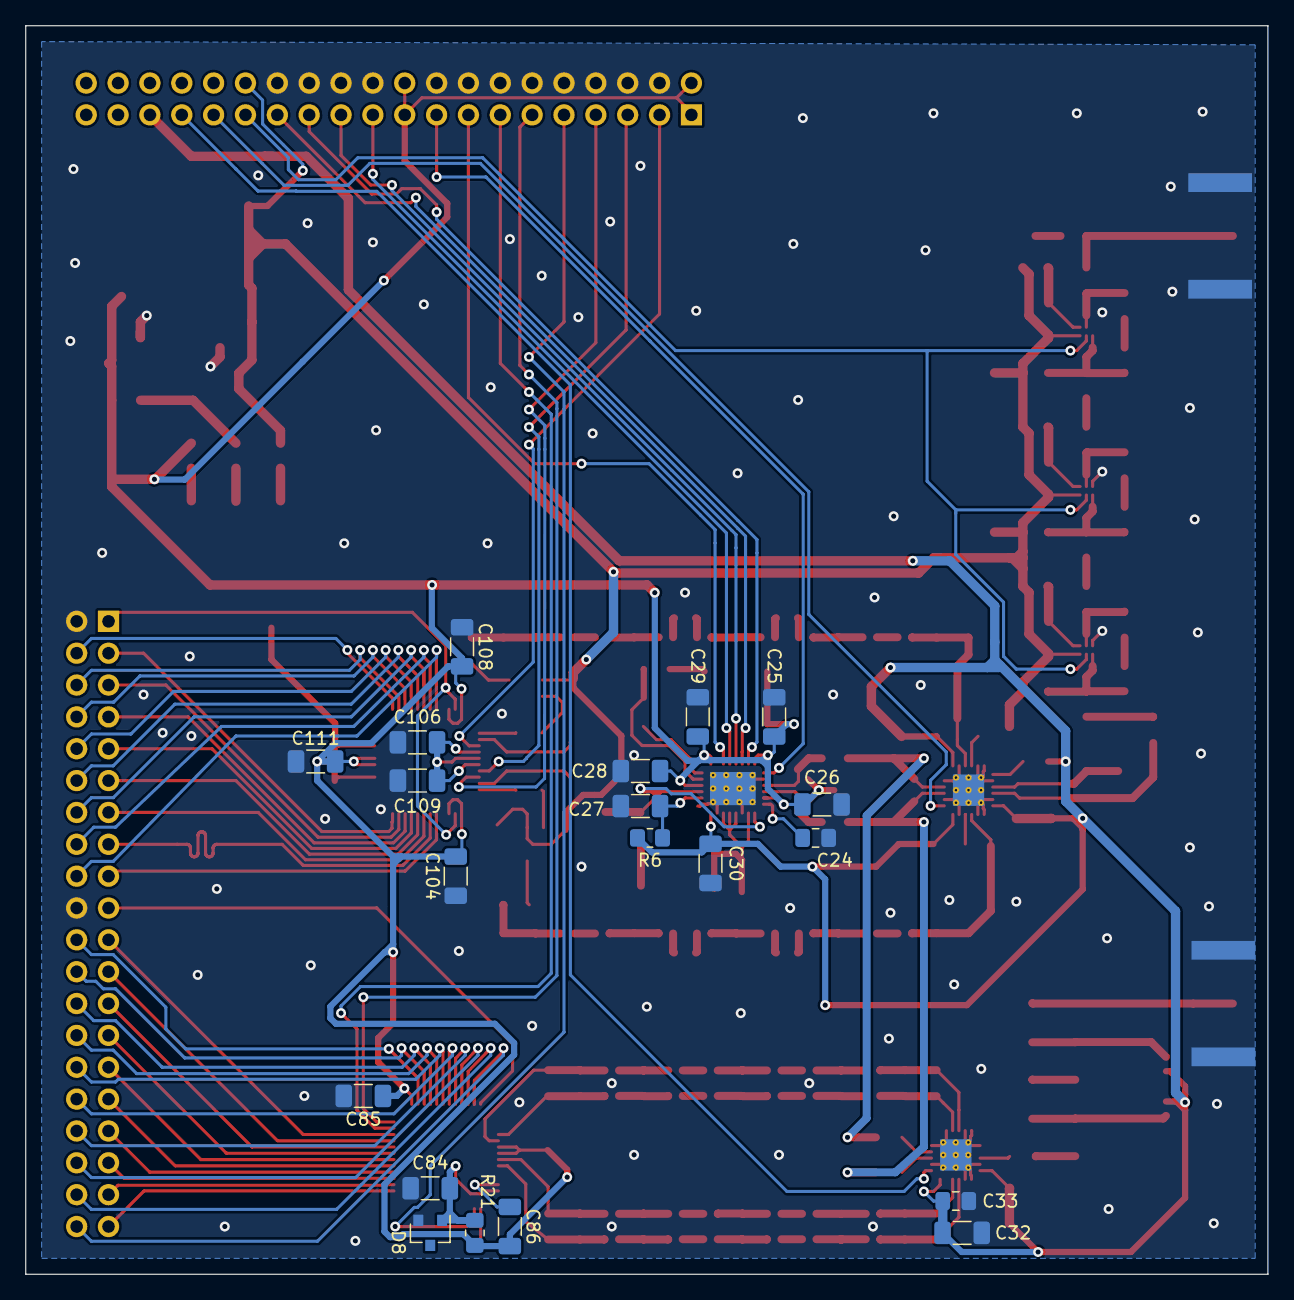
[picture p157: board SDR.kicad_pcb from below]

Board: 2 copper layers, 99.1 x 99.6 mm, 203 parts (20 on the bottom side), 164 nets.
